spacelab-ufsc/obdh2/README.md

<h1 align="center">
	ON-BOARD DATA HANDLING 2.0
	<br>
</h1>

<h4 align="center">On-board computer module designed and developed by SpaceLab.</h4>

<p align="center">
	<a href="https://github.com/spacelab-ufsc/spacelab#versioning">
		
	</a>
	<a href="https://github.com/spacelab-ufsc/obdh2/releases">
		
	</a>
	<a href="https://github.com/spacelab-ufsc/obdh2/releases">
		
	</a>
	<a href="https://github.com/spacelab-ufsc/obdh2/commits/master">
		
	</a>
	<a href="https://github.com/spacelab-ufsc/obdh2/issues">
		
	</a>
	<a href="https://github.com/spacelab-ufsc/obdh2/graphs/contributors">
		
	</a>
</p>

<p align="center">
    <a href="#overview">Overview</a> •
    <a href="#repository-organization">Repository Organizarion</a> •
    <a href="#documentation">Documentation</a> •
    <a href="#license">License</a> •
    <a href="#releases">Releases</a> •
    <a href="#notes">Notes</a>
</p>

<p align="center">
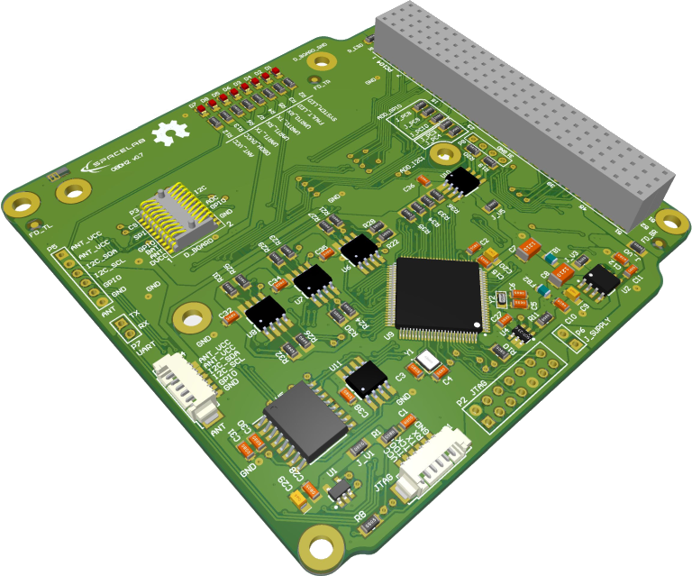
[picture p1: doc/user_manual/img/obdh2-pcb-3d.png]
	
</p>

## Overview

The SpaceLab OBDH 2.0 (On-Board Data Handling 2.0) is one of the service modules developed for the FloripaSat-2 Cubesat platform. The OBDH 2.0 is responsible to synchronize actions and the data flow between other modules (ie. EPS, Payloads) and the Earth segment. It packs the generated data into data frames and transmit back to Earth through TTC module, or stores it on a non-volatile memory for later retrieval. Commands sent from Earth segment to the CubeSat will be received by the radio transceivers located in the TTC module and redirected to the OBDH 2.0, which takes the appropriate action or forward them to the responsible module.

## Repository Organization

- **doc**: Technical documentation (including an user manual and an slide presentation).
- **firmware**: Source files of the firmware project.
- **hardware**: Source files of the hardware project.

## Documentation

The main documentation of the project can be seen [here](https://spacelab-ufsc.github.io/obdh2/).

## License

This project is open-source under three different licenses: GNU General Public License v3.0 for firmware sources, CERN Open Hardware License v2.0 for hardware files, and CC BY-SA 4.0 for the documentation. Some third-part files and libraries are subjected to their specific terms and licenses.

## Releases

The OBDH 2.0 software and hardware releases are synchronized in order to garantee compatibility. Then, using diferent versions might lead to unpredictable behavior. Refer to the [documentation](https://spacelab-ufsc.github.io/obdh2/) for compatibility notes.

## Notes

More info about the SpaceLab: [GitHub](https://github.com/spacelab-ufsc/spacelab) or [Website](https://spacelab.ufsc.br/)
