spacelab-ufsc/obdh2/firmware/drivers/cy15x102qn/README.md

# Cypress CY15V102QN/CY15B102QN FRAM Memory Driver
