spacelab-ufsc/obdh2/firmware/drivers/tps382x/README.md

# TPS382x Voltage Monitor With Watchdog Timer

If WDI remains high or low longer than the timeout period, then reset is triggered. The timer clears when reset is asserted or when WDI sees a rising edge or a falling edge.

## Reference

[1](https://www.ti.com/lit/ds/symlink/tps3828.pdf) SLVS165L - TPS382x Voltage Monitor With Watchdog Timer
