spacelab-ufsc/obdh2/doc/presentation/sections/documentation.tex

%
% documentation.tex
%
% Copyright (C) 2022 by SpaceLab.
%
% OBDH 2.0 Module
%
% This work is licensed under the Creative Commons Attribution-ShareAlike 4.0
% International License. To view a copy of this license,
% visit http://creativecommons.org/licenses/by-sa/4.0/.
%

%
% \brief Documentation slides.
%
% \author Gabriel Mariano Marcelino <gabriel.mm8@gmail.com>
% \author Bruno Benedetti <brunobenedetti45@gmail.com>
%
% \version 0.1.0
%
% \date 2022/08/07
%

\begin{frame}{Documentation}

    \begin{itemize}
        \item User manual (PDF)
        \vspace{0.4cm}
        \item This presentation
        \vspace{0.4cm}
        \item Schematics
        \vspace{0.4cm}
        \item Firmware: Doxygen
    \end{itemize}

\end{frame}
