spacelab-ufsc/obdh2/doc/presentation/sections/management.tex

%
% management.tex
%
% Copyright (C) 2022 by SpaceLab.
%
% OBDH 2.0 Module
%
% This work is licensed under the Creative Commons Attribution-ShareAlike 4.0
% International License. To view a copy of this license,
% visit http://creativecommons.org/licenses/by-sa/4.0/.
%

%
% \brief Project management slides.
%
% \author Gabriel Mariano Marcelino <gabriel.mm8@gmail.com>
% \author Bruno Benedetti <brunobenedetti45@gmail.com>
%
% \version 0.1.0
%
% \date 2022/07/28
%

\begin{frame}{Project Management}

    \begin{itemize}
        \item Activities, tasks and bug report: GitHub issues/project
        \vspace{0.25cm}
        \item Source files and versioning control: Public \href{https://github.com/spacelab-ufsc/obdh2}{\textcolor{blue}{Git repository}} with three development branches:
            \begin{itemize}
                \item \textit{dev\_doc}: Documentation
                \item \textit{dev\_hardware}: Hardware project
                \item \textit{dev\_firmware}: Firmware project
            \end{itemize}
    \end{itemize}

    \begin{figure}[!ht]
        \begin{center}
            
        \end{center}
    \end{figure}

\end{frame}
