spacelab-ufsc/obdh2/hardware/outputs/board_drc/board_drc.html

Altium

# Design Rule Verification Report

Date: | | 6/4/2021
Time: | | 4:35:57 PM
Elapsed Time: | | 00:00:02
Filename: | | C:\Users\Yan Azeredo\Desktop\SpaceLab\obdh2\hardware\sources\board_layout.pcbdoc

Warnings: | | 0
Rule Violations: | | 0

## Summary

Warnings | Count
Total | 0

Rule Violations | Count
Clearance Constraint (Gap=10mil) (InNet('GND')),(All) | 0
Clearance Constraint (Gap=7mil) (All),(All) | 0
Clearance Constraint (Gap=10mil) (OnLayer('Multi-Layer')),(OnLayer('Keep-Out Layer')) | 0
Clearance Constraint (Gap=10mil) (InNet('ESD') And OnLayer('Multi-Layer')),(OnLayer('Keep-Out Layer')) | 0
Short-Circuit Constraint (Allowed=No) (All),(All) | 0
Un-Routed Net Constraint ( (All) ) | 0
Width Constraint (Min=5mil) (Max=70mil) (Preferred=10mil) (All) | 0
Width Constraint (Min=20mil) (Max=30mil) (Preferred=20mil) (InNetClass('Power')) | 0
Routing Layers(All) | 0
Routing Via (MinHoleWidth=11.811mil) (MaxHoleWidth=35.433mil) (PreferredHoleWidth=11.811mil) (MinWidth=23.622mil) (MaxWidth=59.055mil) (PreferedWidth=23.622mil) (All) | 0
Power Plane Connect Rule(Relief Connect )(Expansion=20mil) (Conductor Width=10mil) (Air Gap=10mil) (Entries=4) (All) | 0
Power Plane Connect Rule(Direct Connect )(Expansion=20mil) (Conductor Width=10mil) (Air Gap=10mil) (Entries=4) (InNetClass('power')) | 0
Hole Size Constraint (Min=1mil) (Max=200mil) (All) | 0
Hole To Hole Clearance (Gap=10mil) (All),(All) | 0
Minimum Solder Mask Sliver (Gap=0mil) (All),(All) | 0
Silk To Solder Mask (Clearance=0mil) (IsPad),(All) | 0
Silk to Silk (Clearance=5mil) (All),(All) | 0
Net Antennae (Tolerance=0mil) (All) | 0
Component Clearance Constraint ( Horizontal Gap = 10mil, Vertical Gap = 10mil ) (All),(All) | 0
Height Constraint (Min=0mil) (Max=1000mil) (Prefered=500mil) (All) | 0
Total | 0
