spacelab-ufsc/obdh2/doc/presentation/figures/brazil-south.jpeg

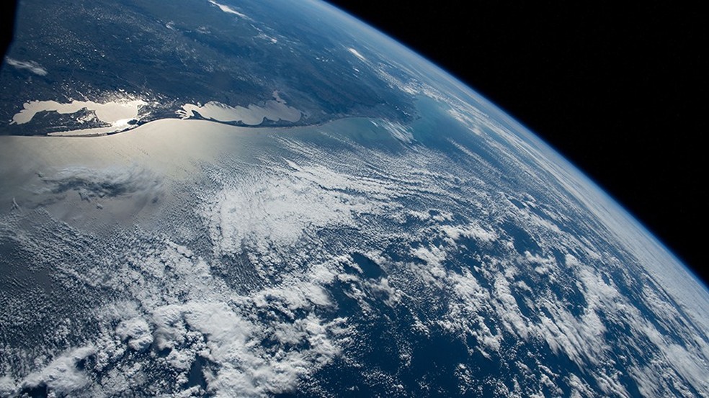
doc/presentation/figures/brazil-south.jpeg
