spacelab-ufsc/obdh2/firmware/doc/spacelab.png

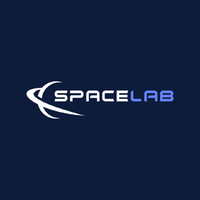
firmware/doc/spacelab.png
