spacelab-ufsc/obdh2/hardware/images/0_db_layout_position.png

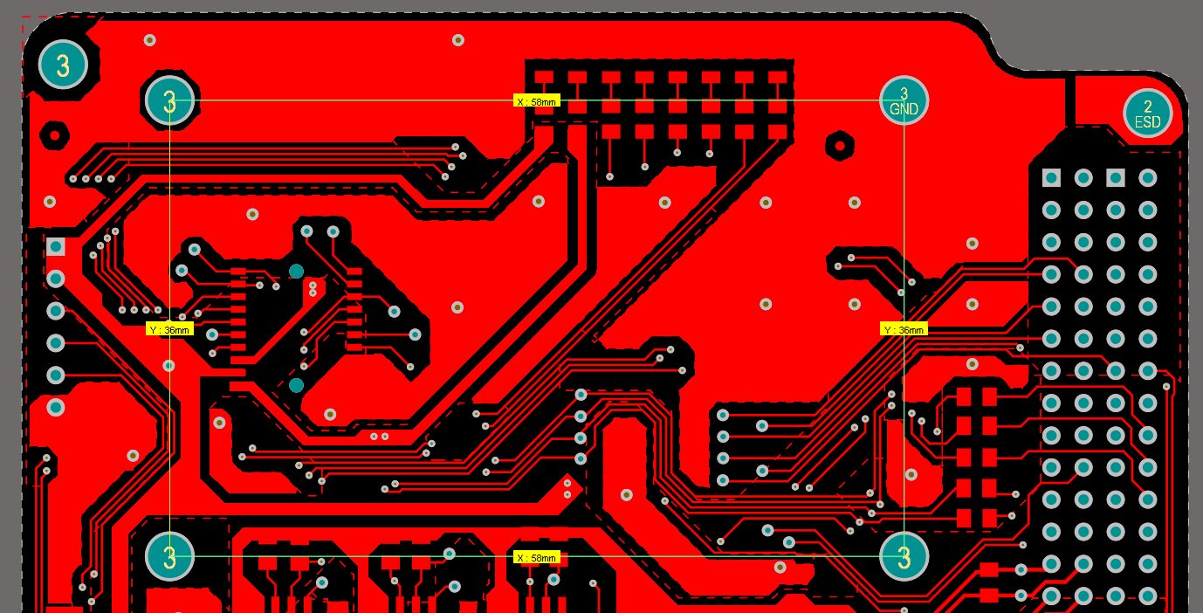
hardware/images/0_db_layout_position.png
