spacelab-ufsc/obdh2/hardware/images/1_db_board_position.png

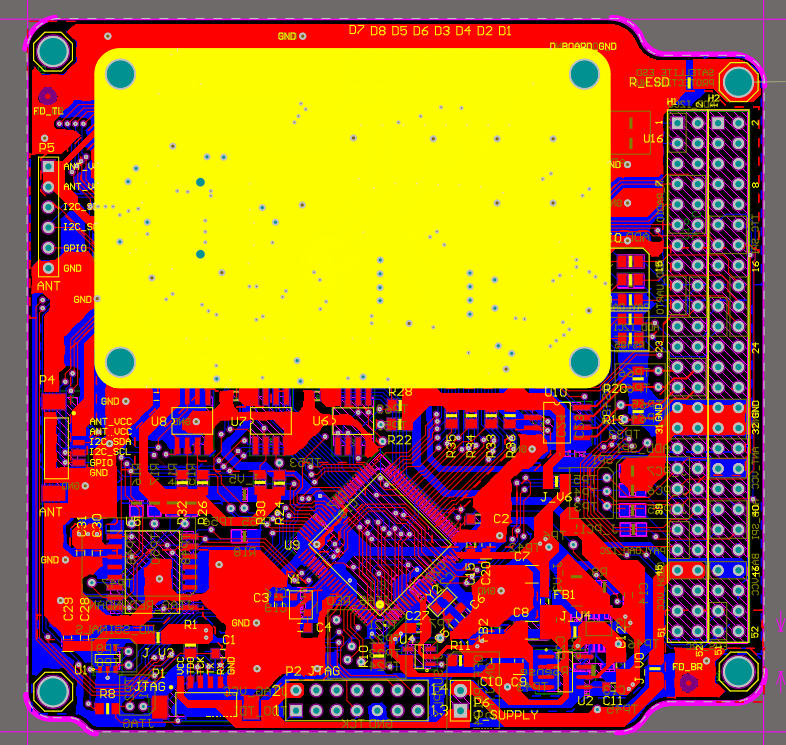
hardware/images/1_db_board_position.png
