spacelab-ufsc/obdh2/hardware/images/2_db_board_size.png

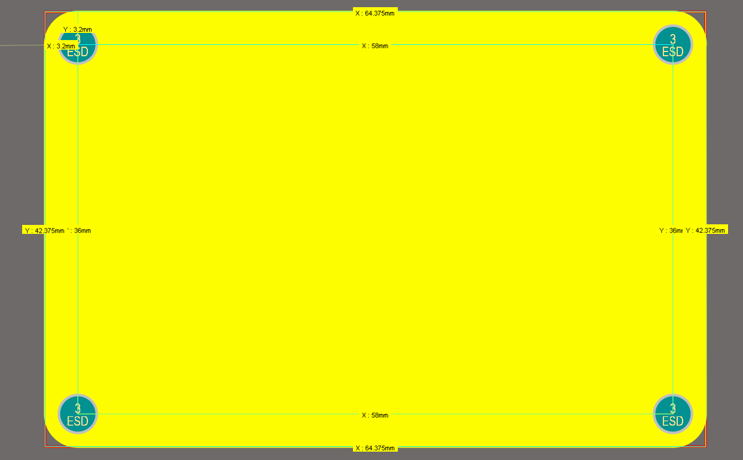
hardware/images/2_db_board_size.png
