spacelab-ufsc/obdh2/hardware/images/3_db_connector_position.png

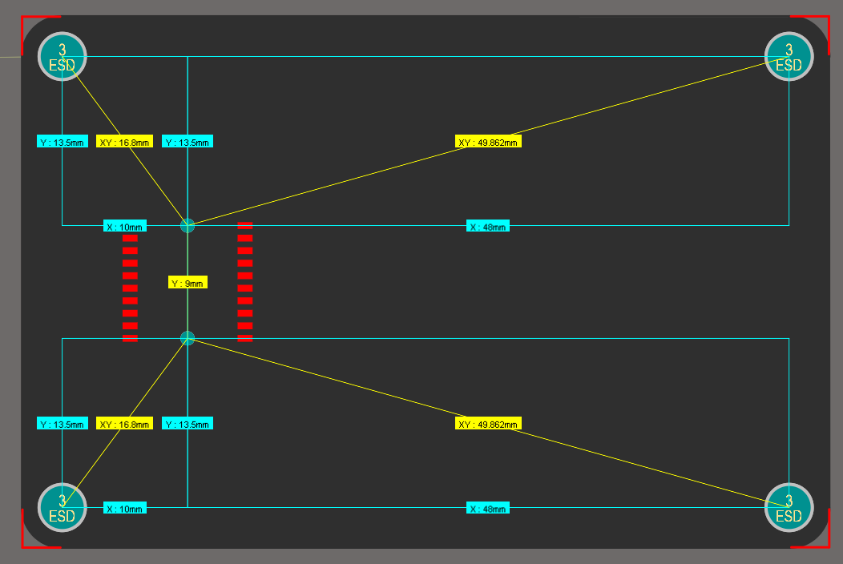
hardware/images/3_db_connector_position.png
