spacelab-ufsc/obdh2/hardware/images/4_db_connector_size.png

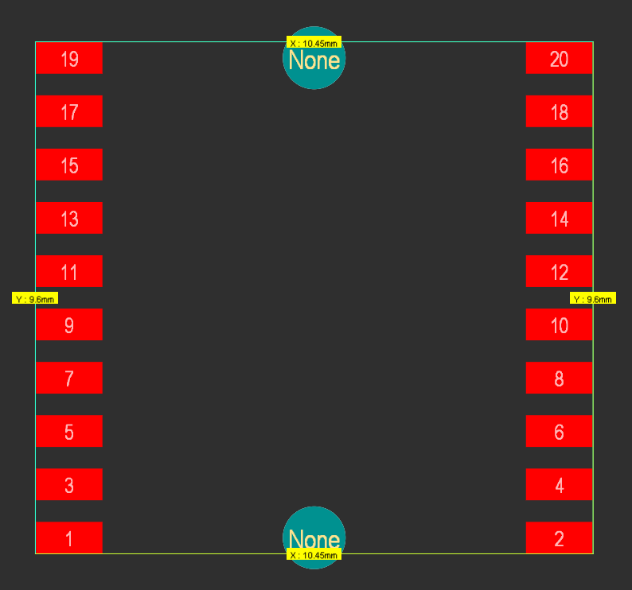
hardware/images/4_db_connector_size.png
