spacelab-ufsc/obdh2/hardware/images/5_db_pads_position.png

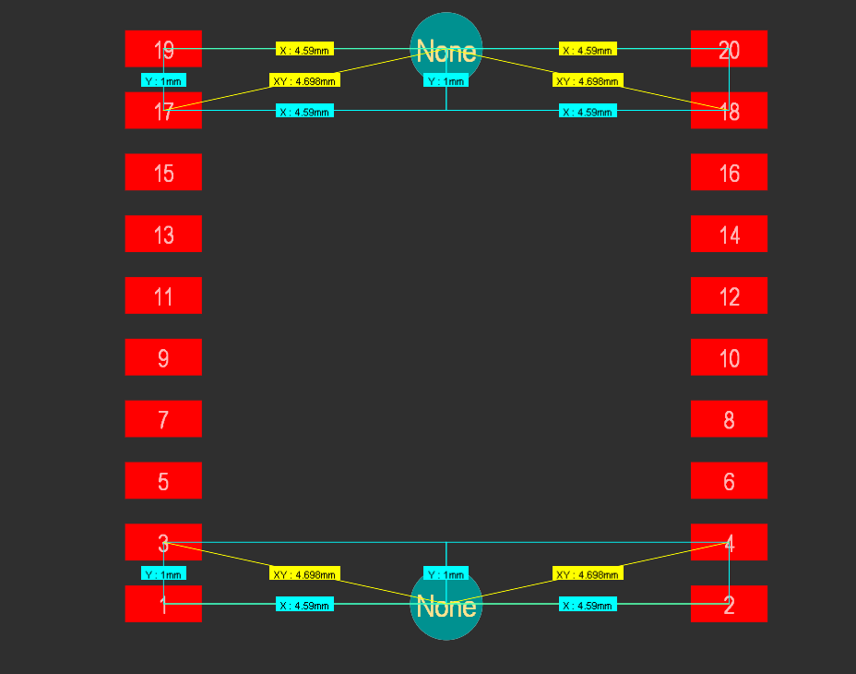
hardware/images/5_db_pads_position.png
