spacelab-ufsc/obdh2/hardware/images/6_db_pads_size.png

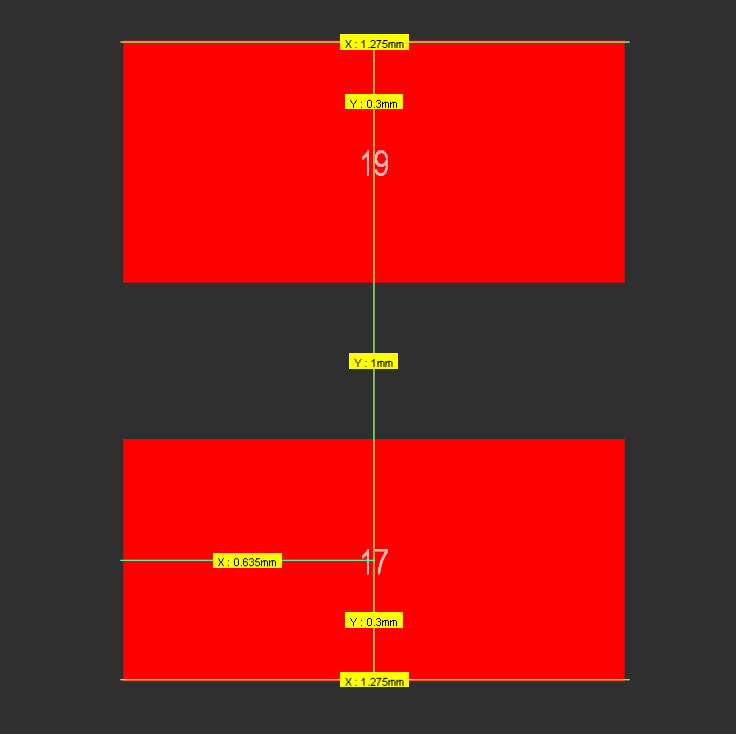
hardware/images/6_db_pads_size.png
