spacelab-ufsc/obdh2/hardware/images/7_db_connector_hole_size.png

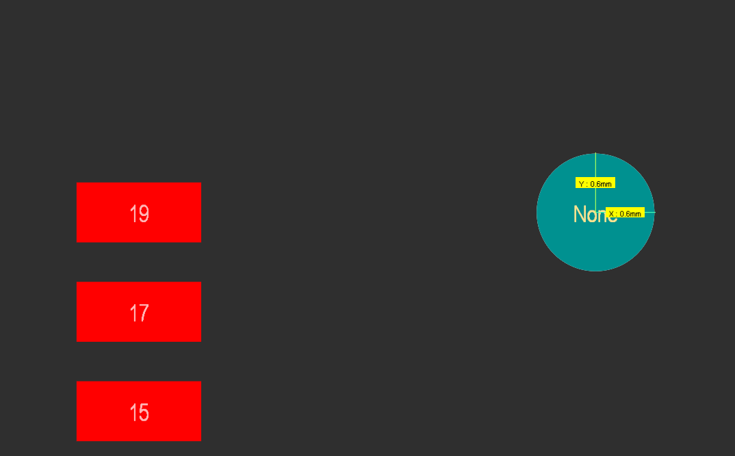
hardware/images/7_db_connector_hole_size.png
