spacelab-ufsc/obdh2/hardware/images/8_db_obdh_board_nut_size.png

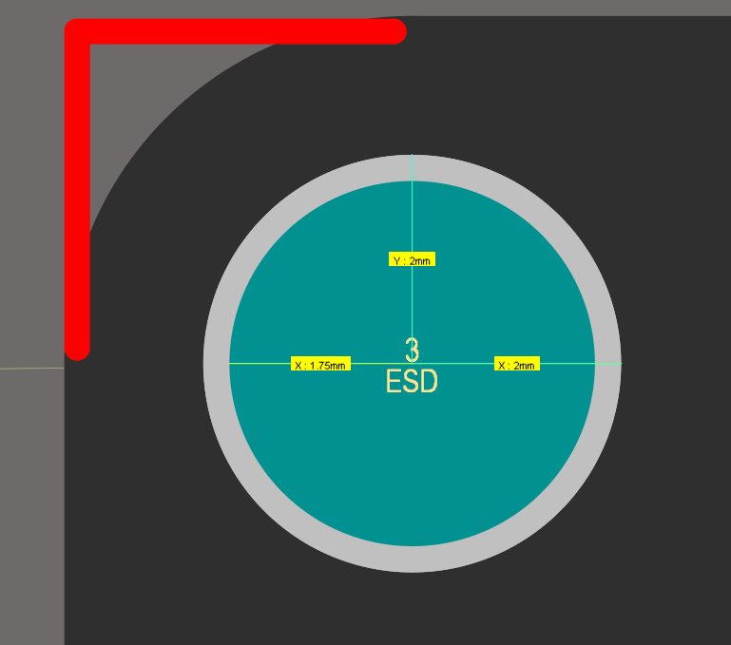
hardware/images/8_db_obdh_board_nut_size.png
