spacelab-ufsc/obdh2/hardware/images/power_architecture_v05.png

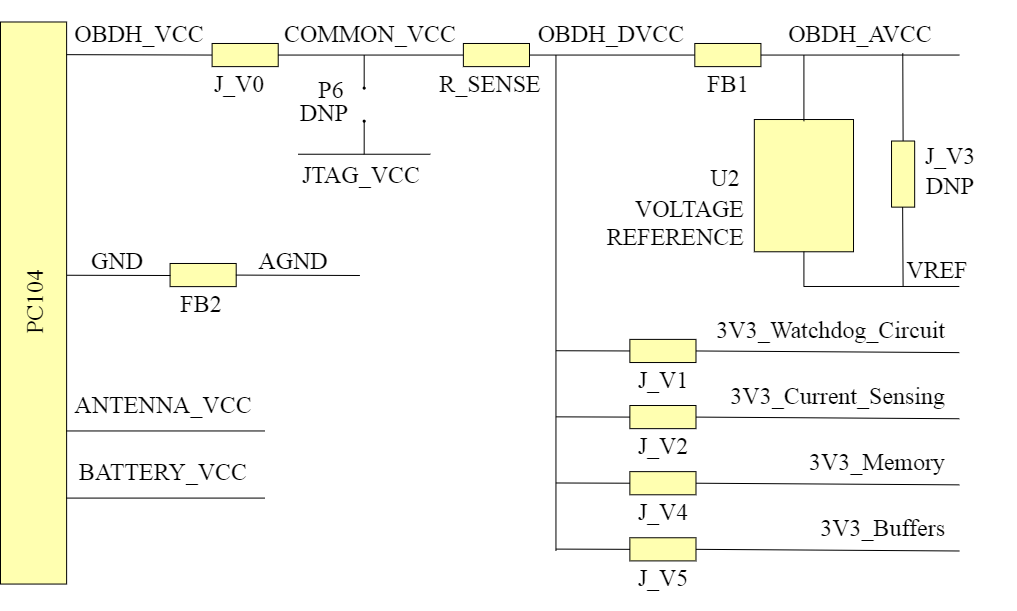
hardware/images/power_architecture_v05.png
