spacelab-ufsc/obdh2/doc/user_manual/index.rst

.. index.rst

   Copyright The OBDH 2.0 Contributors.

   OBDH 2.0 Documentation

   This work is licensed under the Creative Commons Attribution-ShareAlike 4.0
   International License. To view a copy of this license,
   visit http://creativecommons.org/licenses/by-sa/4.0/.

********
OBDH 2.0
********

The OBDH 2.0 is an on-board computer module designed by SpaceLab for nanosatellite missions. This manual describes its architecture, hardware, firmware, assembly, operation, telemetry, communication packets, and hardware test results.

.. toctree::
   :maxdepth: 3
   :caption: Documentation

   introduction
   system_overview
   hardware
   firmware
   assembly
   instructions
   references

.. toctree::
   :maxdepth: 3
   :caption: Appendix

   telemetry
   packets
   test_report_v05
   test_report_v07
