spacelab-ufsc/obdh2/doc/user_manual/img/system_layers.pdf

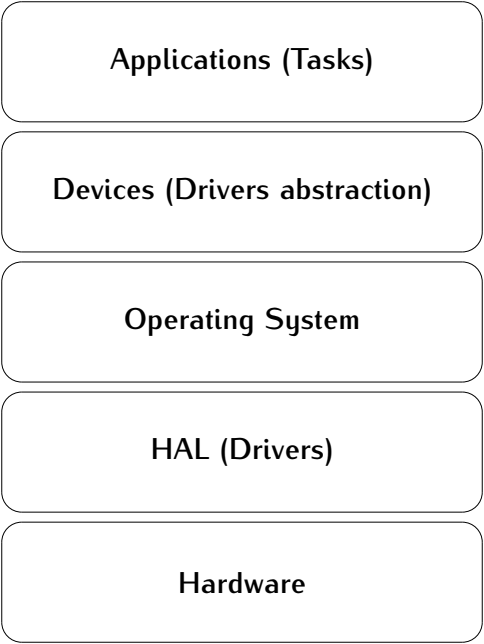
[picture p67: figure]

HAL (Drivers) Operating System Devices (Drivers abstraction) Applications (Tasks) Hardware
