spacelab-ufsc/obdh2/doc/user_manual/README.md

<h1 align="center">
    OBDH2 DOCUMENTATION
    <br>
</h1>

<h4 align="center">Documentation of the OBDH2 Module.</h4>

<p align="center">
    <a href="https://github.com/spacelab-ufsc/spacelab#versioning">
        
    </a>
    <a href="https://github.com/spacelab-ufsc/obdh2/releases">
        
    </a>
    <a href="https://github.com/spacelab-ufsc/obdh2/actions">
        
    </a>
    <a href="">
        
    </a>
    <a href="#license">
        
    </a>
</p>

<p align="center">
    <a href="#dependencies">Dependencies</a> •
    <a href="#building">Building</a> •
    <a href="#license">License</a>
</p>

## Dependencies

The Python dependencies required to build this documentation are listed in [`requirements.txt`](requirements.txt):

* [sphinx-rtd-theme](https://pypi.org/project/sphinx-rtd-theme/)
* [sphinxcontrib-bibtex](https://pypi.org/project/sphinxcontrib-bibtex/)
* [sphinx-subfigure](https://pypi.org/project/sphinx-subfigure/)

## Building

After installing the dependencies, generate the HTML documentation with:

```sh
make html
```

### Generating the PDF file

With a LaTeX toolchain installed, run:

```sh
make latexpdf
```

## License

This documentation is licensed under the Creative Commons Attribution-ShareAlike 4.0 International license (CC BY-SA 4.0).
