spacelab-ufsc/obdh2/doc/user_manual/pdf-index.rst

.. pdf-index.rst

   Copyright The OBDH 2.0 Contributors.

   OBDH 2.0 Documentation

   This work is licensed under the Creative Commons Attribution-ShareAlike 4.0
   International License. To view a copy of this license,
   visit http://creativecommons.org/licenses/by-sa/4.0/.

**********************
OBDH 2.0 Documentation
**********************

.. toctree::
   :maxdepth: 3

   introduction
   system_overview
   hardware
   firmware
   assembly
   instructions
   references

.. raw:: latex

   \begin{appendices}

.. toctree::
   :maxdepth: 3

   telemetry
   packets
   test_report_v05
   test_report_v07

.. raw:: latex

   \end{appendices}
