spacelab-ufsc/obdh2/doc/user_manual/img/data_path_diagram.png

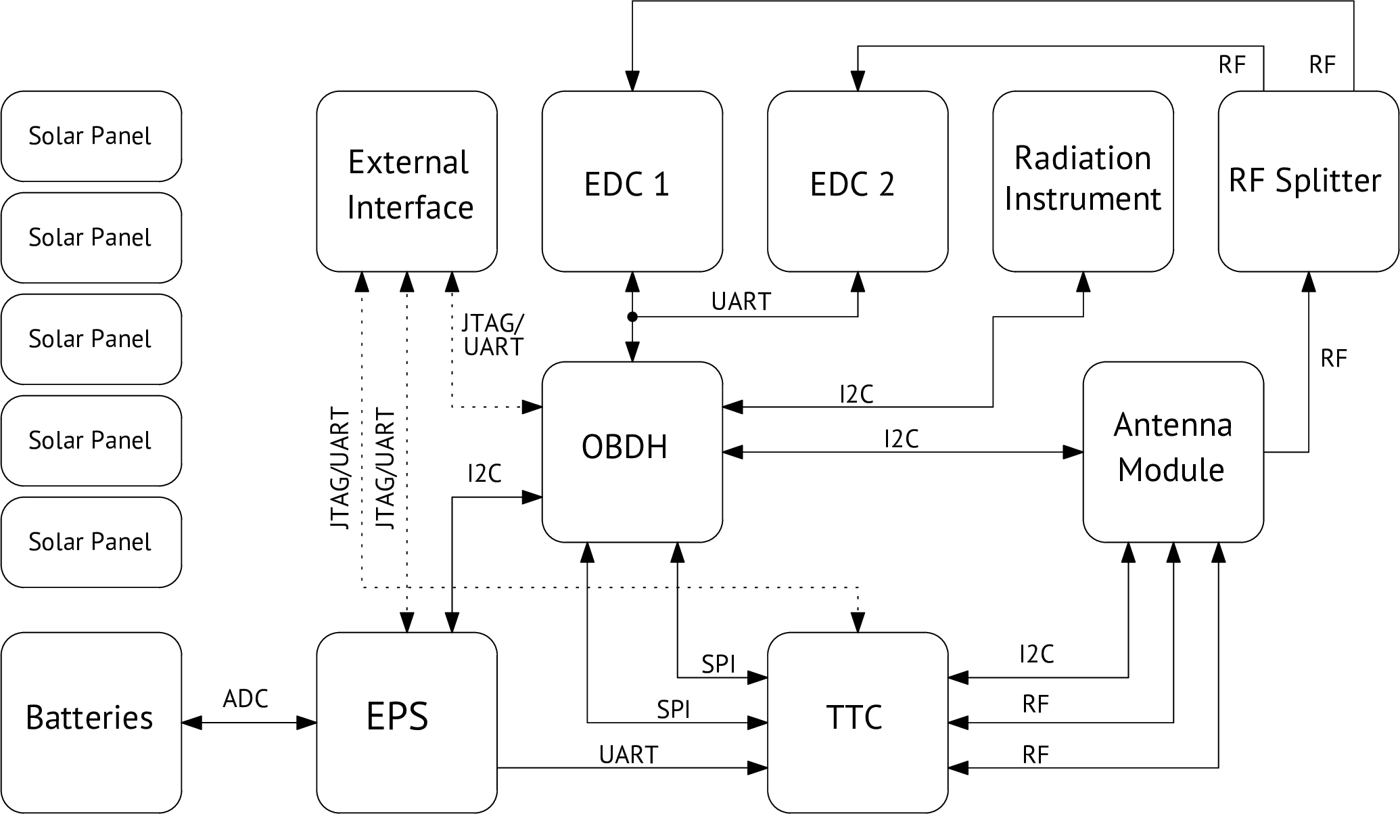
doc/user_manual/img/data_path_diagram.png
