spacelab-ufsc/obdh2/doc/user_manual/img/diagram_interfaces.png

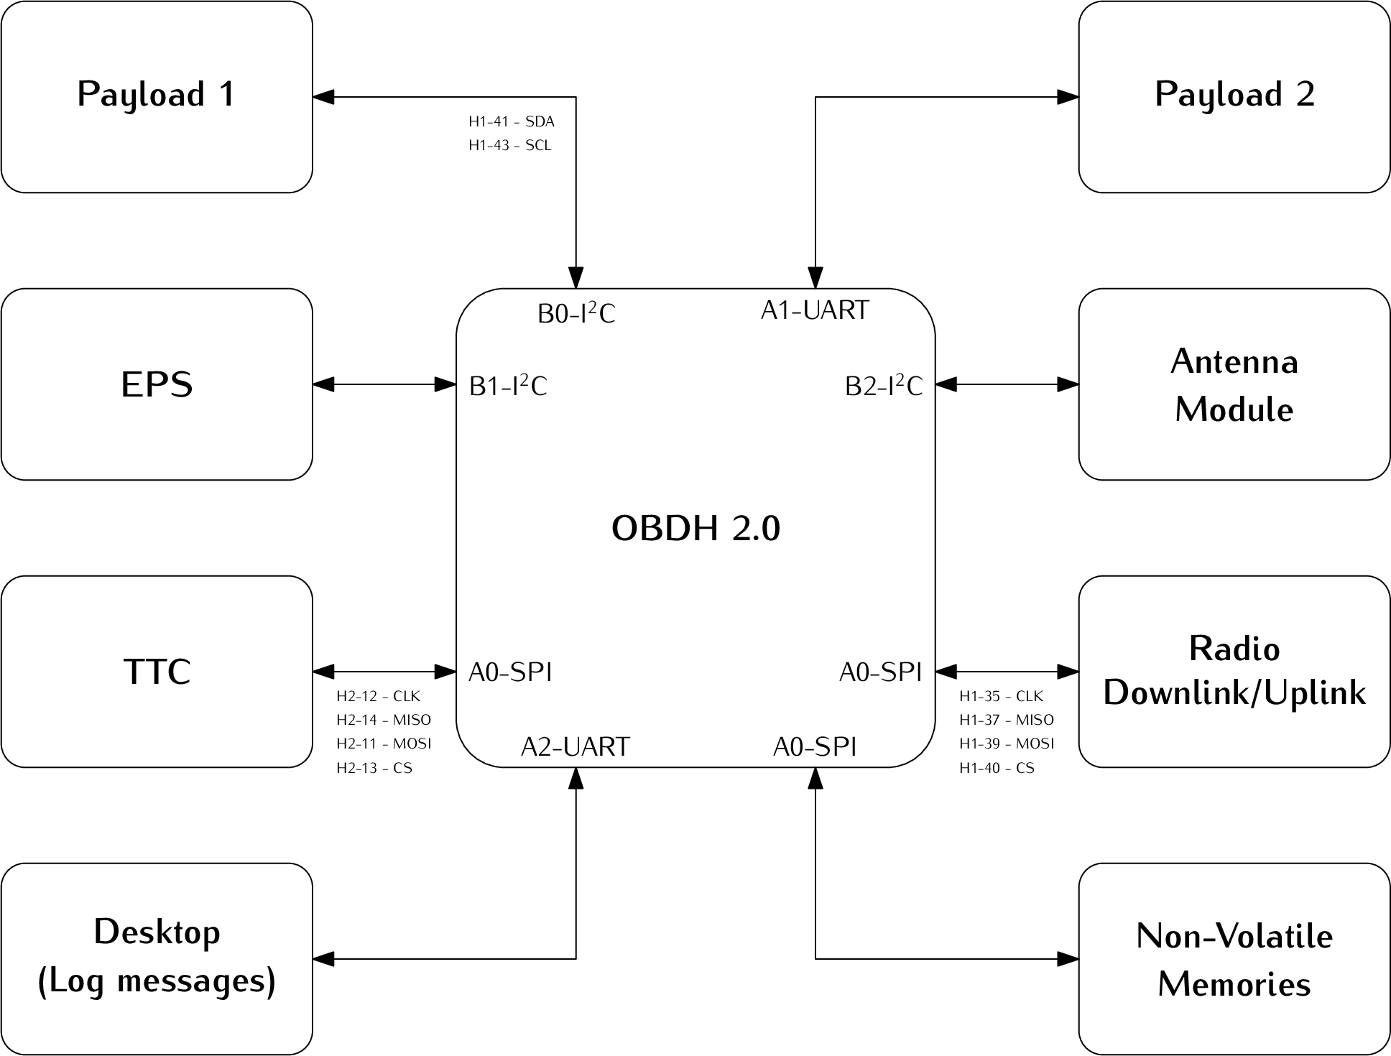
doc/user_manual/img/diagram_interfaces.png
