spacelab-ufsc/obdh2/doc/user_manual/img/esd-resistor.png

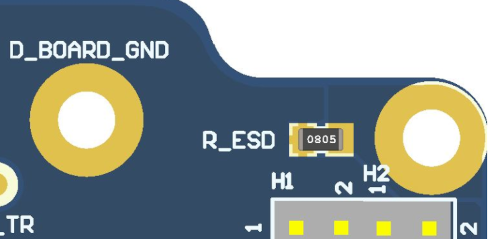
doc/user_manual/img/esd-resistor.png
