spacelab-ufsc/obdh2/doc/user_manual/img/flowchart_antenna_deploy_routine.png

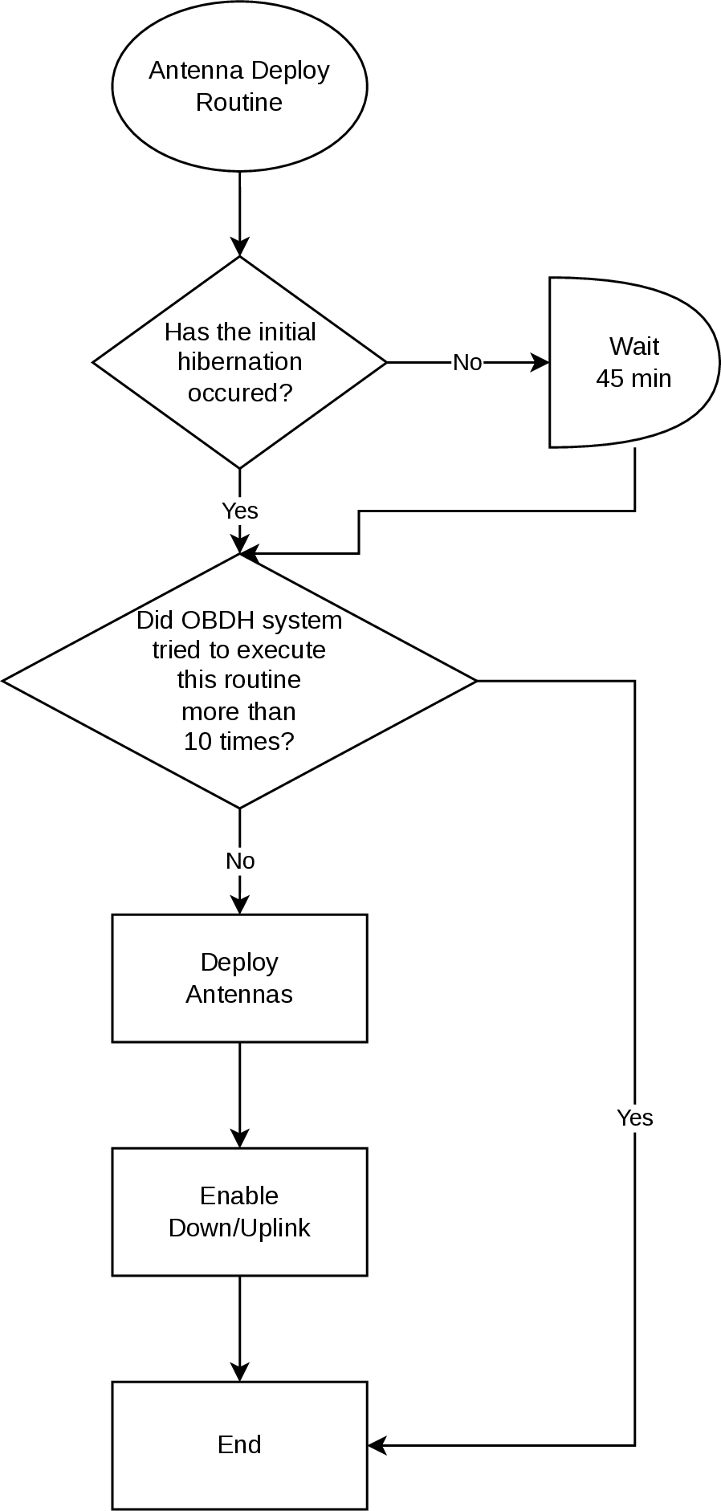
doc/user_manual/img/flowchart_antenna_deploy_routine.png
