spacelab-ufsc/obdh2/doc/user_manual/img/flowchart_obdh_boot_sequence.png

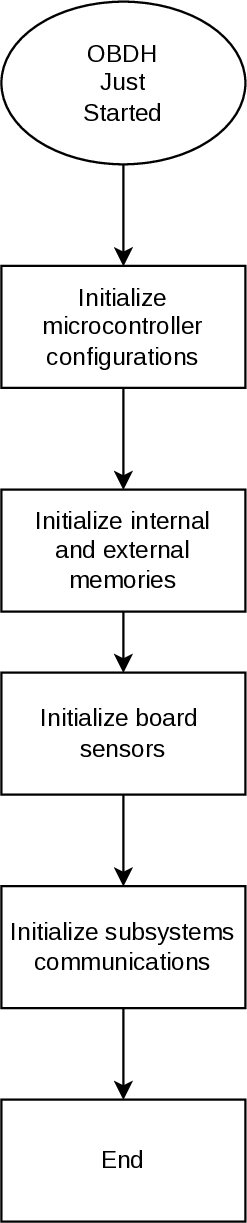
doc/user_manual/img/flowchart_obdh_boot_sequence.png
