spacelab-ufsc/obdh2/doc/user_manual/img/ngham_block_v4.png

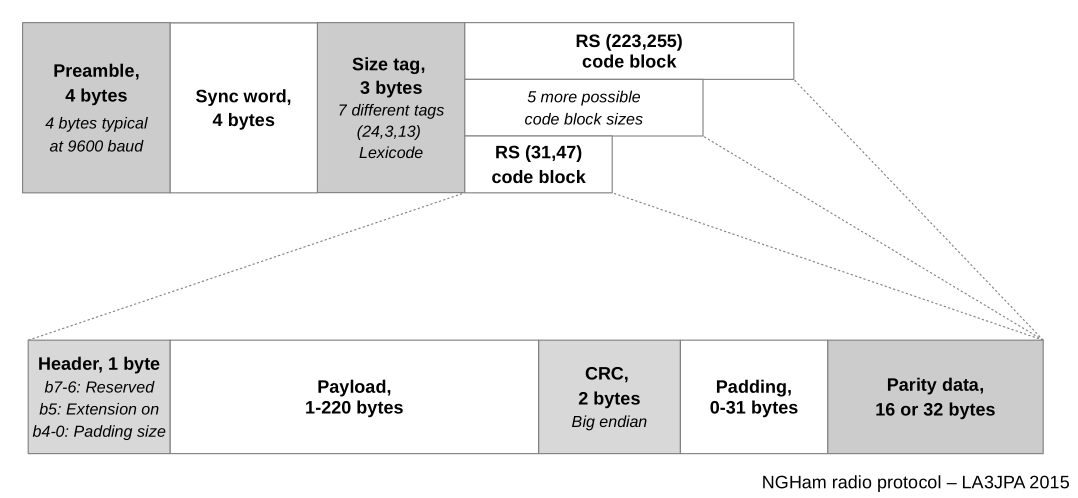
doc/user_manual/img/ngham_block_v4.png
