spacelab-ufsc/obdh2/doc/user_manual/img/p8-connector.png

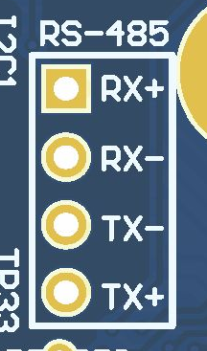
doc/user_manual/img/p8-connector.png
