spacelab-ufsc/obdh2/doc/user_manual/img/product-tree-fw.png

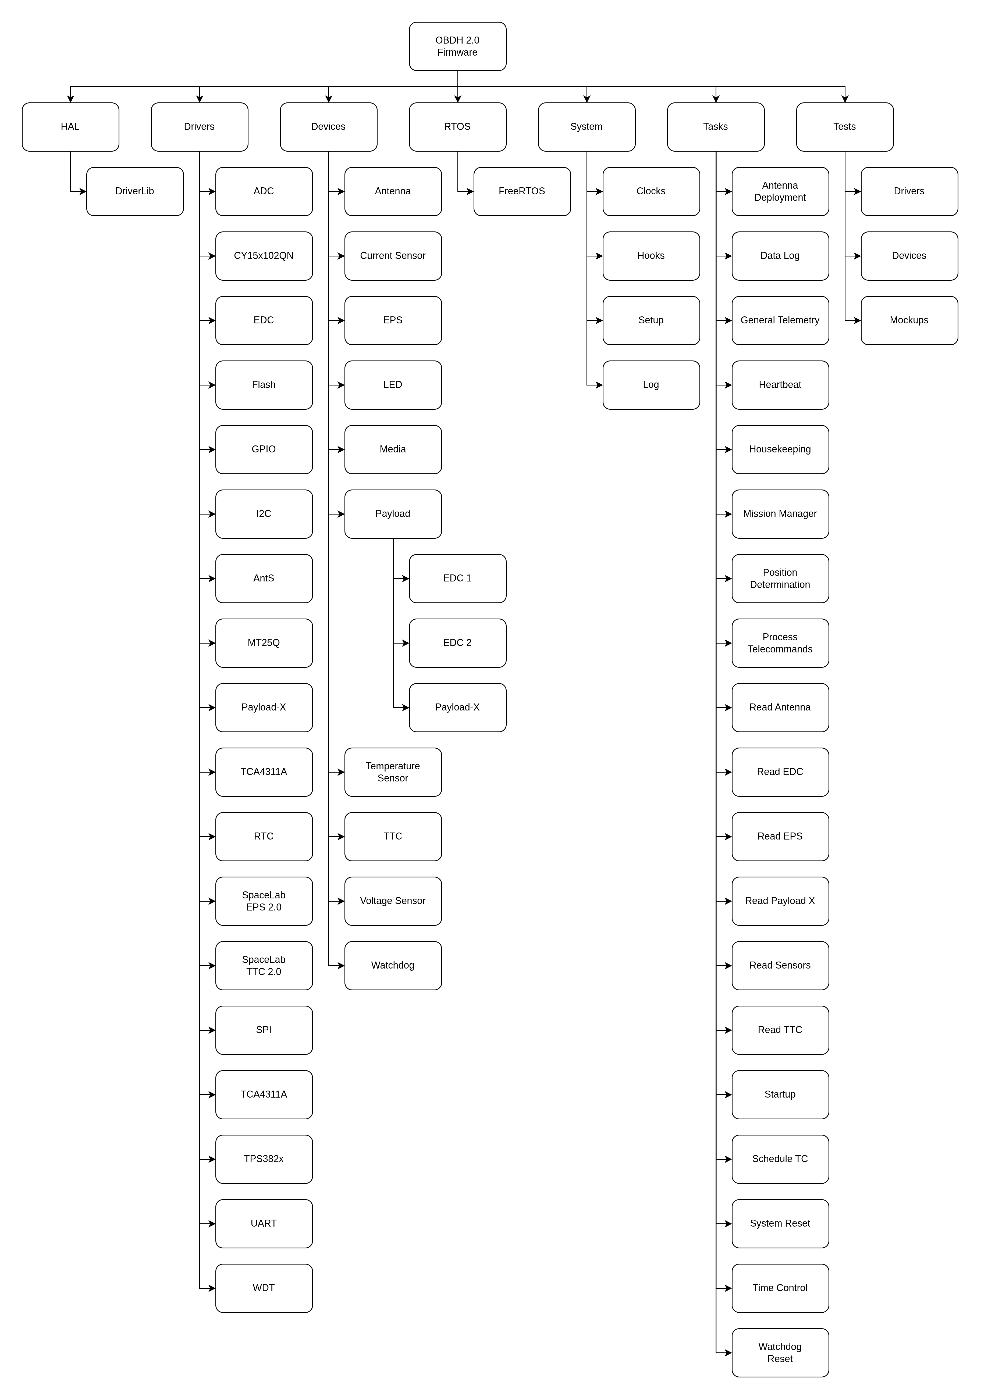
doc/user_manual/img/product-tree-fw.png
