spacelab-ufsc/obdh2/doc/user_manual/img/tc-flowchart.png

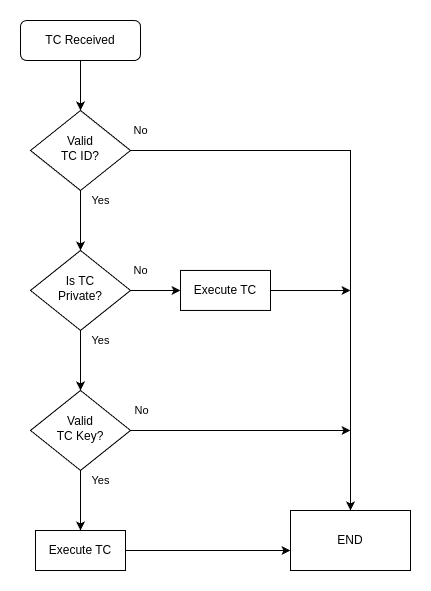
doc/user_manual/img/tc-flowchart.png
