spacelab-ufsc/obdh2/doc/user_manual/img/version-resistors.png

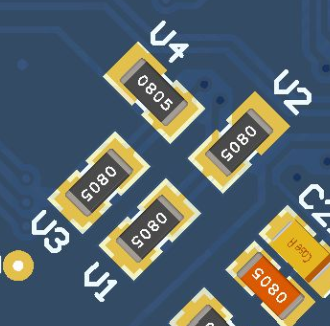
doc/user_manual/img/version-resistors.png
