spacelab-ufsc/obdh2/firmware/tests/README.md

# Unit tests

This folder contains the unit tests of the firmware, using the [cmocka](https://cmocka.org/) framework. The tests are divided according to the firmware layers:

* drivers
* devices

## Dependencies

* cmocka v1.1.5

## Executing the tests

* TBD
