spacelab-ufsc/obdh2/firmware/tests/drivers/README.md

# Unit tests of the drivers

* CY15x102QN
* TPS382x
* TCA4311A
* EDC
* ISIS Antenna
* Payload-X
* SpaceLab EPS 2.0
* MT25Q
* SpaceLab TTC 2.0
