spacelab-ufsc/obdh2/firmware/tests/mockups/README.md

# Mockups of the unit tests

## Drivers

* ADC
* CY15x102QN
* Flash
* GPIO
* I2C
* ISIS Antenna
* MT25Q
* Payload-X
* Si446x
* SpaceLab EPS 2.0
* SpaceLab TTC 2.0
* SPI
* TPS382x
* UART
* Watchdog

## Devices

* Antenna
* Current Sensor
* EPS
* LEDs
* Media
* Payload
* Temperature Sensor
* Voltage Sensor
* Watchdog
