spacelab-ufsc/obdh2/firmware/tests/devices/README.md

# Unit tests of the devices

* Antenna
* Current sensor
* EPS
* LEDs
* Media
* Temperature sensor
* TTC
* Voltage sensor
* Watchdog
