spacelab-ufsc/obdh2/(threads)

Thread 2 (2019-10-26):

Firmware: Define and organize the firmware structure

mgm8, 2019-10-26:
Possible folder structure:

* **config**: Configuration parameters
* **hal**: Hardware Abstraction Layer
* **drivers**: Peripherals drivers
* **devices**: System devices
* **os**: Operation system files
* **app**: Application layer files

mgm8, 2020-01-26:
Final folder structure:

* **config**: Configuration parameters
* **hal**: Hardware Abstraction Layer
* **drivers**: Peripherals drivers
* **system**: System configuration and management routines
* **devices**: System devices
* **freertos**: Operation system files
* **app**: Application layer files

Closed 2020-01-26.

Thread 30 (2019-12-03):

Hardware: Develop the circuit of the MT25QL01GBBB memory IC

mgm8, 2019-12-03:

mgm8, 2019-12-05:
From the [datasheet](https://www.micron.com/-/media/client/global/documents/products/data-sheet/nor-flash/serial-nor/mt25q/die-rev-b/mt25q_qlkt_l_01g_bbb_0.pdf) (page 79):

*"Normal precautions must be taken for supply line decoupling to stabilize the VCC supply. Each device in a system should have the VCC line decoupled by a suitable capacitor (**typically 100nF**) close to the package pins. At power-down, when VCC drops from the operating voltage to below the power-on-reset threshold voltage shown here, all operations are disabled and the device does not respond to any command."*

mgm8, 2019-12-05:
Reference design: [Technical Note - PCB Layout Design Guidelines](https://www.micron.com/-/media/client/global/documents/products/technical-note/nor-flash/tn2509_layout_guidelines_spi_nor_mt25q.pdf)

andrempmattos, 2019-12-11:
MT25QL01GBBB8ESF-0SIT

andrempmattos, 2019-12-12:
65a95e1f6fb60cf8cc9d04b45ac07585bf1c6b48

Closed 2020-01-11.

Thread 34 (2019-12-07):

Hardware: Define the OBDH 2.0 external interfaces pinout

andrempmattos, 2019-12-07:
- Define the EPS I2C and EDC Paylaod RS485 positions in PC104;
- Define preliminary daughter board pinout;
- Define connectors for each external interface;
- Define PC104 pinout (including more GPIOs and communication channels).

Closed 2019-12-29.

Thread 35 (2019-12-07):

Hardware: Define daughter board connector and compatibility

andrempmattos, 2019-12-07:
Define the daughter board connectors (GOMSpace compatible or regular header connection). Also, check for different active ADCS projects to design a generic communication interface.

mgm8, 2019-12-07:
Possible connector: [Samtec FSI-110-03-G-D-AD](https://www.samtec.com/products/fsi-110-03-g-d-ad)

Closed 2019-12-29.

Thread 44 (2019-12-12):

Hardware: Add low power termination resistors scheme

andrempmattos, 2019-12-12:
[https://e2e.ti.com/blogs_/b/analogwire/archive/2016/07/28/rs-485-basics-when-termination-is-necessary-and-how-to-do-it-properly](https://e2e.ti.com/blogs_/b/analogwire/archive/2016/07/28/rs-485-basics-when-termination-is-necessary-and-how-to-do-it-properly)

andrempmattos, 2020-04-29:
**Canceled**

Closed 2020-08-19.

Thread 47 (2019-12-12):

Hardware: Fix current sensing circuit

andrempmattos, 2019-12-12:
Fix the current sensing circuit vcc connection.

Closed 2019-12-13.

Thread 57 (2019-12-28):

Hardware: Change the organization logo in the schematics

mgm8, 2019-12-28:
Replace the FloripaSat logo for the SpaceLab logo.

mgm8, 2020-08-26:
f1a465ec37a490638793f909a9e72ac26ef11d2b

Closed 2020-08-26.

Thread 59 (2020-01-07):

Hardware: Add thermal relief in the power connections

andrempmattos, 2020-01-07:

mgm8, 2020-08-20:
@andrempmattos what is the status of this issue?

andrempmattos, 2020-08-20:
I added thermal relief in the ground connections, since they are the most affected during the soldering process.

Closed 2020-08-20.

Thread 83 (2020-01-24):

Firmware: Develop the "LEDs" device

mgm8, 2020-01-24:
Currently, there are two system LEDs:

* **SYSTEM LED**: To use as a heartbeat
* **FAULT LED**: To use as a critical fault indicator

Closed 2020-02-06.

Thread 92 (2020-01-28):

Firmware: Analyse the advantages of using software states

andrempmattos, 2020-01-28:
Analyse the advantages and side effects o using software states related to real conditions, such as: antennas deployment, normal operation, hibernation, critical failure, power saving, payloads operation and recovery mode.

**Example of usage and implementation:**
[Software Development for Galassia CubeSat-Design, Implementation and In-Orbit Validation](https://www.researchgate.net/publication/330555276)

Thread 94 (2020-01-28):

Architecture: Define a logger implementation for different abstraction layers

andrempmattos, 2020-01-28:
**Problem:** The current logger version was designed inside the software abstraction policy to fulfill the high level notifications and log messages. However, due to the necessity of logging low level events, this implementation would broke the abstraction layers, then creating archtecture and design flaws.

**Solution 1:** Create different loggers, one designed for high level notifications and other covering the low level messages. This approach is based on the Linux kernel mechanisms, which despite using different loggers can print the information in the same outputs (terminal, monitor, ...) and without conflicts by using shared devices (solved with mutexes).

**Enhancement:** Additionally, in order to improve the logging system or even settle a debug system, features could be implemented, such as: In/Out capabilities (inclusion of developer comands through terminal and emulation of parameters), telecommand to retrieve essential package of logging massages and errors and core status data saved into non volatile memory for future analysis.

Closed 2020-04-12.

Thread 98 (2020-01-29):

Hardware: Revision feedback bugfixes

andrempmattos, 2020-01-29:
**BugFixes:**

1. Create power diagram
2. Enable the net colors cross reference
3. Add reference to the daughter board in the diagrams
4. Fix clearence between tracks and pads (RS485 differential pair signals)
5. Improve general clearence for component pads and nuts

**Enhancement:**

1. Add teardrops for connections
2. Add thermal relief **(Not added, it creates poor conections in certain pads)**
3. Add a filter to the Voltage Buffer Circuit (similar to the Current Sensing Circuit)
4. Review the PC104 standard and usage **(Any robust and widespread standard found)**
5. Add alternative RS485 connector **(Under analysis)**
6. Add open hardware logo

andrempmattos, 2020-01-30:
043b8856e12bf89cc4499cd4cd2fb2a524c29d52
3e01a234e24926182118bc34782cc1dee63accf8
860d54dc51c09f1d4a72dd9a67b21db050eeb442
bfecad6a0b737f9f6846201c97b5de16a4eb8099
2300042af29ea938ca870e8bf3dc48429db692ad
101f4e4f5a9bfda3796d89c60856004e603d8ba2

andrempmattos, 2020-04-29:
9f95a1c9daa15962370b439e0b03559ff7d5ed4e

Closed 2020-04-29.

Thread 100 (2020-02-01):

Hardware: Add a pin header for the debug port

mgm8, 2020-02-01:
Now, the debug port is only available through the satellite interface connector (*P1*). A three position pin header (2,54 mm pitch) with TX, RX and GND, will make the development and tests phases easier.

Placement suggestion:
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

andrempmattos, 2020-04-29:
89e1bc8c90ebf1f832ae5d080c49557ac2904c17
c9e7176d734354e6fe43ce2643b2096f844870b2

Closed 2020-04-29.

Thread 119 (2020-03-03):

Firmware: Develop the "Read Temperature" task

mgm8, 2020-03-03:
This task must read the OBDH microcontroller temperature at every 60 seconds.

mgm8, 2020-07-30:
This task was moved to the "Read sensors" task #167

Closed 2020-07-30.

Thread 146 (2020-04-16):

Hardware: Fix board labels

mgm8, 2020-04-16:
* Fix the label "OBDH EM 2 ALT" to just "OBDH 2"
* Replace "FloripaSat-II" by "SpaceLab"
* Remove "2020" from "UFSC 2020"

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

Closed 2020-04-29.

Thread 152 (2020-04-30):

Hardware: Add a CAN bus to the board

mgm8, 2020-04-30:
Add the MCP25625 chip (SPI-CAN converter) to the board using the Bus 7 as input (TTC SPI) and adding the output CAN signal to the PC-104 bus.

Thread 159 (2020-06-24):

Hardware: Update the PC104 connector

andrempmattos, 2020-06-24:
Update the PC104 connector to the lower component (mechanical/integration issues).

andrempmattos, 2020-08-19:
The correct partnumber: SSW-126-01-G-D

Closed 2020-08-19.

Thread 174 (2020-08-12):

Hardware: Change the position of the UART1 port in the PC-104 bus

mgm8, 2020-08-12:
**Remove:**
* Remove the ADD_UART0_TX signal from the H1-17
* Remove the ADD_UART0_RX signal from the H1-19

**Add:**
* Add UART1_TX signal to the H1-19 pin of the PC-104 bus
* Add UART1_RX signal to the H1-20 pin of the PC-104 bus

andrempmattos, 2020-08-19:
**Changes performed:**
* Add UART1_TX signal to the H1-19 pin of the PC-104 bus
* Add UART1_RX signal to the H1-17 pin of the PC-104 bus

Closed 2020-08-19.

Thread 176 (2020-08-20):

Hardware: Review the LED auxiliary resistors

andrempmattos, 2020-08-20:

mgm8, 2021-02-20:
@andrempmattos can we close this issue?

andrempmattos, 2021-02-22:
@mgm8 Yes, we can. The issue was related to removing some non-essential LEDs for a more clean board, such as: UARTs, power for every power ports. In the end, since it is already done, we can remove them in the flight model design or just not soldering.

Closed 2021-02-22.

Thread 186 (2020-09-21):

Hardware: Fix the PC-104 connector BOM quantity and designator label

andrempmattos, 2020-09-21:

Closed 2020-12-10.

Thread 187 (2020-09-23):

Hardware: Fix the BOM generation to group components using partnumber instead of comments

andrempmattos, 2020-09-23:

Closed 2020-12-10.

Thread 188 (2020-09-23):

Documentation: Add an option sheet to the main documentation

mgm8, 2020-09-23:
Add an option sheet (as an appendix) with instructions about the necessary components for each optional circuit or montage.

andrempmattos, 2020-10-30:
@mgm8, it could be included in the assembly chapter instead of a seperated appendix...

Thread 198 (2020-11-02):

Hardware: Remove remaining 2H header 3D bodies

andrempmattos, 2020-11-02:

mgm8, 2021-02-20:
@andrempmattos can we close this issue?

andrempmattos, 2021-02-22:
This is nether a critical or bug issue. The idea is just to remove the 2H headers 3D bodies, since they are not soldered for the flight model. Now, they appear in the 3D model as can be seen in the image below. The major concern is to cause misunderstanding with the mechanical integration responsible. At least the highest height of this connectors not overcome the standard PC-104 height.

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

Closed 2021-06-03.

Thread 209 (2021-02-13):

Firmware: Develop the required mockups for the unit tests

mgm8, 2021-02-13:
For the unit tests, mockups of some drivers will be required.

Some examples:
* ADC
* I2C
* UART
* SPI
* Flash memory

Closed 2022-01-14.

Thread 225 (2021-03-06):

Documentation: Add the fabrication details of the PCB

mgm8, 2021-03-06:
* Material
* Number of layers
* Board thickness
* Recomended surface finishing
* Minimum spacing
* Via process
* Copper weight
* etc.

YanAzer, 2021-03-07:
@mgm8 @andrempmattos also is good to add a simple pcb stack up table alongside this fabrication details table, example:

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

Thread 227 (2021-03-21):

Readme: Update mission link name on main readme on the notes header

YanAzer, 2021-03-21:
Currently is still using the old link, it work but the name is wrong.

Thread 230 (2021-04-08):

Hardware: Use crystals with more precision

mgm8, 2021-04-08:
The temperature variance during the operation of the satellite causes frequency drifts. Crystals with more precision can minimizes this issue and consequently increase the time precision of the microcontroller. 5 ppm or lower will be a better value.

> TIP: Maybe there is a different partnumber with the same footprint, but with more precision.

Thread 232 (2021-04-17):

Hardware: Fix current sensor CS pin

andrempmattos, 2021-04-17:
Until it is not fixed, a simple turn around is to short the pins 6 and 7 of the IC with a solder point.

Closed 2021-06-03.

Thread 234 (2021-04-17):

Hardware: Review testpoints/0ohm resistors and remove the unnecessary ones

andrempmattos, 2021-04-17:

mgm8, 2021-05-15:
As the board is working pretty well, I think this issue is unnecessary.

Closed 2021-05-15.

Thread 235 (2021-04-17):

Hardware: Review the board labels against the correct pinout of the connector

andrempmattos, 2021-04-17:

Closed 2021-06-03.

Thread 237 (2021-04-18):

Hardware: Fix the part number of R9 and R37

mgm8, 2021-04-18:
The current part number of R9 and R37 is an 1K65 resistor, but the correct value is 12k.

Closed 2021-06-03.

Thread 259 (2021-05-28):

Add a FRAM or MRAM memory

mgm8, 2021-05-28:
Add an serial (SPI) FRAM or MRAM memory to work as a safe non-volatile memory.

andrempmattos, 2021-05-31:
https://br.mouser.com/ProductDetail/Cypress-Semiconductor/CY15B102QN-50SXE?qs=ZSypp649SOXHRJ8%252Bksax6A%3D%3D

https://br.mouser.com/ProductDetail/Everspin-Technologies/MR20H40CDF?qs=Wndy5wu9MT%2F2g3hlaIjBag%3D%3D

mgm8, 2021-05-31:
MR20H40CDF

Operating Supply Current: **46.5 mA** :open_mouth:

andrempmattos, 2021-05-31:
I am probably going to use the CY15B102QN-50SXE, it is more suitable for us...

Closed 2021-06-03.

Thread 268 (2021-06-16):

Hardware: Fix fabrication information on sheet layer for flight model

YanAzer, 2021-06-16:
Details such as: surface treatment, pcb color and specified no silkcreen need to be updated.

Thread 289 (2021-09-23):

Firmware: Fix the I2C access of the ISIS Antenna driver using the TCA4311A buffer

mgm8, 2021-09-23:
The ISIS Antenna is not accessed directly by the I2C port of the microcontroller, there is a I2C buffer between the devices (TCA4311A).

Closed 2022-01-14.

Thread 291 (2021-10-10):

Firmware: The system crashes on memory writing operations of the MT25Q driver

mgm8, 2021-10-10:
This behaviour appeared after the source code of the MT25Q driver became compliant with the MISRA-C standard.

Thread 310 (2022-03-13):

Firmware: Add the option to use the UART interface to the EDC driver

mgm8, 2022-03-13:
The current EDC's driver only supports the I2C interface. As the FloripaSat-2 mission will use an UART interface to communication with the EDC modules, this driver must have the option to access the EDC through an UART port.

References:
* EDC documentation: [https://gitlab.com/edc_team/doc/-/blob/master/EDC%20User%20Guide.pdf](https://gitlab.com/edc_team/doc/-/blob/master/EDC%20User%20Guide.pdf)
* UART driver: [https://github.com/spacelab-ufsc/obdh2/tree/dev_firmware/firmware/drivers/uart](https://github.com/spacelab-ufsc/obdh2/tree/dev_firmware/firmware/drivers/uart)
* FloripaSat-2 documentation: [slb-fsat2-doc-v0.2.pdf](https://spacelab-ufsc.github.io/floripasat2-doc/slb-fsat2-doc-v0.2.pdf)

Closed 2022-05-05.

Thread 311 (2022-03-15):

Firmware: Rename the ISISpace antenna driver to "AntS"

mgm8, 2022-03-15:
The correct name of the [UHF antenna module from ISISpace](https://www.isispace.nl/product/cubesat-antenna-system-1u-3u/) is "**AntS**".

Thread 312 (2022-04-19):

Hardware: Mount the PC-104 connector of the EM boards

mgm8, 2022-04-19:
The PC-104 connector of the EM boards is missing! Also, the used part number must be "reduced" before soldering into the board, as can be seen in the picture below:

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

Thread 331 (2023-03-16):

The OBDH2 cannot communicate with the Antenna

LucasAzulay, 2023-03-16:
We were testing the communication of the OBDH2 with the antenna. At first, the I2C communication between the OBDH2 and the antenna module fails. The OBDH2 I2C communication with the antenna is already completed?
Also, the connections between the Antenna and the OBDH are correct? (images 2 and 3)
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

miguelboing, 2023-03-20:
The antenna implementation was imported from OBDH 1.0 and wasn't tested in OBDH 2.0. I will look into it to see if I find the problem. But for now, could you run the dev_firmware code and tell me if there is any difference in the logs?

miguelboing, 2023-03-22:
Hello Lucas, the problem was related to the isis_antenna driver, during the initialization. If you change [this line](https://github.com/spacelab-ufsc/obdh2/commit/3d4fadd2005a108838dac9ee30150c8e7811b87b) the I2C bus will be able to correctly initialize.

Thread 334 (2023-07-18):

Firmware: Fix antenna deployment bugs

miguelboing, 2023-07-18:

miguelboing, 2023-07-18:
Change [this variable](https://github.com/spacelab-ufsc/obdh2/blob/ea90282b7a23f2b9ed4dfb7624de689eeb798563/firmware/app/tasks/antenna_deployment.c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) to the [correct one](https://github.com/spacelab-ufsc/obdh2/blob/ea90282b7a23f2b9ed4dfb7624de689eeb798563/firmware/app/structs/obdh_data.h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).

miguelboing, 2023-07-21:
Remove double [return](https://github.com/spacelab-ufsc/obdh2/blob/ea90282b7a23f2b9ed4dfb7624de689eeb798563/firmware/devices/antenna/antenna.c)

Thread 346 (2024-02-28):

Firmware: Add a mutex to protect access of the SPI bus.

c-porto, 2024-02-28:
Since there is multiple devices on the SPI bus, which are being accessed from different tasks, a mutex must be added to prevent concurrency issues.
