spacelab-ufsc/obdh2/hardware/outputs/board_draftsman/board_draftsman.PDF

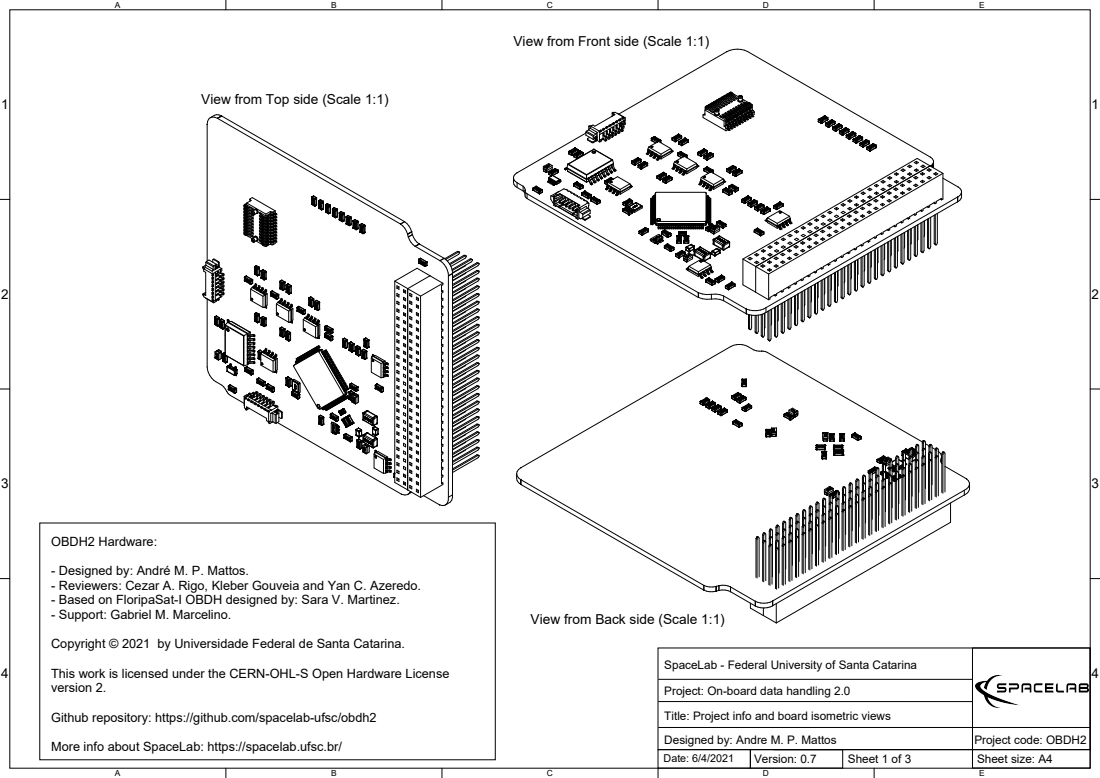
[picture p103: page 1]

View from Front side (Scale 1:1)

View from Top side (Scale 1:1)

- Designed by: André M. P. Mattos.
- Reviewers: Cezar A. Rigo, Kleber Gouveia and Yan C. Azeredo.
- Based on FloripaSat-I OBDH designed by: Sara V. Martinez.
- Support: Gabriel M. Marcelino.

View from Back side (Scale 1:1)

Copyright © 2021 by Universidade Federal de Santa Catarina.

SpaceLab - Federal University of Santa Catarina

This work is licensed under the CERN-OHL-S Open Hardware License
version 2.

Project: On-board data handling 2.0

Github repository: https://github.com/spacelab-ufsc/obdh2

Title: Project info and board isometric views
Designed by: Andre M. P. Mattos

More info about SpaceLab: https://spacelab.ufsc.br/

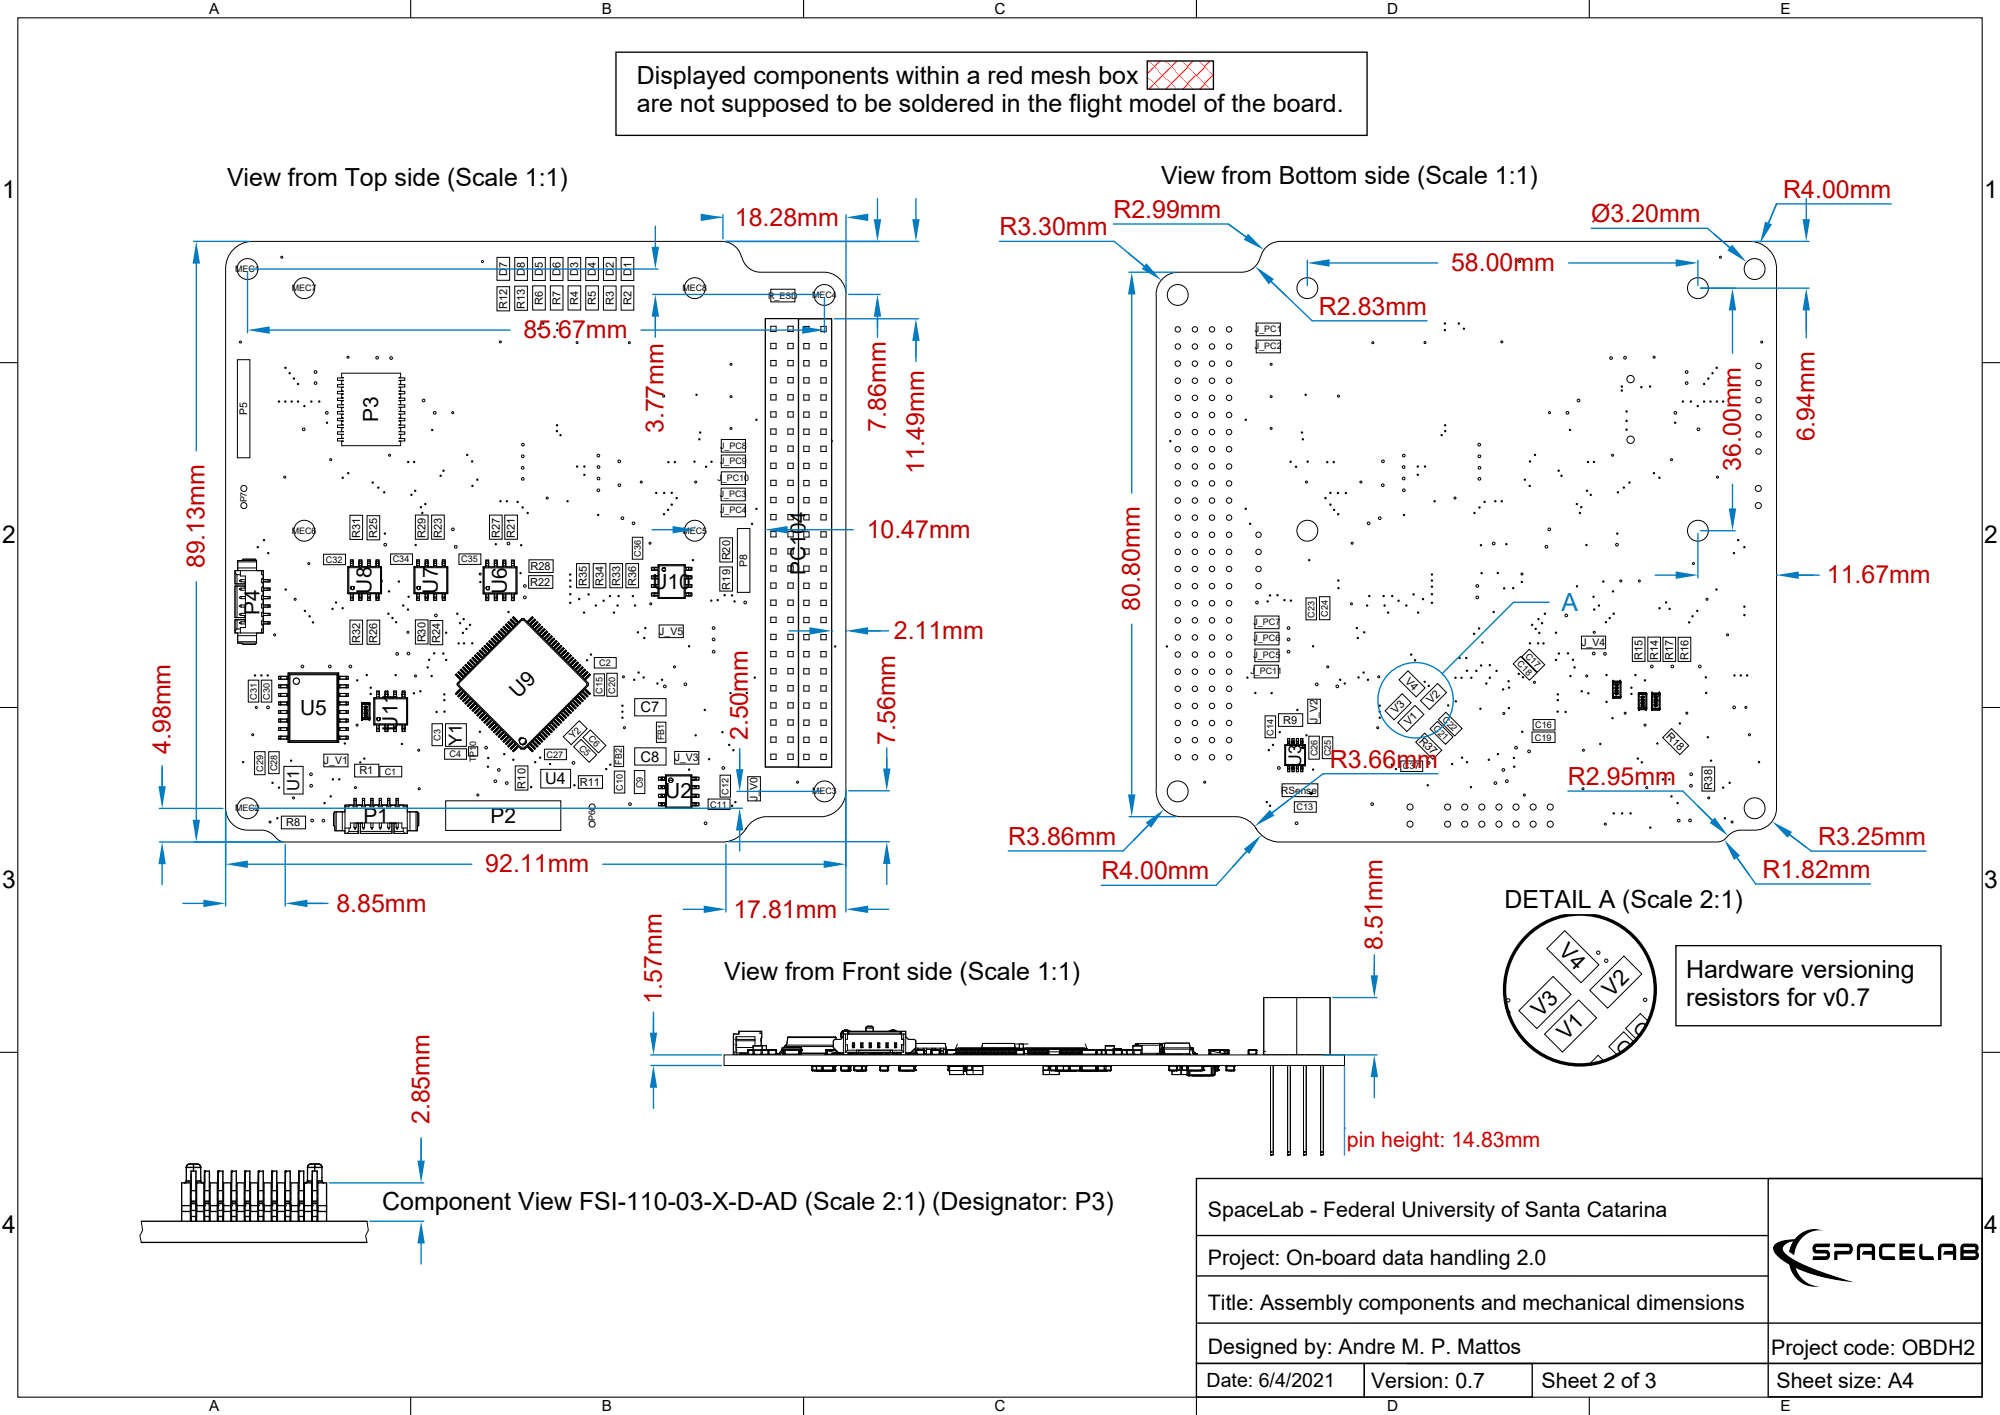
[picture p104: page 2]

Displayed components within a red mesh box
are not supposed to be soldered in the flight model of the board.

View from Bottom side (Scale 1:1)

View from Top side (Scale 1:1)

View from Front side (Scale 1:1)

Component View FSI-110-03-X-D-AD (Scale 2:1) (Designator: P3) 2.85mm

SpaceLab - Federal University of Santa Catarina

Project: On-board data handling 2.0

Title: Assembly components and mechanical dimensions

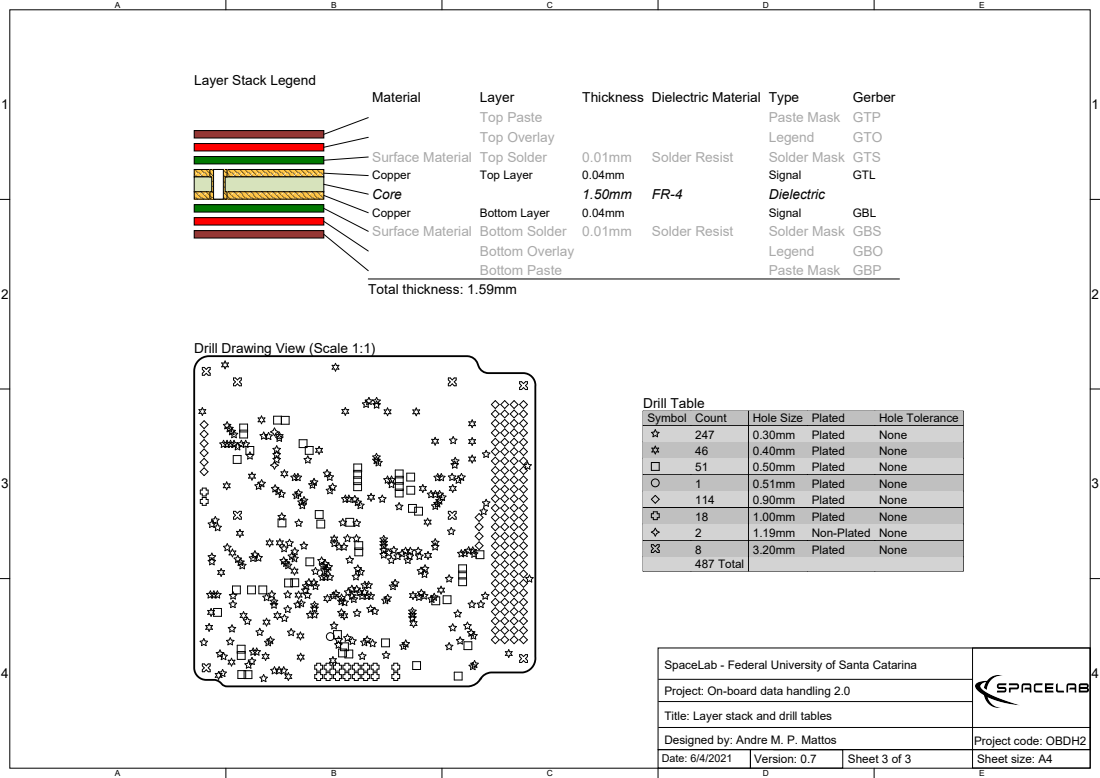
[picture p105: page 3]

Drill Drawing View (Scale 1:1)

Symbol | Count | Hole Size | Plated | Hole Tolerance

247 | 0.30mm | Plated | None
46 | 0.40mm | Plated | None
51 | 0.50mm | Plated | None
1 | 0.51mm | Plated | None
114 | 0.90mm | Plated | None
18 | 1.00mm | Plated | None
2 | 1.19mm | Non-Plated | None
8 | 3.20mm | Plated | None
487 Total

SpaceLab - Federal University of Santa Catarina

Project: On-board data handling 2.0

Title: Layer stack and drill tables
