spacelab-ufsc/obdh2/hardware/outputs/board_schematics/board_schematics.pdf

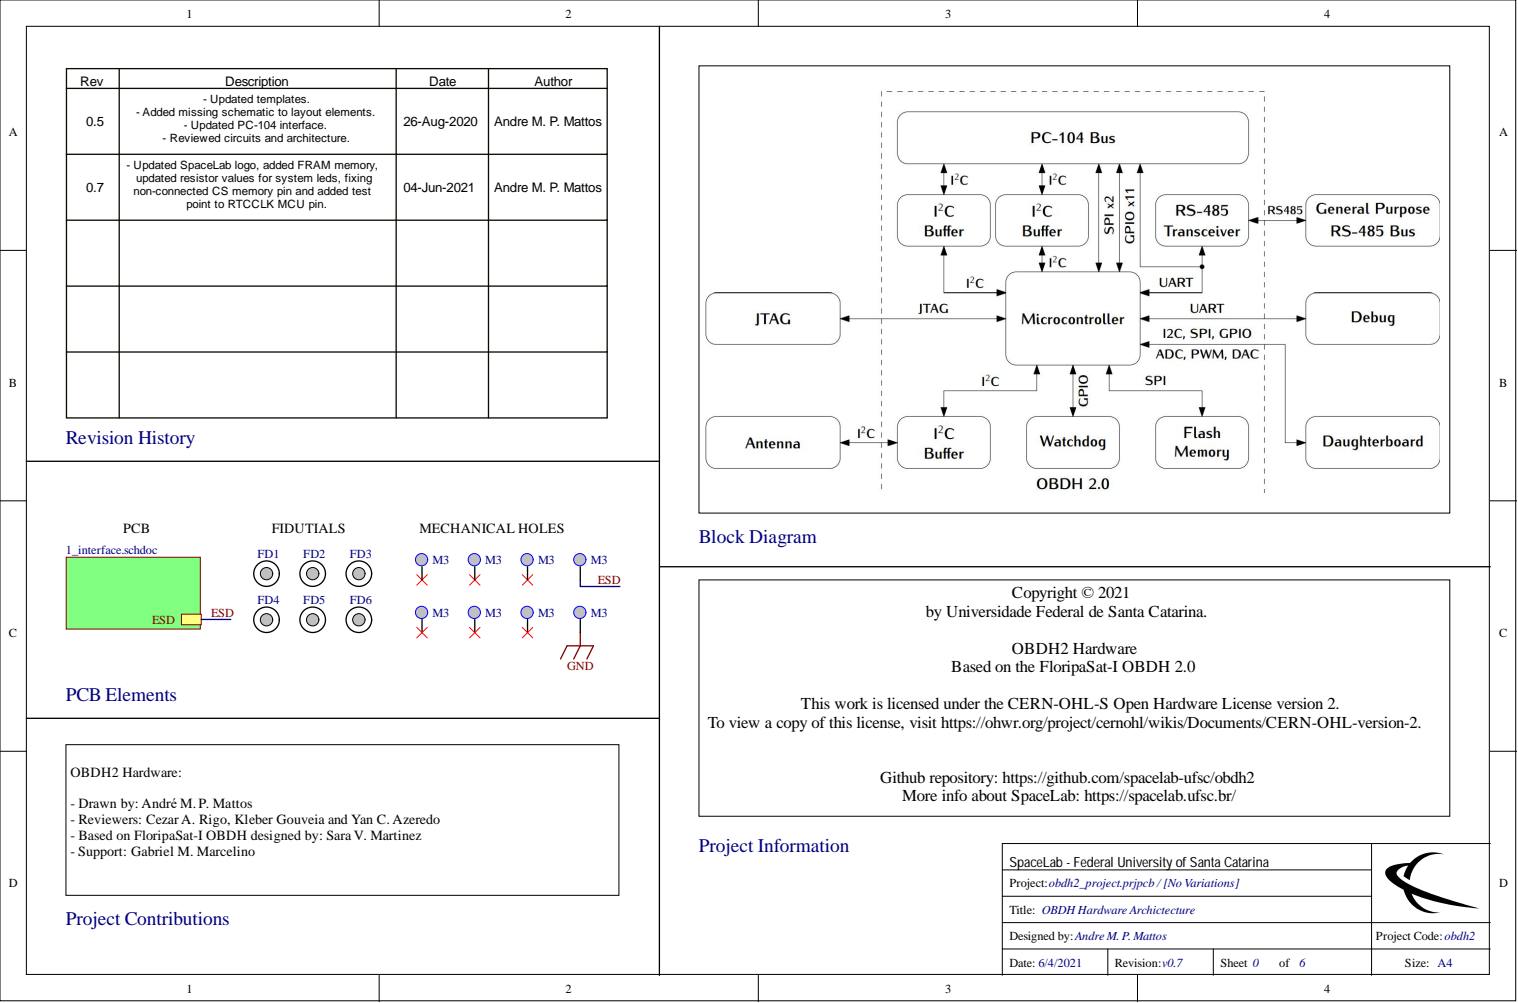
[picture p106: page 1]
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

igned by: Sara V. Mart

De signed by: Andre M. P. Mattos | P roje ct Code : obdh2

Date : | R evision: v0. | She e t of | Siz e : A4

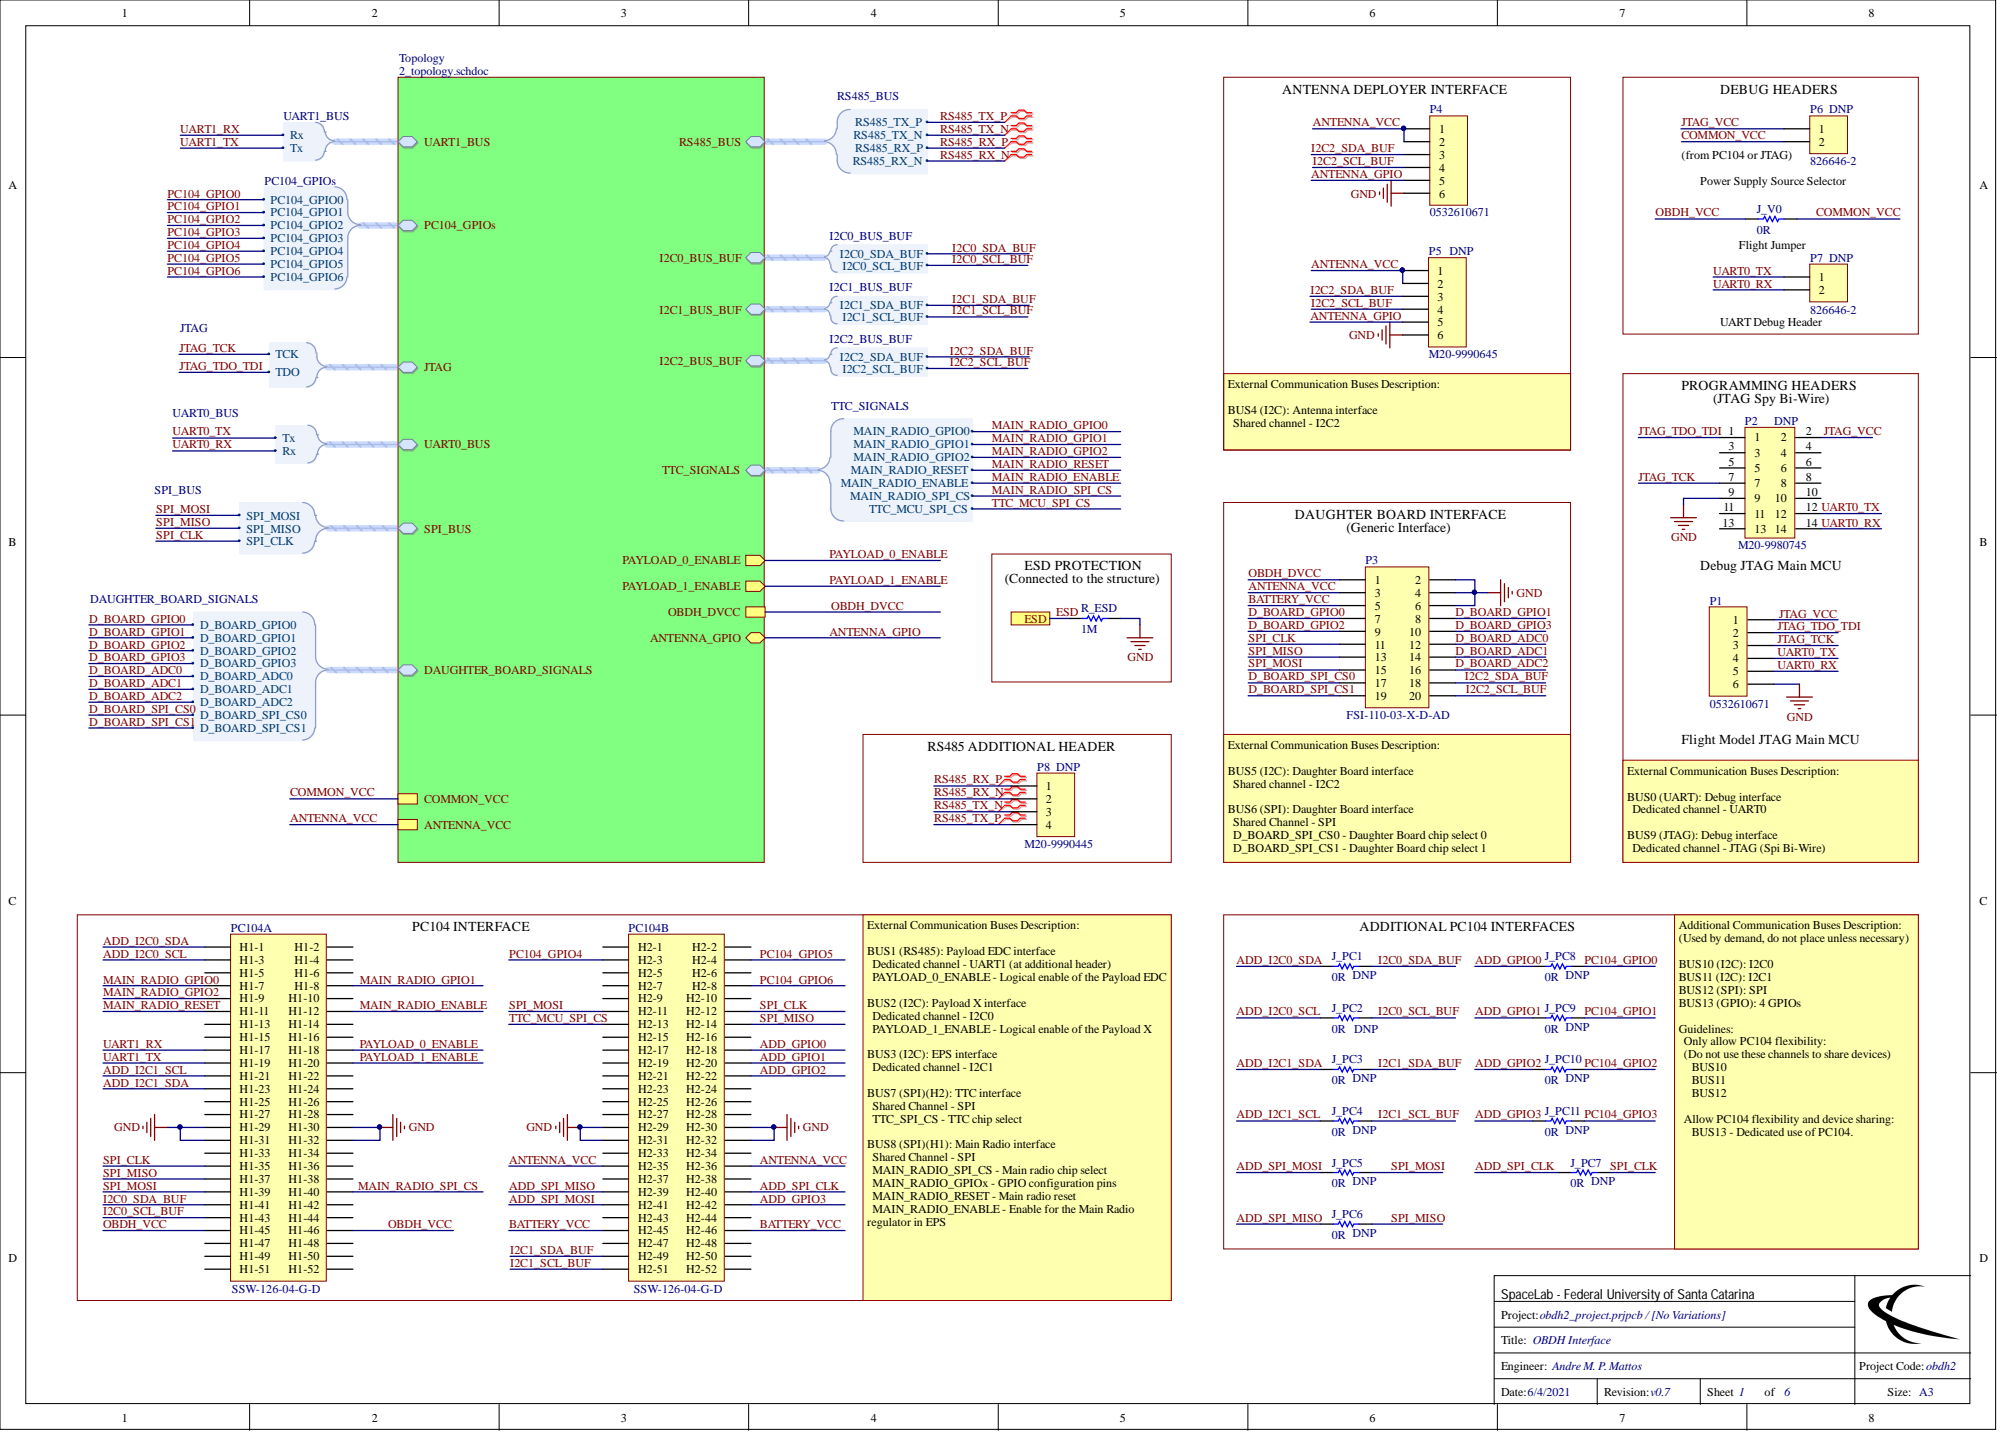
[picture p107: page 2]

Power Supply Source Selector

External Communication Buses Description:

PROGRAMMING HEADERS
(JTAG Spy Bi-Wire)

ESD PROTECTION
(Connected to the structure)

Debug JTAG Main MCU

Flight Model JTAG Main MCU

BUS6 (SPI): Daughter Board interface
Shared Channel - SPI
D_BOARD_SPI_CS0 - Daughter Board chip select 0
D_BOARD_SPI_CS1 - Daughter Board chip select 1

BUS9 (JTAG): Debug interface
Dedicated channel - JTAG (Spi Bi-Wire)

(Used by demand, do not place unless necessary)

BUS1 (RS485): Payload EDC interface
Dedicated channel - UART1 (at additional header)
PAYLOAD_0_ENABLE - Logical enable of the Payload EDC

BUS2 (I2C): Payload X interface
Dedicated channel - I2C0
PAYLOAD_1_ENABLE - Logical enable of the Payload X

Guidelines:
Only allow PC104 flexibility:
(Do not use these channels to share devices)
BUS10
BUS11
BUS12

Allow PC104 flexibility and device sharing:
BUS13 - Dedicated use of PC104.

BUS8 (SPI)(H1): Main Radio interface
MAIN_RADIO_SPI_CS - Main radio chip select
MAIN_RADIO_GPIOx - GPIO configuration pins
MAIN_RADIO_RESET - Main radio reset
MAIN_RADIO_ENABLE - Enable for the Main Radio
regulator in EPS

SpaceLab - Federal University of Santa Catarina

Engineer: Andre M. P. Mattos | Project Code: obdh2

Date: | Revision: v0.7 | Sheet of 6 | Size: A3

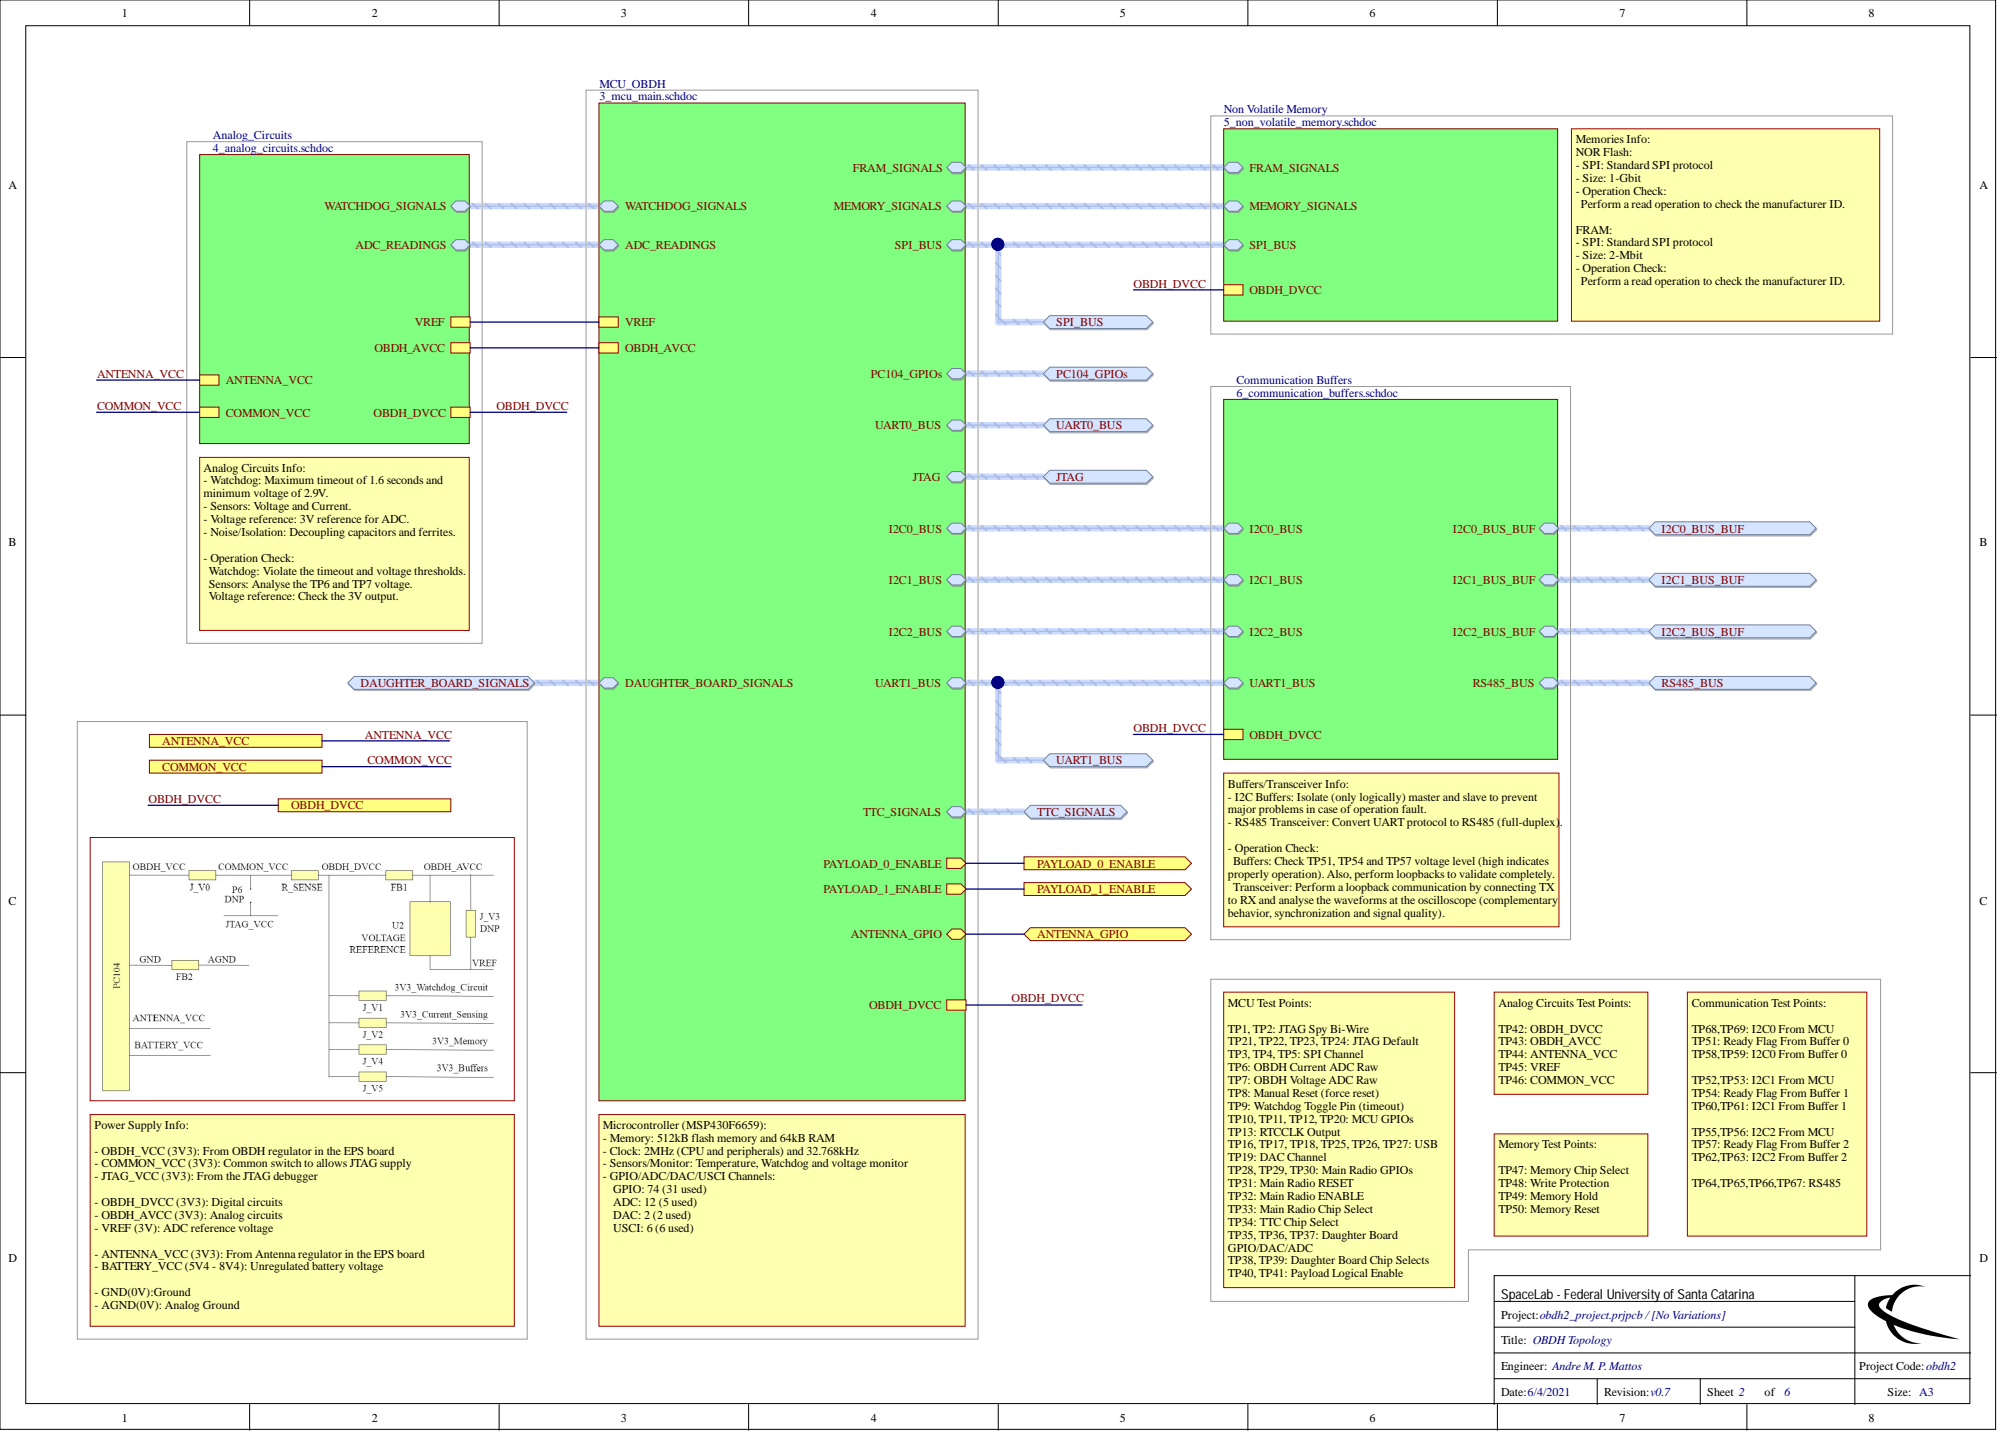
[picture p108: page 3]

MemoriesInfo:
NOR Flash:
- SPI: Standard SPI protocol
- Size: 1-Gbit
- Operation Check:
Perform a read operation to check the manufacturer ID.

FRAM:
- Size: 2-Mbit

Analog Circuits Info:
- Watchdog: Maximum timeout of 1.6 seconds and
minimum voltage of 2.9V.
- Sensors: Voltage and Current.
- Voltage reference: 3V reference for ADC.
- Noise/Isolation: Decoupling capacitors and ferrites.

Watchdog: Violate the timeout and voltage thresholds.
Sensors: Analyse the TP6 and TP7 voltage.
Voltage reference: Check the 3V output.

Buffers/Transceiver Info:
- I2C Buffers: Isolate (only logically) master and slave to prevent
major problems in case of operation fault.
- RS485 Transceiver: Convert UART protocol to RS485 (full-duplex).

Buffers: Check TP51, TP54 and TP57 voltage level (high indicates
properly operation). Also, perform loopbacks to validate completely.
Transceiver: Perform a loopback communication by connecting TX
to RX and analyse the waveforms at the oscilloscope (complementary
behavior,synchronization and signal quality).

Analog Circuits Test Points:

TP1, TP2: JTAG Spy Bi-Wire
TP21, TP22, TP23, TP24: JTAG Default
TP3, TP4, TP5: SPI Channel
TP6: OBDH Current ADC Raw
TP7: OBDH Voltage ADC Raw
TP8: Manual Reset (force reset)
TP9: Watchdog Toggle Pin (timeout)
TP10, TP11, TP12, TP20: MCU GPIOs
TP13: RTCCLK Output
TP16, TP17, TP18, TP25, TP26, TP27: USB
TP19: DAC Channel
TP28, TP29, TP30: Main Radio GPIOs
TP31: Main Radio RESET
TP32: Main Radio ENABLE
TP33: Main Radio Chip Select
TP34: TTC Chip Select
TP35, TP36, TP37: Daughter Board
GPIO/DAC/ADC
TP38, TP39: Daughter Board Chip Selects
TP40, TP41: Payload Logical Enable

TP68,TP69: I2C0 From MCU
TP51: Ready Flag From Buffer 0
TP58,TP59: I2C0 From Buffer 0

TP52,TP53: I2C1 From MCU
TP54: Ready Flag From Buffer 1
TP60,TP61: I2C1 From Buffer 1

Microcontroller (MSP430F6659):
- Memory: 512kB flash memory and 64kB RAM
- Clock: 2MHz (CPU and peripherals) and 32.768kHz
- Sensors/Monitor: Temperature, Watchdog and voltage monitor
- GPIO/ADC/DAC/USCI Channels:
GPIO: 74 (31 used)
ADC: 12 (5 used)
DAC: 2 (2 used)
USCI: 6 (6 used)

TP55,TP56: I2C2 From MCU
TP57: Ready Flag From Buffer 2
TP62,TP63: I2C2 From Buffer 2

- OBDH_VCC (3V3): From OBDH regulator in the EPS board
- COMMON_VCC (3V3): Common switch to allows JTAG supply
- JTAG_VCC (3V3): From the JTAG debugger

- OBDH_DVCC (3V3): Digital circuits
- OBDH_AVCC (3V3): Analog circuits
- VREF (3V): ADC reference voltage

- ANTENNA_VCC (3V3): From Antenna regulator in the EPS board
- BATTERY_VCC (5V4 - 8V4): Unregulated battery voltage

SpaceLab - Federal University of Santa Catarina

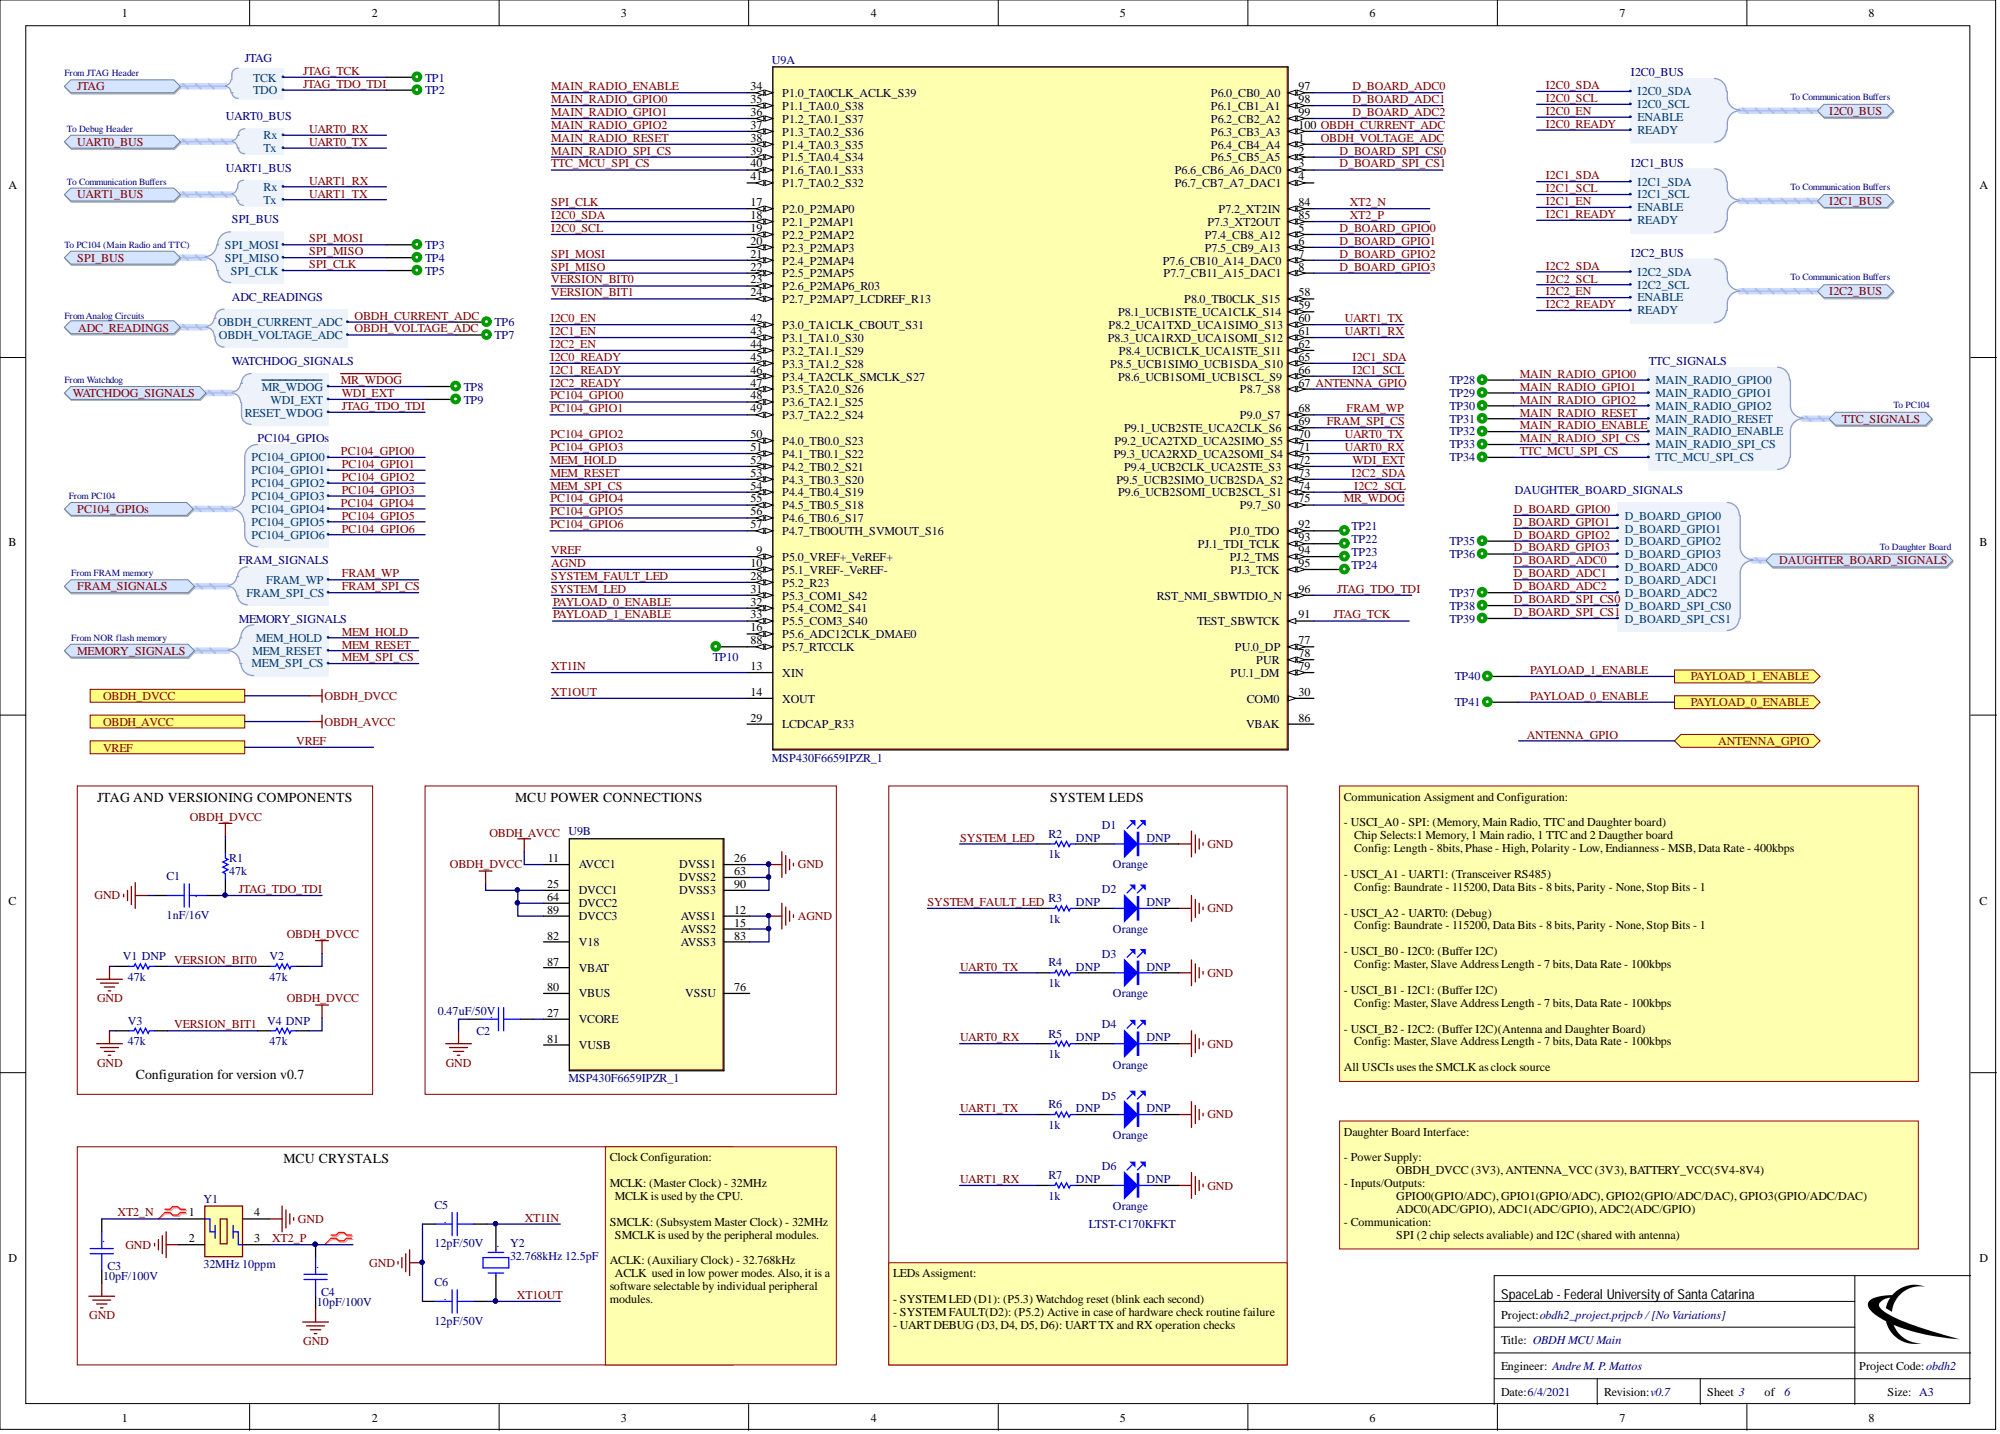
[picture p109: page 4]

To PC104 (Main Radio and TTC)
SPI_BUS

From NOR flash memory
MEMORY_SIGNALS

Communication Assigment and Configuration:

- USCI_A0 - SPI: (Memory, Main Radio, TTC and Daughter board)
Chip Selects:1 Memory, 1 Main radio, 1 TTC and 2 Daugther board
Config: Length - 8bits, Phase - High, Polarity - Low, Endianness- MSB, Data Rate - 400kbps

- USCI_A1 - UART1: (Transceiver RS485)
Config: Baundrate - 115200, Data Bits - 8 bits, Parity - None, Stop Bits - 1

- USCI_A2 - UART0: (Debug)

- USCI_B0 - I2C0: (Buffer I2C)
Config: Master, Slave Address Length - 7 bits, Data Rate - 100kbps

- USCI_B1 - I2C1: (Buffer I2C)

- USCI_B2 - I2C2: (Buffer I2C)(Antenna and Daughter Board)

All USCIs usesthe SMCLK as clock source

MCLK: (Master Clock) - 32MHz
MCLK is used by the CPU.

GPIO0(GPIO/ADC), GPIO1(GPIO/ADC), GPIO2(GPIO/ADC/DAC), GPIO3(GPIO/ADC/DAC)
ADC0(ADC/GPIO), ADC1(ADC/GPIO), ADC2(ADC/GPIO)

SMCLK: (Subsystem Master Clock) - 32MHz
SMCLK is used by the peripheral modules.

SPI (2 chip selects avaliable) and I2C (shared with antenna)

ACLK: (Auxiliary Clock) - 32.768kHz
ACLK used in low power modes. Also, it is a
software selectable by individual peripheral
modules.

- SYSTEM LED (D1): (P5.3) Watchdog reset (blink each second)
- SYSTEM FAULT(D2): (P5.2) Active in case of hardware check routine failure
- UART DEBUG (D3, D4, D5, D6): UART TX and RX operation checks

SpaceLab - Federal University of Santa Catarina

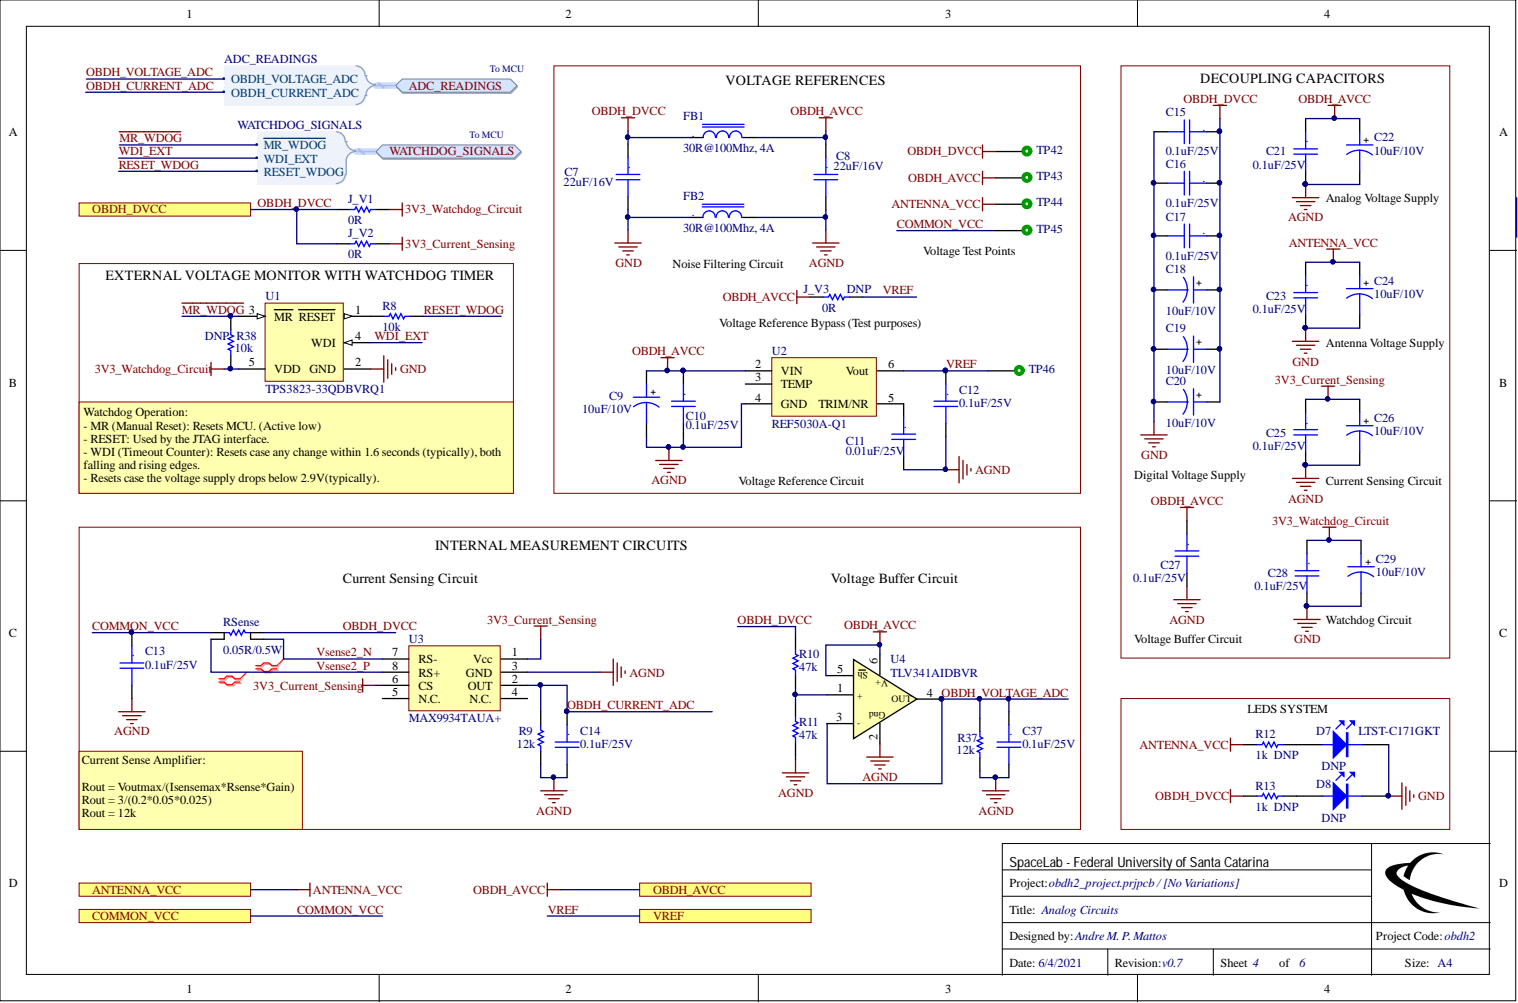
[picture p110: page 5]

EXTERNAL VOLTAGE MONITOR WITH WATCHDOG TIMER

Voltage Reference Bypass(Test purposes)

Watchdog Operation:
- MR (Manual Reset): Resets MCU. (Active low)
- RESET: Used by the JTAG interface.
- WDI (Timeout Counter): Resets case any change within 1.6 seconds (typically), both
falling and rising edges.
- Resets case the voltage supply drops below 2.9V(typically).

Rout = Voutmax/(Isensemax*Rsense*Gain)
Rout = 3/(0.2*0.05*0.025)
Rout = 12k

SpaceLab - Federal University of Santa Catarina

Designed by:

Date: | Revision: | Sheet of | Size: A4

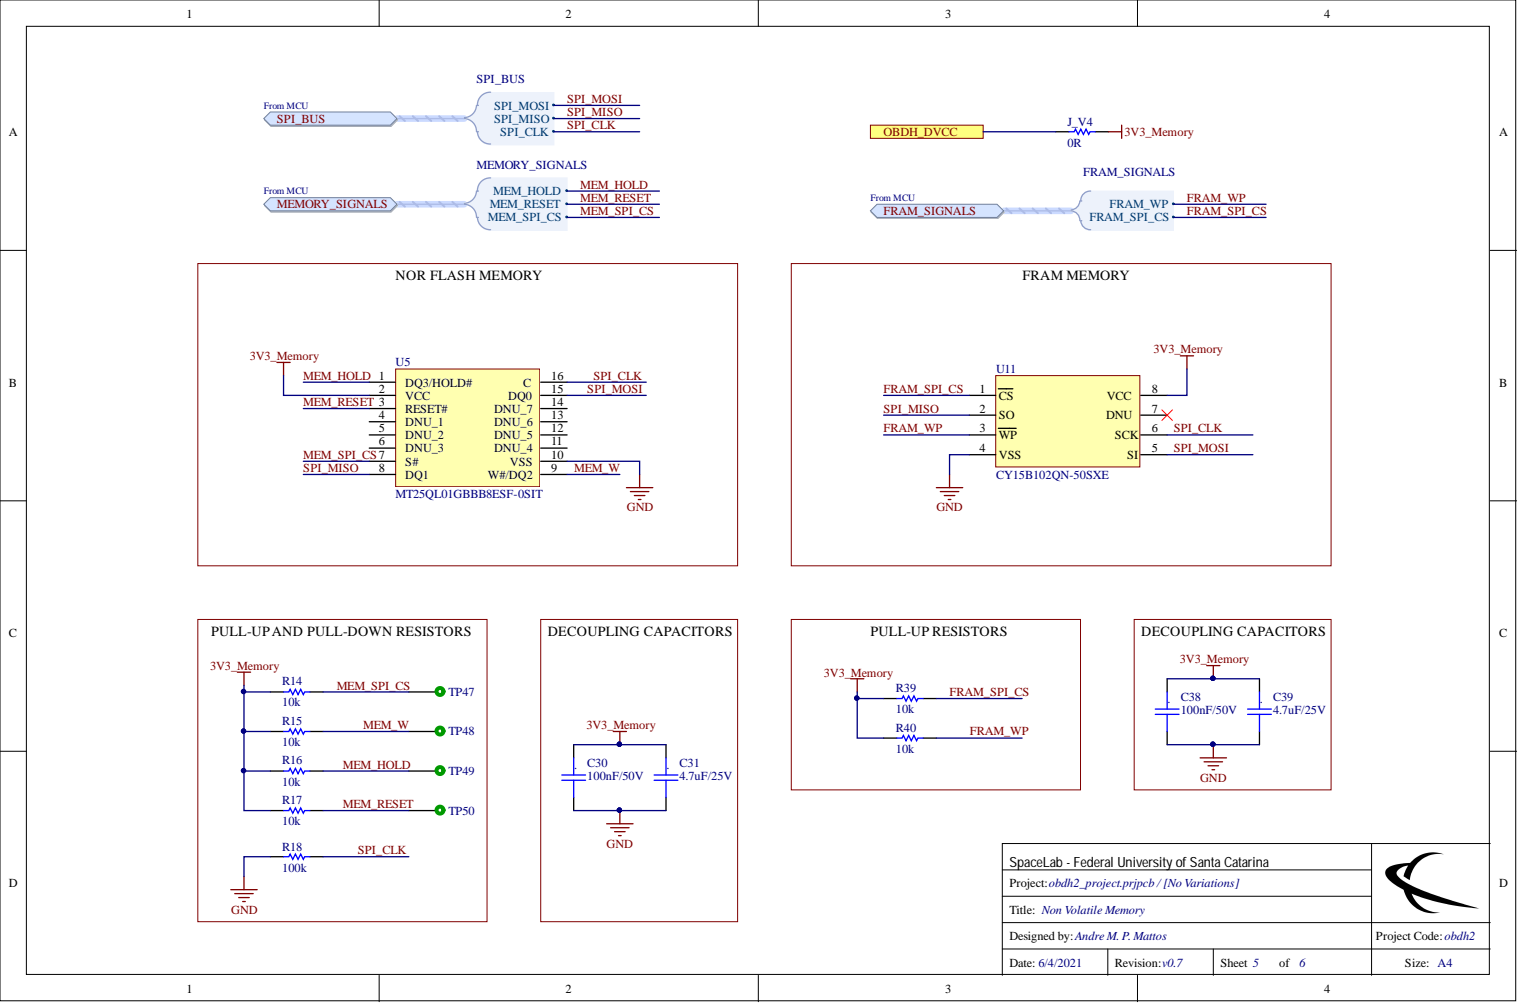
[picture p111: page 6]

PULL-UPAND PULL-DOWN RESISTORS

SpaceLab - Federal University of Santa Catarina

Designed by:

Date: | Revision: | Sheet of | Size: A4

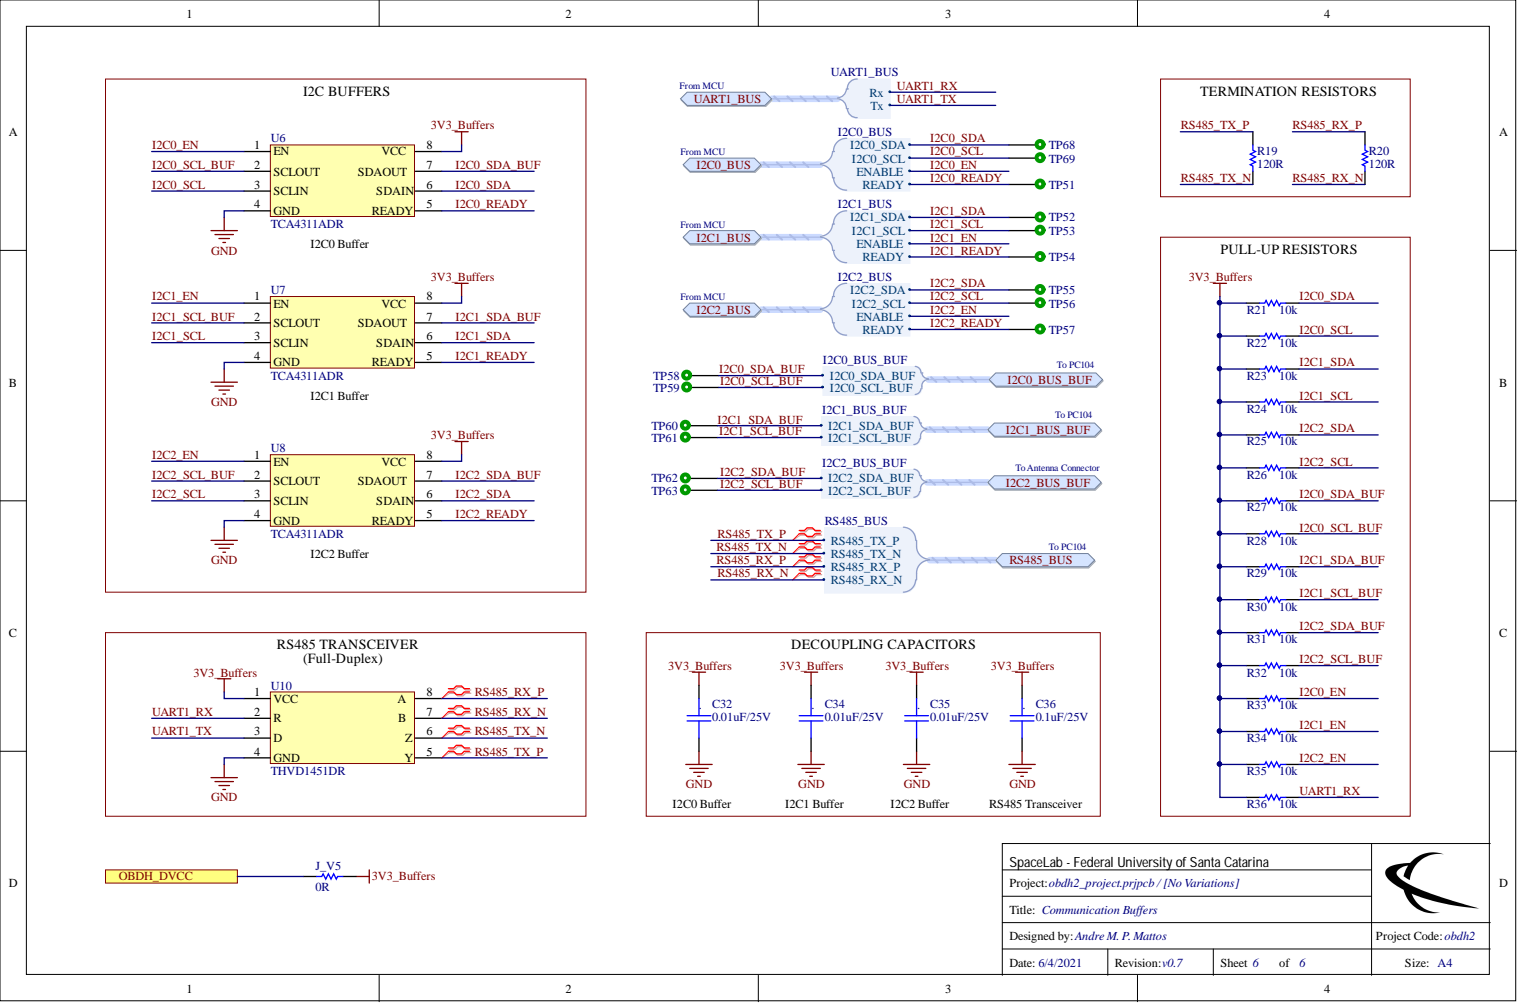
[picture p112: page 7]

De signed by: Andre M. P. Mattos | P roje ct Code : obdh2

Date : | R evision: v0. | She e t of | Siz e : A4
