spacelab-ufsc/obdh2/doc/presentation/figures/obdh2-layers.pdf

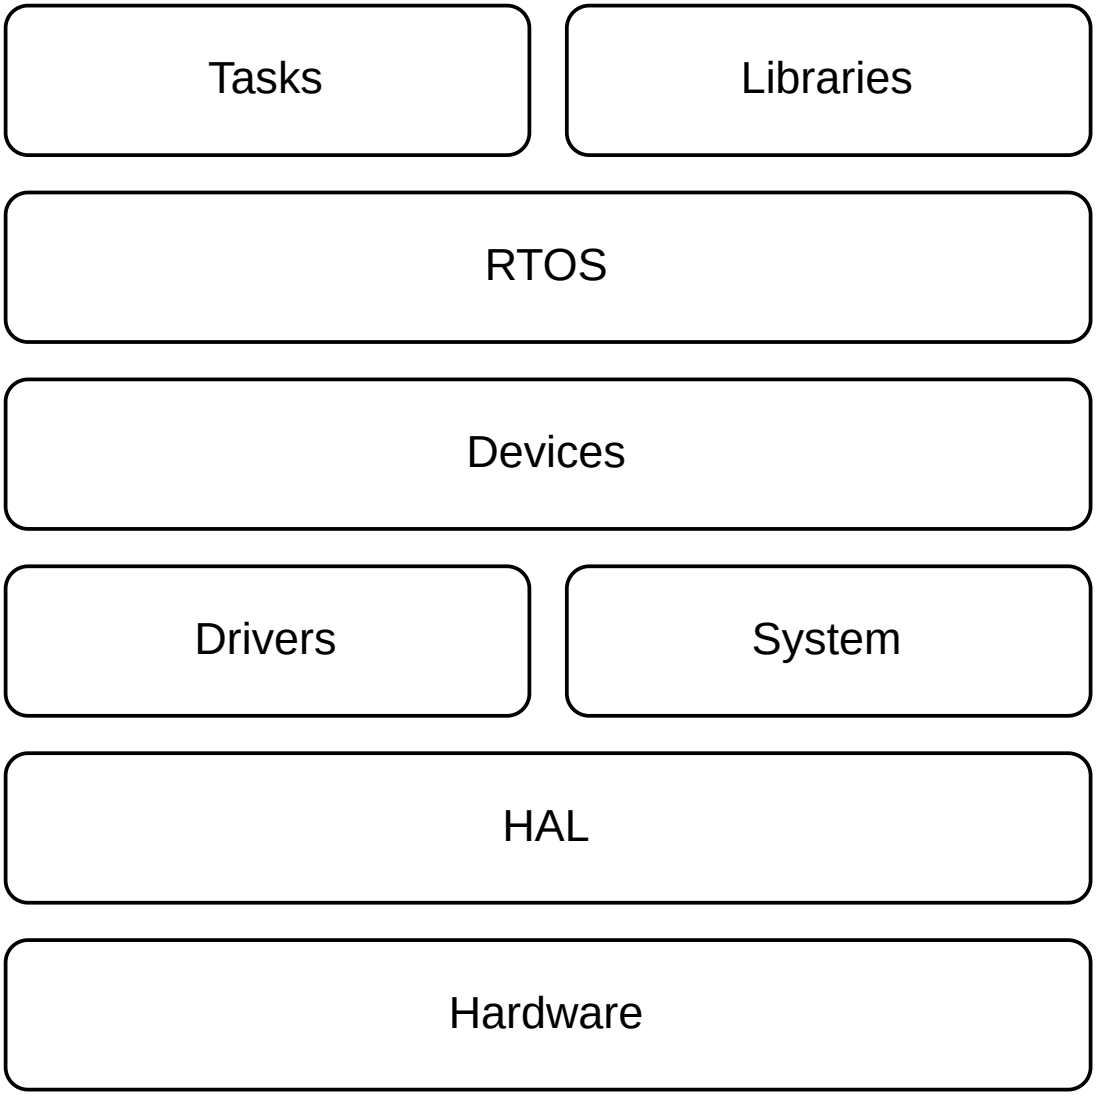
[picture p113: page 1]
Hardware; HAL; Drivers; Devices; RTOS; System; Tasks; Libraries
