spacelab-ufsc/obdh2/doc/presentation/figures/product-tree.pdf

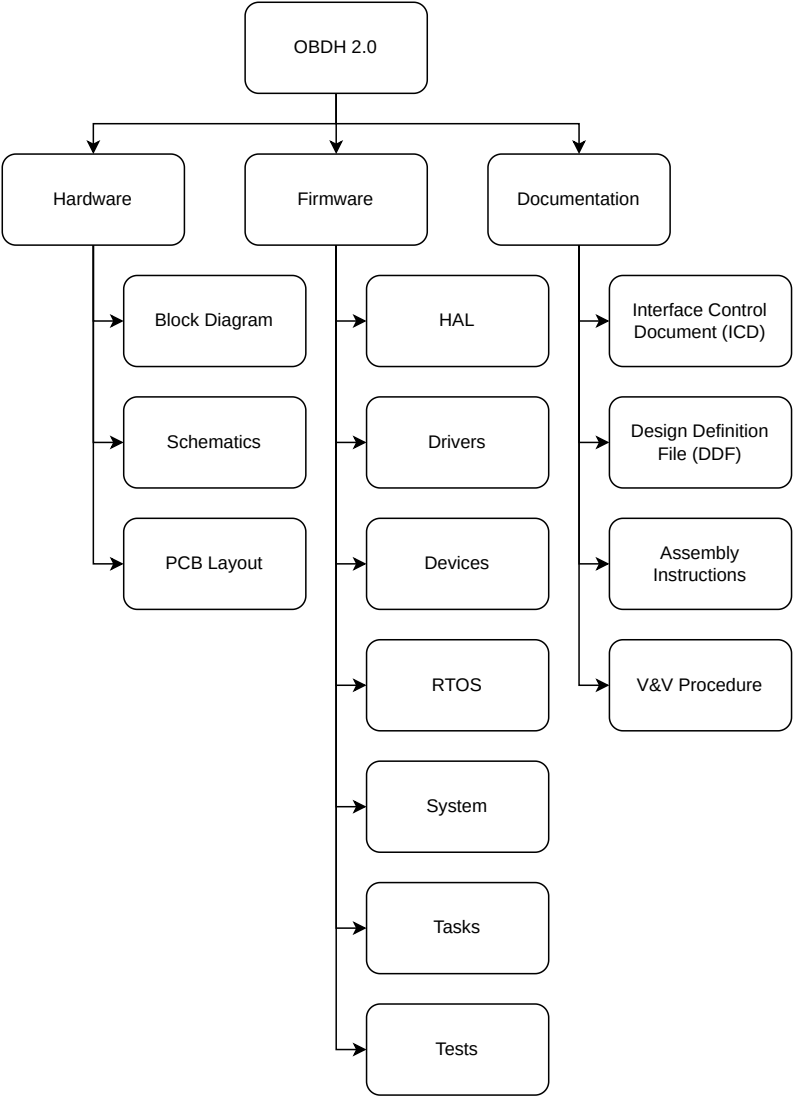
[picture p114: page 1]
OBDH 2.0; Hardware; Firmware; Documentation; Interface Control Document (ICD); Design Definition File (DDF); Block Diagram; Schematics; PCB Layout; HAL; Drivers; Devices; RTOS; System; Tasks; Tests; Assembly Instructions; V&V Procedure
