spacelab-ufsc/obdh2/doc/user_manual/img/edc_reading_flowchart.pdf

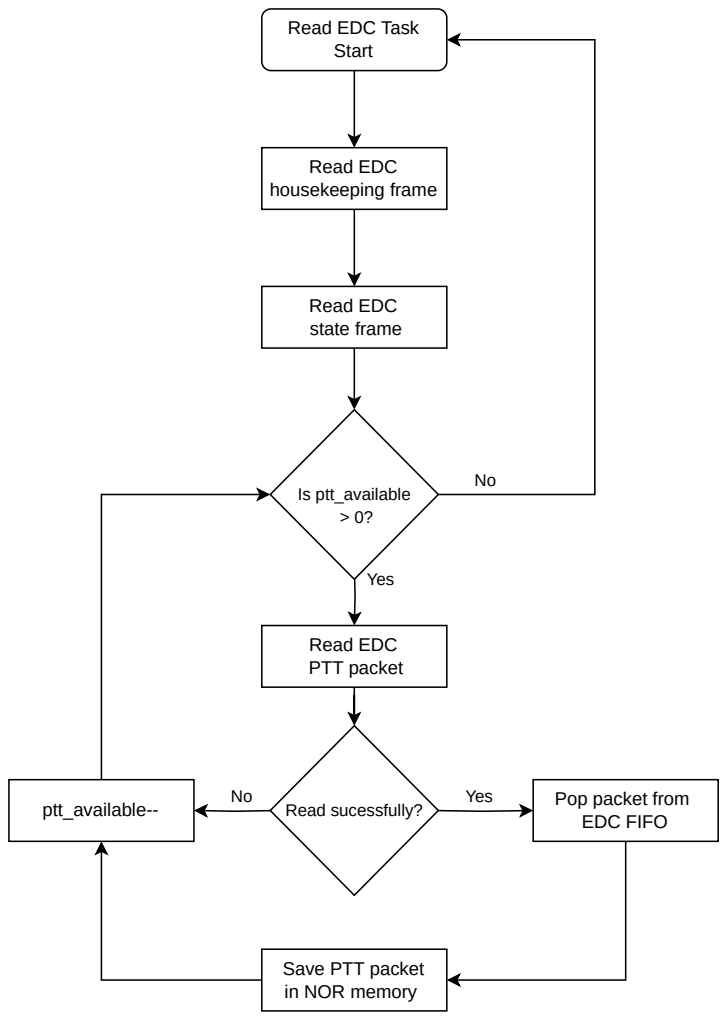
[picture p115: page 1]
Read EDC housekeeping frame; Read EDC state frame; Yes; Read EDC PTT packet; ptt_available--; Pop packet from; EDC FIFO; Read sucessfully?; Is ptt_available > 0?

Read EDC Task
Start

Save PTT packet
in NOR memory
