spacelab-ufsc/obdh2/doc/user_manual/img/flowchart_antenna_deploy_routine.pdf

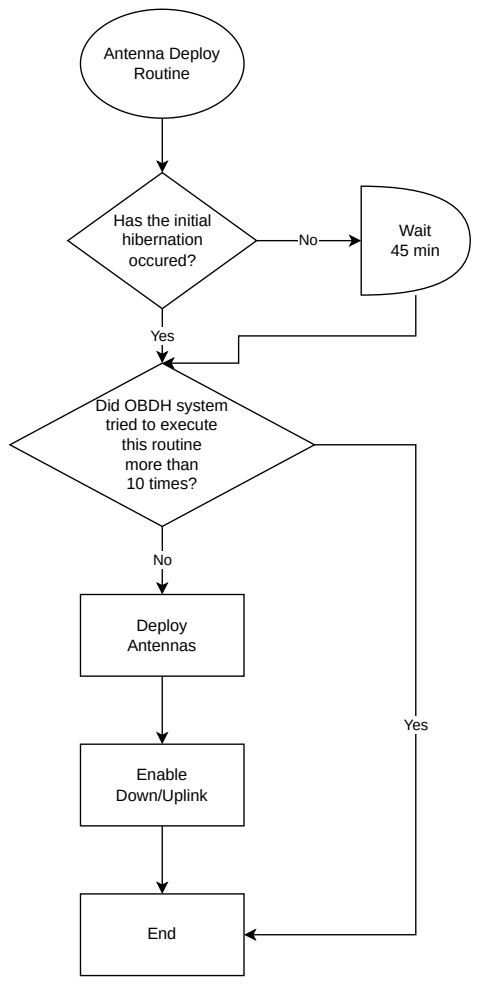
[picture p116: page 1]
Antenna Deploy Routine; Yes; Wait 45 min; Deploy Antennas; Enable Down/Uplink; End

Has the initial
hibernation
occured?

Did OBDH system
tried to execute
this routine
more than
10 times?
