spacelab-ufsc/obdh2/doc/user_manual/img/flowchart_OBDH.pdf

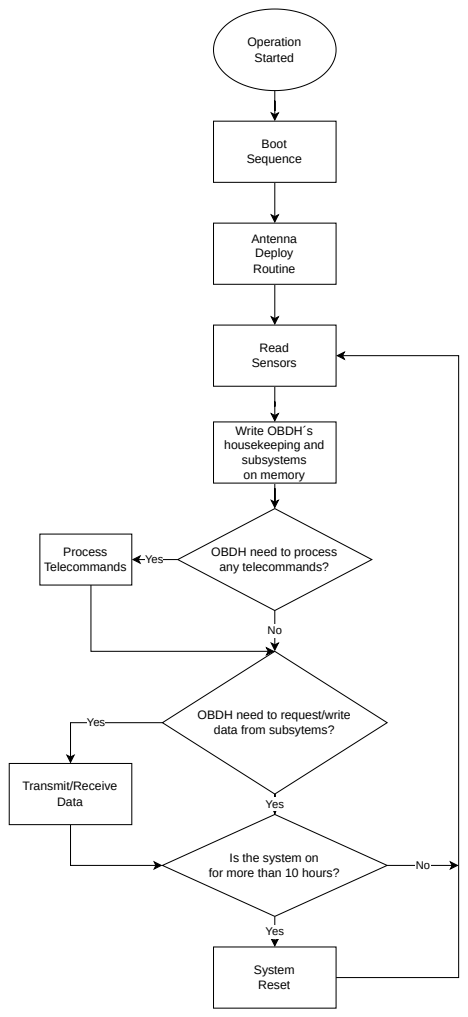
[picture p117: page 1]
Operation Started; Boot Sequence; Antenna Deploy Routine; Read Sensors; Write OBDH´s housekeeping and subsystems on memory; Yes; System Reset; Transmit/Receive Data; OBDH need to process; any telecommands?; Process Telecommands

OBDH need to request/write
data from subsytems?

No Is the system on
for more than 10 hours?
