spacelab-ufsc/obdh2/doc/user_manual/img/product-tree-fw.pdf

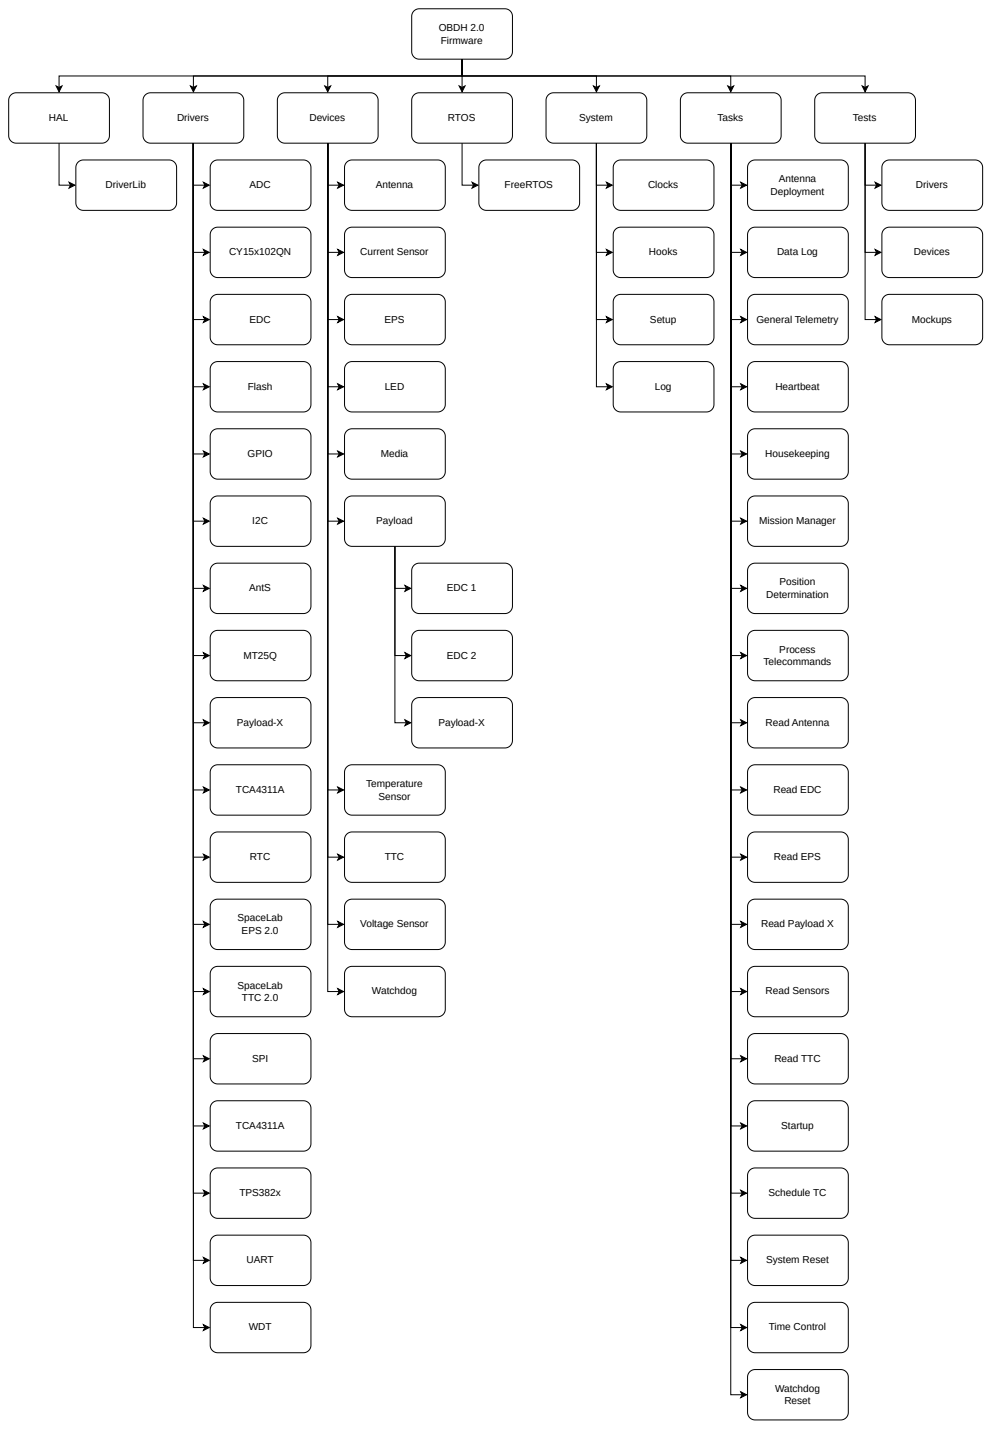
[picture p118: page 1]
Drivers; Devices; Tasks; ADC; EDC; Flash; GPIO; AntS; Payload-X; TCA4311A; SpaceLab TTC 2.0; SPI; RTC; SpaceLab EPS 2.0; Antenna; EPS; LED; Media; Payload; Temperature Sensor; TTC; Voltage Sensor; Watchdog; Current Sensor; Antenna Deployment; Data Log; General Telemetry; Heartbeat; Housekeeping; Mission Manager; Position Determination; Process Telecommands; Read Antenna; OBDH 2.0 Firmware; RTOS; Tests; FreeRTOS; HAL; DriverLib; System; Clocks; Hooks; Setup; Log; Mockups; TPS382x; UART; WDT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
