spacelab-ufsc/obdh2/doc/user_manual/img/data_path_diagram.pdf

### External

EDC 1 | EDC 2

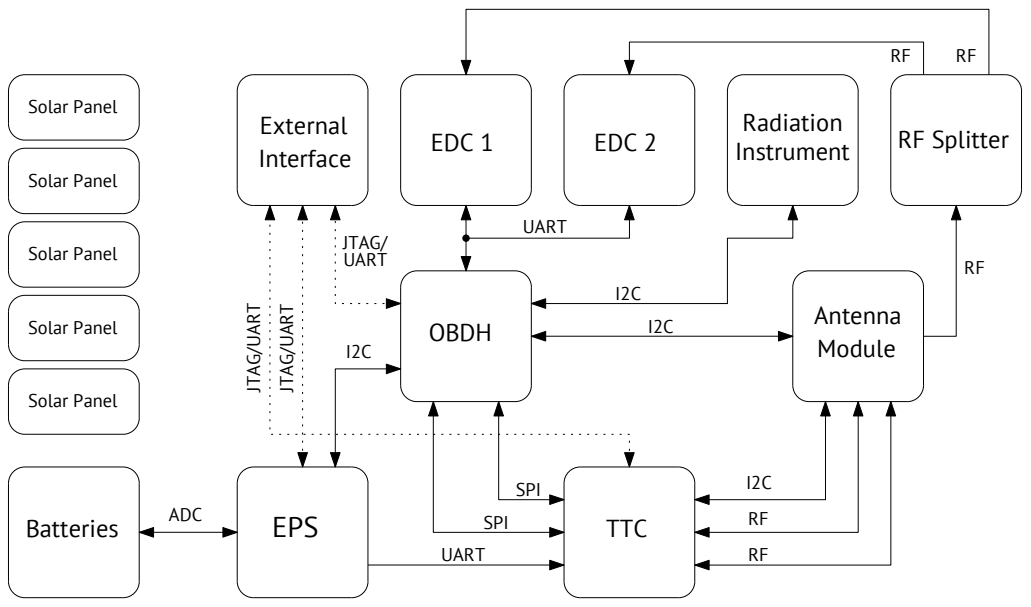
[picture p119: page 1]
Interface; EPS; TTC; Module; Antenna OBDH; UART; SPI; Batteries; Solar Panel; JTAG/; Radiation Instrument; ADC; G/UART; RF Splitter
