spacelab-ufsc/obdh2/doc/user_manual/img/block_diagram.pdf

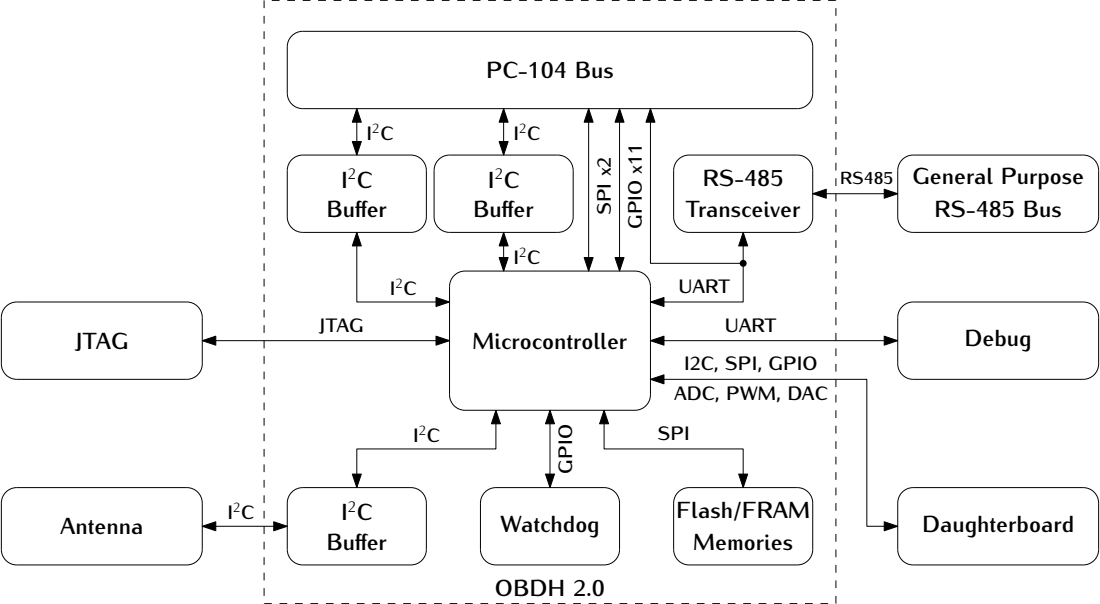
[picture p120: page 1]
Microcontroller Antenna; SPI JTAG; Debug PC-104 BusSPI x2; GPIO x11 JTAG; OBDH 2.0; Flash/FRAM Memories I; Buffer; Watchdog I; RS-485 Transceiver UART GPIOI; Buffer I; RS485 UART I; Daughterboard I2C, SPI, GPIO ADC, PWM, DAC; General Purpose RS-485 Bus
