spacelab-ufsc/obdh2/doc/presentation/figures/dev-flow.pdf

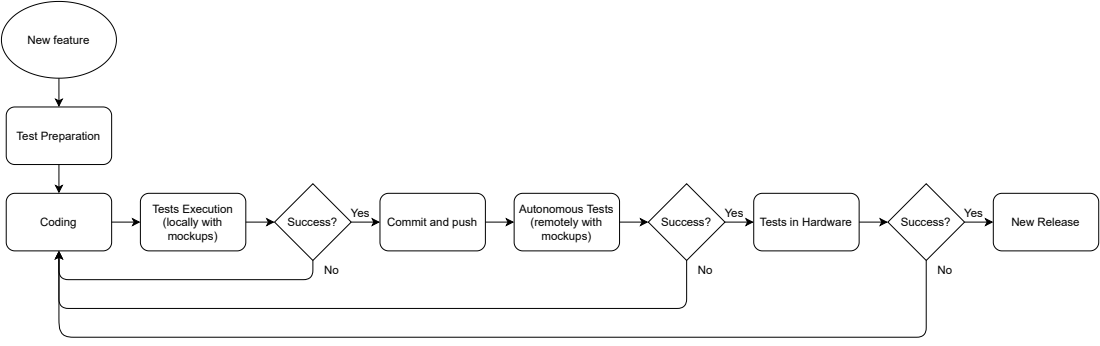
[picture p121: page 1]
Coding; New feature; Tests Execution (locally with mockups); Success?; Commit and push; Yes; Autonomous Tests (remotely with mockups); Tests in Hardware; New Release; Test Preparation
