spacelab-ufsc/obdh2/doc/presentation/figures/git-flow.pdf

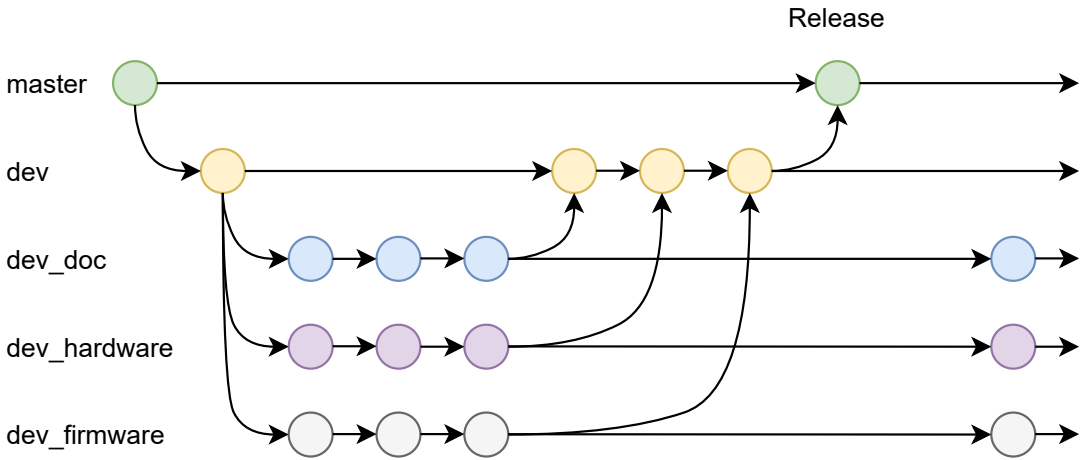
[picture p122: page 1]
master; dev; dev_doc; dev_hardware; dev_firmware; Release
