spacelab-ufsc/obdh2/doc/presentation/figures/tdd-flow.pdf

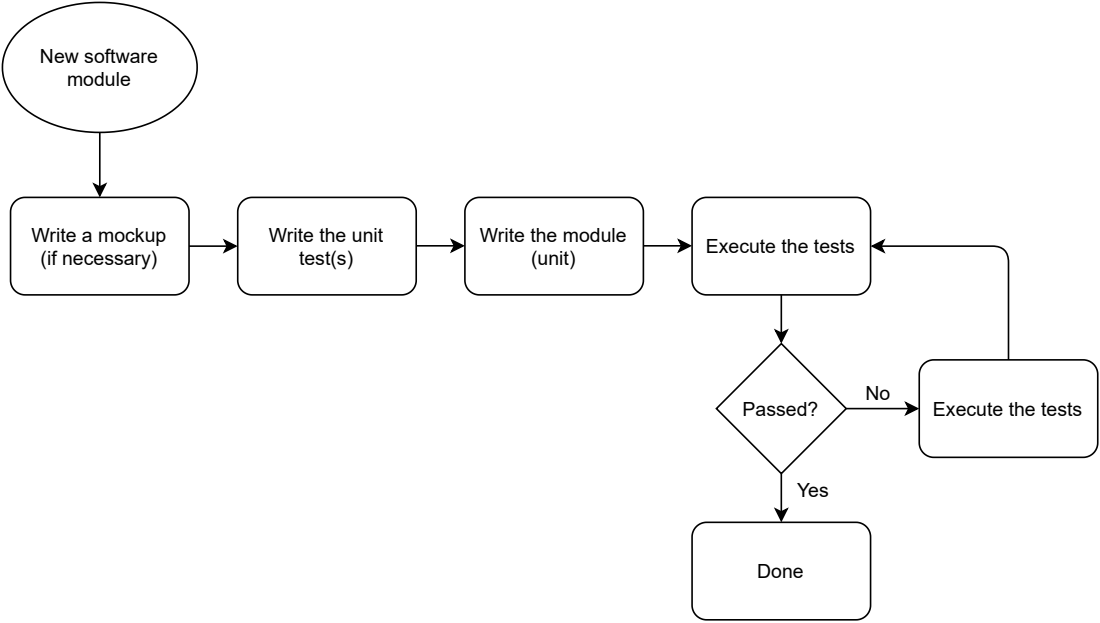
[picture p123: page 1]
Write a mockup (if necessary); (unit); Execute the tests; Passed?; New software module; Done; Yes

Write the unit
test(s)

Write the module

Execute the tests
