spacelab-ufsc/obdh2/doc/user_manual/img/by-sa-eps-converted-to.pdf

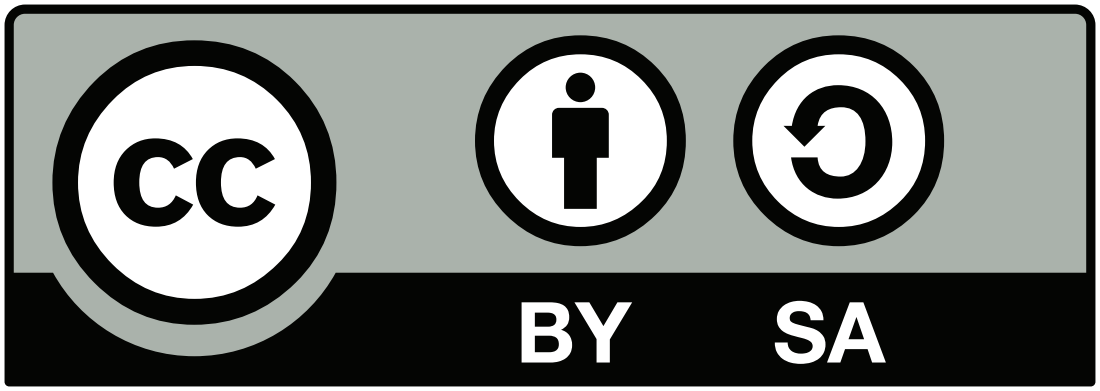
[picture p124: page 1]
