spacelab-ufsc/obdh2/doc/user_manual/img/hmac-diagram.pdf

Transmitter | Receiver

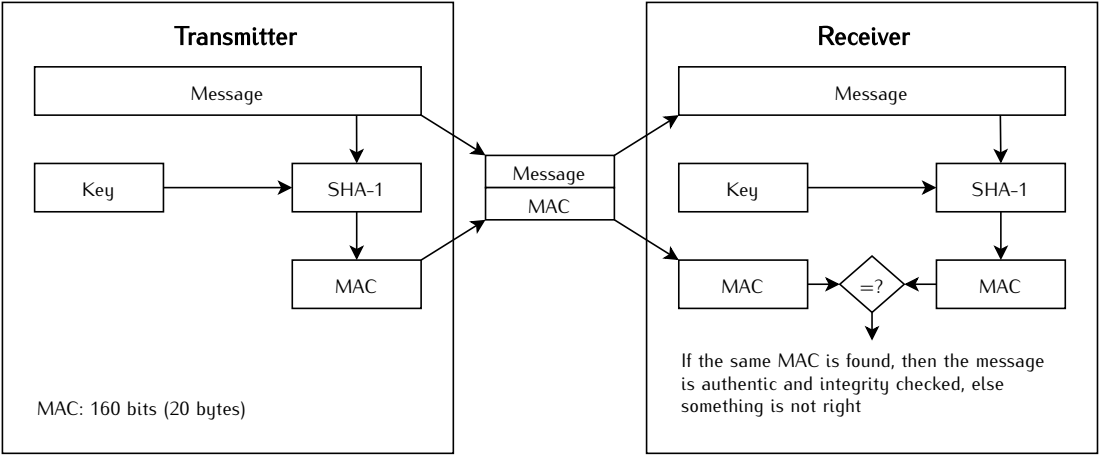
[picture p125: page 1]
Message; SHA-1; MAC; Message MAC; Key

If the same MAC is found, then the message
is authentic and integrity checked, else
something is not right

MAC: 160 bits (20 bytes)
