spacelab-ufsc/obdh2/doc/user_manual/img/tc_processing_flow.pdf

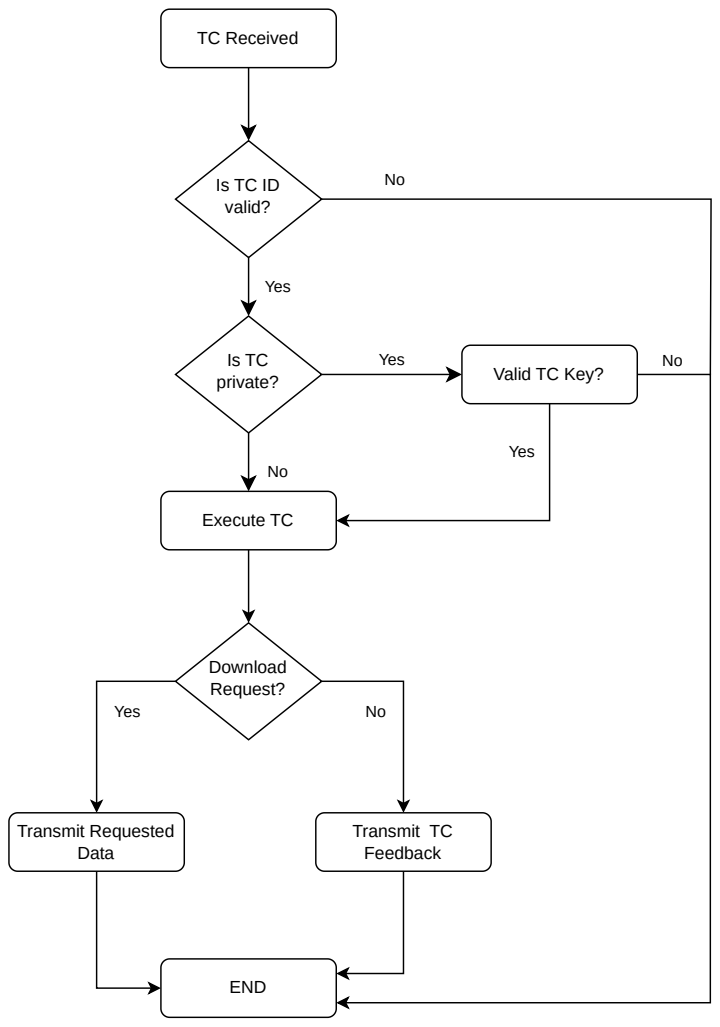
[picture p126: page 1]
TC Received; Yes; private?; Execute TC; Download Request?; Transmit Requested Data; Transmit TC Feedback; END

valid?

Valid TC Key?
