spacelab-ufsc/obdh2/(list of files, drawings)

Other design files:
hardware/obdh2_project.prjpcb
hardware/OBDH_Eng_Model_2_ALT/Sources/PCB_OBDH_ALT.PcbDoc
hardware/sources/0_architecture.schdoc
hardware/sources/1_interface.schdoc
hardware/sources/2_topology.schdoc
hardware/sources/3_mcu_main.schdoc
hardware/sources/4_analog_circuits.schdoc
hardware/sources/5_non_volatile_memory.schdoc
hardware/sources/6_communication_buffers.schdoc
