spacelab-ufsc/obdh2/firmware/main.c

/*
 * main.c
 * 
 * Copyright (C) 2021, SpaceLab.
 * 
 * This file is part of OBDH 2.0.
 * 
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
 */

/**
 * \brief Main file.
 * 
 * \author Gabriel Mariano Marcelino <gabriel.mm8@gmail.com>
 * 
 * \version 0.7.24
 * 
 * \date 2019/10/25
 * 
 * \defgroup main Main file
 * \{
 */

#include <FreeRTOS.h>
#include <task.h>

#include "devices/watchdog/watchdog.h"
#include "system/clocks.h"
#include "app/tasks/tasks.h"

void main(void)
{
    /* Watchdog device initialization */
    int err = watchdog_init();

    /* System clocks configuration */
    clocks_config_t clk_conf = {0};

    clk_conf.mclk_hz    = 32000000UL;
    clk_conf.smclk_hz   = 32000000UL;
    clk_conf.aclk_hz    = 32768;

    err = clocks_setup(clk_conf);

    /* Create all the tasks */
    create_tasks();

    /* Start the scheduler */
    vTaskStartScheduler();

    /* Will only get here if there was insufficient memory to create the idle and/or timer task */
    while(1)
    {
    }
}

/** \} End of main group */
