spacelab-ufsc/obdh2/firmware/config/config.h

/*
 * config.h
 * 
 * Copyright The OBDH 2.0 Contributors.
 * 
 * This file is part of OBDH 2.0.
 * 
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
 */

/**
 * \brief Configuration parameters definition.
 * 
 * \author Gabriel Mariano Marcelino <gabriel.mm8@gmail.com>
 * \author Carlos Augusto Porto Freitas <carlos.portof@hotmail.com>
 * 
 * \version 1.0.0
 * 
 * \date 2019/10/26
 * 
 * \defgroup config Configuration
 * \{
 */

#ifndef CONFIG_H_
#define CONFIG_H_

/* Mission Defines */
#define CONFIG_MISSION_GOLDS_UFSC                       1

/* Tasks */
#define CONFIG_TASK_STARTUP_ENABLED                     1
#define CONFIG_TASK_WATCHDOG_RESET_ENABLED              1
#define CONFIG_TASK_HEARTBEAT_ENABLED                   1
#define CONFIG_TASK_SYSTEM_RESET_ENABLED                1
#define CONFIG_TASK_READ_SENSORS_ENABLED                1
#define CONFIG_TASK_GENERAL_TELEMETRY_ENABLED           1
#define CONFIG_TASK_TIME_CONTROL_ENABLED                1
#define CONFIG_TASK_READ_EDC_ENABLED                    1
#define CONFIG_TASK_READ_EPS_ENABLED                    1
#define CONFIG_TASK_READ_TTC_ENABLED                    1
#define CONFIG_TASK_READ_ANTENNA_ENABLED                1
#define CONFIG_TASK_DATA_LOG_ENABLED                    1
#define CONFIG_TASK_PROCESS_TC_ENABLED                  1
#define CONFIG_TASK_ANTENNA_DEPLOYMENT_ENABLED          0
#define CONFIG_TASK_POSITION_DETERMINATION_ENABLED      0
#define CONFIG_TASK_PAYLOAD_X_ENABLED                   1
#define CONFIG_TASK_HOUSEKEEPING_ENABLED                1
#define CONFIG_TASK_MISSION_MANAGER_ENABLED             1
#define CONFIG_TASK_SCHED_TC_ENABLED                    1
#define CONFIG_TASK_HEALTH_CHECK_MEM_ENABLED            0
#define CONFIG_TASK_HEALTH_CHECK_MODE_ENABLED           0

/* Devices */
#define CONFIG_DEV_MEDIA_INT_ENABLED                    1
#define CONFIG_DEV_MEDIA_FRAM_ENABLED                   1
#define CONFIG_DEV_MEDIA_NOR_ENABLED                    1
#define CONFIG_DEV_LEDS_ENABLED                         1
#define CONFIG_DEV_CURRENT_SENSOR_ENABLED               1
#define CONFIG_DEV_VOLTAGE_SENSOR_ENABLED               1
#define CONFIG_DEV_TEMP_SENSOR_ENABLED                  1
#define CONFIG_DEV_EPS_ENABLED                          1
#define CONFIG_DEV_PAYLOAD_EDC_ENABLED                  1
#define CONFIG_DEV_ANTENNA_ENABLED                      1
#define CONFIG_DEV_PAYLOAD_X_ENABLED                    1

/* Drivers */
#define CONFIG_DRV_ISIS_ANTENNA_ENABLED                 1
#define CONFIG_DRV_SL_ANTENNA_ENABLED                   0

/* Health Check */
#define CONFIG_HEALTH_CHECK_ENABLED                     0
#define CONFIG_HEALTH_CHECK_PAGES_TO_VALIDATE           10

/* Debug and log messages */
#define CONFIG_DRIVERS_DEBUG_ENABLED                    0
#define CONFIG_PRINT_OBDH_PARAMS                        1

#define CONFIG_SATELLITE_CALLSIGN                       "PY0EFS"

/* Ports */
#define CONFIG_SPI_PORT_0_SPEED_BPS                     1000000UL

/* Antenna */
#define CONFIG_ANTENNA_INDEP_DEPLOY_BURN_TIME_SEC       10U
#define CONFIG_ANTENNA_SEQ_DEPLOY_BURN_TIME_SEC         20U
#define CONFIG_ANTENNA_DEPLOYMENT_ATTEMPTS              10U
#define CONFIG_ANTENNA_DEPLOYMENT_HIBERNATION_MIN       45U

/* Memory */
#define CONFIG_MEM_ADR_INIT_WORD                        0
#define CONFIG_MEM_ADR_SYS_TIME                         256
#define CONFIG_MEM_ADR_SYS_PARAM                        512
#define CONFIG_MEM_ADR_TC_QUEUE                         1024
#define CONFIG_MEM_INIT_WORD                            {228, 80, 142, 227, 77, 121, 176, 244}
#define CONFIG_MEM_OBDH_DATA_START_PAGE                 0U
#define CONFIG_MEM_OBDH_DATA_END_PAGE                   56999U
#define CONFIG_MEM_EPS_DATA_START_PAGE                  57000U
#define CONFIG_MEM_EPS_DATA_END_PAGE                    113999U
#define CONFIG_MEM_TTC_0_DATA_START_PAGE                114000U
#define CONFIG_MEM_TTC_0_DATA_END_PAGE                  170999U
#define CONFIG_MEM_TTC_1_DATA_START_PAGE                171000U
#define CONFIG_MEM_TTC_1_DATA_END_PAGE                  227999U
#define CONFIG_MEM_ANT_DATA_START_PAGE                  228000U
#define CONFIG_MEM_ANT_DATA_END_PAGE                    284999U
#define CONFIG_MEM_EDC_DATA_START_PAGE                  285000U
#define CONFIG_MEM_EDC_DATA_END_PAGE                    341999U
#define CONFIG_MEM_PX_DATA_START_PAGE                   342000U
#define CONFIG_MEM_PX_DATA_END_PAGE                     398999U
#define CONFIG_MEM_SBCD_PKTS_START_PAGE                 399000U
#define CONFIG_MEM_SBCD_PKTS_END_PAGE                   499999U
#define CONFIG_MEM_ADR_SYS_TIME_BAK                     0x1980U
#define CONFIG_MEM_ADR_SYS_PARAM_BAK                    0x1900U

/* Health Check Config Parameters */
#if defined(CONFIG_HEALTH_CHECK_ENABLED) && (CONFIG_HEALTH_CHECK_ENABLED == 1)

/* Tasks */
#define CONFIG_TASK_STARTUP_ENABLED                     1
#define CONFIG_TASK_WATCHDOG_RESET_ENABLED              1
#define CONFIG_TASK_HEARTBEAT_ENABLED                   0
#define CONFIG_TASK_SYSTEM_RESET_ENABLED                0
#define CONFIG_TASK_READ_SENSORS_ENABLED                0
#define CONFIG_TASK_GENERAL_TELEMETRY_ENABLED           0
#define CONFIG_TASK_TIME_CONTROL_ENABLED                0
#define CONFIG_TASK_READ_EDC_ENABLED                    1
#define CONFIG_TASK_READ_EPS_ENABLED                    0
#define CONFIG_TASK_READ_TTC_ENABLED                    0
#define CONFIG_TASK_READ_ANTENNA_ENABLED                0
#define CONFIG_TASK_DATA_LOG_ENABLED                    0
#define CONFIG_TASK_PROCESS_TC_ENABLED                  0
#define CONFIG_TASK_ANTENNA_DEPLOYMENT_ENABLED          0
#define CONFIG_TASK_POSITION_DETERMINATION_ENABLED      0
#define CONFIG_TASK_PAYLOAD_X_ENABLED                   1
#define CONFIG_TASK_HOUSEKEEPING_ENABLED                0
#define CONFIG_TASK_MISSION_MANAGER_ENABLED             1
#define CONFIG_TASK_HEALTH_CHECK_MEM_ENABLED            1
#define CONFIG_TASK_HEALTH_CHECK_MODE_ENABLED           1

/* Devices */
#define CONFIG_DEV_MEDIA_INT_ENABLED                    1
#define CONFIG_DEV_MEDIA_FRAM_ENABLED                   1
#define CONFIG_DEV_MEDIA_NOR_ENABLED                    1
#define CONFIG_DEV_LEDS_ENABLED                         0
#define CONFIG_DEV_CURRENT_SENSOR_ENABLED               0
#define CONFIG_DEV_VOLTAGE_SENSOR_ENABLED               0
#define CONFIG_DEV_TEMP_SENSOR_ENABLED                  0
#define CONFIG_DEV_EPS_ENABLED                          0
#define CONFIG_DEV_PAYLOAD_EDC_ENABLED                  1
#define CONFIG_DEV_ANTENNA_ENABLED                      0
#define CONFIG_DEV_PAYLOAD_X_ENABLED                    1

/* Drivers */
#define CONFIG_DRV_ISIS_ANTENNA_ENABLED                 0
#define CONFIG_DRV_SL_ANTENNA_ENABLED                   0

#endif

#if defined (CONFIG_TASK_HEALTH_CHECK_MEM_ENABLED) && defined (CONFIG_HEALTH_CHECK_ENABLED) && \
    (CONFIG_TASK_HEALTH_CHECK_MEM_ENABLED == 1) && (CONFIG_HEALTH_CHECK_ENABLED == 0)
#error To enable memory Health Check please set the CONFIG_HEALTH_CHECK_ENABLED flag on config.h
#endif

#if defined (CONFIG_TASK_HEALTH_CHECK_MODE_ENABLED) && defined (CONFIG_HEALTH_CHECK_ENABLED) && \
    (CONFIG_TASK_HEALTH_CHECK_MODE_ENABLED == 1) && (CONFIG_HEALTH_CHECK_ENABLED == 0)
#error To enable mode Health Check please set the CONFIG_HEALTH_CHECK_ENABLED flag on config.h
#endif

#endif /* CONFIG_H_ */

/** \} End of config group */
