spacelab-ufsc/obdh2/firmware/drivers/gpio/gpio.c

/*
 * gpio.c
 * 
 * Copyright The OBDH 2.0 Contributors.
 * 
 * This file is part of OBDH 2.0.
 * 
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
 */

/**
 * \brief GPIO driver implementation.
 * 
 * \author Gabriel Mariano Marcelino <gabriel.mm8@gmail.com>
 * 
 * \version 1.0.0
 * 
 * \date 2020/01/13
 * 
 * \addtogroup gpio
 * \{
 */

#include <hal/gpio.h>

#include <config/config.h>
#include <system/sys_log/sys_log.h>

#include "gpio.h"

static const uint16_t GPIO_PORT_TO_BASE[] = { // cppcheck-suppress misra-c2012-8.9
    0x00,
#if defined(__MSP430_HAS_PORT1_R__)
    __MSP430_BASEADDRESS_PORT1_R__,
#elif defined(__MSP430_HAS_PORT1__)
    __MSP430_BASEADDRESS_PORT1__,
#else
    0xFFFF,
#endif
#if defined(__MSP430_HAS_PORT2_R__)
    __MSP430_BASEADDRESS_PORT2_R__,
#elif defined(__MSP430_HAS_PORT2__)
    __MSP430_BASEADDRESS_PORT2__,
#else
    0xFFFF,
#endif
#if defined(__MSP430_HAS_PORT3_R__)
    __MSP430_BASEADDRESS_PORT3_R__,
#elif defined(__MSP430_HAS_PORT3__)
    __MSP430_BASEADDRESS_PORT3__,
#else
    0xFFFF,
#endif
#if defined(__MSP430_HAS_PORT4_R__)
    __MSP430_BASEADDRESS_PORT4_R__,
#elif defined(__MSP430_HAS_PORT4__)
    __MSP430_BASEADDRESS_PORT4__,
#else
    0xFFFF,
#endif
#if defined(__MSP430_HAS_PORT5_R__)
    __MSP430_BASEADDRESS_PORT5_R__,
#elif defined(__MSP430_HAS_PORT5__)
    __MSP430_BASEADDRESS_PORT5__,
#else
    0xFFFF,
#endif
#if defined(__MSP430_HAS_PORT6_R__)
    __MSP430_BASEADDRESS_PORT6_R__,
#elif defined(__MSP430_HAS_PORT6__)
    __MSP430_BASEADDRESS_PORT6__,
#else
    0xFFFF,
#endif
#if defined(__MSP430_HAS_PORT7_R__)
    __MSP430_BASEADDRESS_PORT7_R__,
#elif defined(__MSP430_HAS_PORT7__)
    __MSP430_BASEADDRESS_PORT7__,
#else
    0xFFFF,
#endif
#if defined(__MSP430_HAS_PORT8_R__)
    __MSP430_BASEADDRESS_PORT8_R__,
#elif defined(__MSP430_HAS_PORT8__)
    __MSP430_BASEADDRESS_PORT8__,
#else
    0xFFFF,
#endif
#if defined(__MSP430_HAS_PORT9_R__)
    __MSP430_BASEADDRESS_PORT9_R__,
#elif defined(__MSP430_HAS_PORT9__)
    __MSP430_BASEADDRESS_PORT9__,
#else
    0xFFFF,
#endif
#if defined(__MSP430_HAS_PORT10_R__)
    __MSP430_BASEADDRESS_PORT10_R__,
#elif defined(__MSP430_HAS_PORT10__)
    __MSP430_BASEADDRESS_PORT10__,
#else
    0xFFFF,
#endif
#if defined(__MSP430_HAS_PORT11_R__)
    __MSP430_BASEADDRESS_PORT11_R__,
#elif defined(__MSP430_HAS_PORT11__)
    __MSP430_BASEADDRESS_PORT11__,
#else
    0xFFFF,
#endif
    0xFFFF,
#if defined(__MSP430_HAS_PORTJ_R__)
    __MSP430_BASEADDRESS_PORTJ_R__
#elif defined(__MSP430_HAS_PORTJ__)
    __MSP430_BASEADDRESS_PORTJ__
#else
    0xFFFF
#endif
};

int gpio_init(gpio_pin_t pin, gpio_config_t config)
{
    int err = 0;

    uint8_t msp_port = UINT8_MAX;
    uint16_t msp_pin = UINT16_MAX;

    switch(pin)
    {
        case GPIO_PIN_0:    msp_port = GPIO_PORT_P1;    msp_pin = GPIO_PIN0;    break;
        case GPIO_PIN_1:    msp_port = GPIO_PORT_P1;    msp_pin = GPIO_PIN1;    break;
        case GPIO_PIN_2:    msp_port = GPIO_PORT_P1;    msp_pin = GPIO_PIN2;    break;
        case GPIO_PIN_3:    msp_port = GPIO_PORT_P1;    msp_pin = GPIO_PIN3;    break;
        case GPIO_PIN_4:    msp_port = GPIO_PORT_P1;    msp_pin = GPIO_PIN4;    break;
        case GPIO_PIN_5:    msp_port = GPIO_PORT_P1;    msp_pin = GPIO_PIN5;    break;
        case GPIO_PIN_6:    msp_port = GPIO_PORT_P1;    msp_pin = GPIO_PIN6;    break;
        case GPIO_PIN_7:    msp_port = GPIO_PORT_P1;    msp_pin = GPIO_PIN7;    break;
        case GPIO_PIN_8:    msp_port = GPIO_PORT_P2;    msp_pin = GPIO_PIN0;    break;
        case GPIO_PIN_9:    msp_port = GPIO_PORT_P2;    msp_pin = GPIO_PIN1;    break;
        case GPIO_PIN_10:   msp_port = GPIO_PORT_P2;    msp_pin = GPIO_PIN2;    break;
        case GPIO_PIN_11:   msp_port = GPIO_PORT_P2;    msp_pin = GPIO_PIN3;    break;
        case GPIO_PIN_12:   msp_port = GPIO_PORT_P2;    msp_pin = GPIO_PIN4;    break;
        case GPIO_PIN_13:   msp_port = GPIO_PORT_P2;    msp_pin = GPIO_PIN5;    break;
        case GPIO_PIN_14:   msp_port = GPIO_PORT_P2;    msp_pin = GPIO_PIN6;    break;
        case GPIO_PIN_15:   msp_port = GPIO_PORT_P2;    msp_pin = GPIO_PIN7;    break;
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
        case GPIO_PIN_65:   msp_port = GPIO_PORT_P9;    msp_pin = GPIO_PIN3;    break;
        case GPIO_PIN_66:   msp_port = GPIO_PORT_P9;    msp_pin = GPIO_PIN4;    break;
        case GPIO_PIN_67:   msp_port = GPIO_PORT_P9;    msp_pin = GPIO_PIN5;    break;
        case GPIO_PIN_68:   msp_port = GPIO_PORT_P9;    msp_pin = GPIO_PIN6;    break;
        case GPIO_PIN_69:   msp_port = GPIO_PORT_P9;    msp_pin = GPIO_PIN7;    break;
        default:
        #if defined(CONFIG_DRIVERS_DEBUG_ENABLED) && (CONFIG_DRIVERS_DEBUG_ENABLED == 1)
            sys_log_print_event_from_module(SYS_LOG_ERROR, GPIO_MODULE_NAME, "Invalid pin to initialize!");
            sys_log_new_line();
        #endif /* CONFIG_DRIVERS_DEBUG_ENABLED */
            err = -1;   /* Invalid GPIO pin */

            break;
    }

    if (err == 0)
    {
        if (config.mode == GPIO_MODE_OUTPUT)
        {
            GPIO_setAsOutputPin(msp_port, msp_pin);
        }
        else if (config.mode == GPIO_MODE_INPUT)
        {
            GPIO_setAsInputPin(msp_port, msp_pin);
        }
        else
        {
        #if defined(CONFIG_DRIVERS_DEBUG_ENABLED) && (CONFIG_DRIVERS_DEBUG_ENABLED == 1)
            sys_log_print_event_from_module(SYS_LOG_ERROR, GPIO_MODULE_NAME, "Invalid mode during the initialization!");
            sys_log_new_line();
        #endif /* CONFIG_DRIVERS_DEBUG_ENABLED */
            err = -1;   /* Invalid mode */
        }
    }

    return err;
}

int gpio_set_state(gpio_pin_t pin, bool level)
{
    int err = 0;

    uint8_t msp_port = UINT8_MAX;
    uint16_t msp_pin = UINT16_MAX;

    switch(pin)
    {
        case GPIO_PIN_0:    msp_port = GPIO_PORT_P1;    msp_pin = GPIO_PIN0;    break;
        case GPIO_PIN_1:    msp_port = GPIO_PORT_P1;    msp_pin = GPIO_PIN1;    break;
        case GPIO_PIN_2:    msp_port = GPIO_PORT_P1;    msp_pin = GPIO_PIN2;    break;
        case GPIO_PIN_3:    msp_port = GPIO_PORT_P1;    msp_pin = GPIO_PIN3;    break;
        case GPIO_PIN_4:    msp_port = GPIO_PORT_P1;    msp_pin = GPIO_PIN4;    break;
        case GPIO_PIN_5:    msp_port = GPIO_PORT_P1;    msp_pin = GPIO_PIN5;    break;
        case GPIO_PIN_6:    msp_port = GPIO_PORT_P1;    msp_pin = GPIO_PIN6;    break;
        case GPIO_PIN_7:    msp_port = GPIO_PORT_P1;    msp_pin = GPIO_PIN7;    break;
        case GPIO_PIN_8:    msp_port = GPIO_PORT_P2;    msp_pin = GPIO_PIN0;    break;
        case GPIO_PIN_9:    msp_port = GPIO_PORT_P2;    msp_pin = GPIO_PIN1;    break;
        case GPIO_PIN_10:   msp_port = GPIO_PORT_P2;    msp_pin = GPIO_PIN2;    break;
        case GPIO_PIN_11:   msp_port = GPIO_PORT_P2;    msp_pin = GPIO_PIN3;    break;
        case GPIO_PIN_12:   msp_port = GPIO_PORT_P2;    msp_pin = GPIO_PIN4;    break;
        case GPIO_PIN_13:   msp_port = GPIO_PORT_P2;    msp_pin = GPIO_PIN5;    break;
        case GPIO_PIN_14:   msp_port = GPIO_PORT_P2;    msp_pin = GPIO_PIN6;    break;
        case GPIO_PIN_15:   msp_port = GPIO_PORT_P2;    msp_pin = GPIO_PIN7;    break;
        case GPIO_PIN_16:   msp_port = GPIO_PORT_P3;    msp_pin = GPIO_PIN0;    break;
        case GPIO_PIN_17:   msp_port = GPIO_PORT_P3;    msp_pin = GPIO_PIN1;    break;
        case GPIO_PIN_18:   msp_port = GPIO_PORT_P3;    msp_pin = GPIO_PIN2;    break;
        case GPIO_PIN_19:   msp_port = GPIO_PORT_P3;    msp_pin = GPIO_PIN3;    break;
        case GPIO_PIN_20:   msp_port = GPIO_PORT_P3;    msp_pin = GPIO_PIN4;    break;
        case GPIO_PIN_21:   msp_port = GPIO_PORT_P3;    msp_pin = GPIO_PIN5;    break;
        case GPIO_PIN_22:   msp_port = GPIO_PORT_P3;    msp_pin = GPIO_PIN6;    break;
        case GPIO_PIN_23:   msp_port = GPIO_PORT_P3;    msp_pin = GPIO_PIN7;    break;
        case GPIO_PIN_24:   msp_port = GPIO_PORT_P4;    msp_pin = GPIO_PIN0;    break;
        case GPIO_PIN_25:   msp_port = GPIO_PORT_P4;    msp_pin = GPIO_PIN1;    break;
        case GPIO_PIN_26:   msp_port = GPIO_PORT_P4;    msp_pin = GPIO_PIN2;    break;
        case GPIO_PIN_27:   msp_port = GPIO_PORT_P4;    msp_pin = GPIO_PIN3;    break;
        case GPIO_PIN_28:   msp_port = GPIO_PORT_P4;    msp_pin = GPIO_PIN4;    break;
        case GPIO_PIN_29:   msp_port = GPIO_PORT_P4;    msp_pin = GPIO_PIN5;    break;
        case GPIO_PIN_30:   msp_port = GPIO_PORT_P4;    msp_pin = GPIO_PIN6;    break;
        case GPIO_PIN_31:   msp_port = GPIO_PORT_P4;    msp_pin = GPIO_PIN7;    break;
        case GPIO_PIN_32:   msp_port = GPIO_PORT_P5;    msp_pin = GPIO_PIN0;    break;
        case GPIO_PIN_33:   msp_port = GPIO_PORT_P5;    msp_pin = GPIO_PIN1;    break;
        case GPIO_PIN_34:   msp_port = GPIO_PORT_P5;    msp_pin = GPIO_PIN2;    break;
        case GPIO_PIN_35:   msp_port = GPIO_PORT_P5;    msp_pin = GPIO_PIN3;    break;
        case GPIO_PIN_36:   msp_port = GPIO_PORT_P5;    msp_pin = GPIO_PIN4;    break;
        case GPIO_PIN_37:   msp_port = GPIO_PORT_P5;    msp_pin = GPIO_PIN5;    break;
        case GPIO_PIN_38:   msp_port = GPIO_PORT_P5;    msp_pin = GPIO_PIN6;    break;
        case GPIO_PIN_39:   msp_port = GPIO_PORT_P5;    msp_pin = GPIO_PIN7;    break;
        case GPIO_PIN_40:   msp_port = GPIO_PORT_P6;    msp_pin = GPIO_PIN0;    break;
        case GPIO_PIN_41:   msp_port = GPIO_PORT_P6;    msp_pin = GPIO_PIN1;    break;
        case GPIO_PIN_42:   msp_port = GPIO_PORT_P6;    msp_pin = GPIO_PIN2;    break;
        case GPIO_PIN_43:   msp_port = GPIO_PORT_P6;    msp_pin = GPIO_PIN3;    break;
        case GPIO_PIN_44:   msp_port = GPIO_PORT_P6;    msp_pin = GPIO_PIN4;    break;
        case GPIO_PIN_45:   msp_port = GPIO_PORT_P6;    msp_pin = GPIO_PIN5;    break;
        case GPIO_PIN_46:   msp_port = GPIO_PORT_P6;    msp_pin = GPIO_PIN6;    break;
        case GPIO_PIN_47:   msp_port = GPIO_PORT_P6;    msp_pin = GPIO_PIN7;    break;
        case GPIO_PIN_48:   msp_port = GPIO_PORT_P7;    msp_pin = GPIO_PIN2;    break;
        case GPIO_PIN_49:   msp_port = GPIO_PORT_P7;    msp_pin = GPIO_PIN3;    break;
        case GPIO_PIN_50:   msp_port = GPIO_PORT_P7;    msp_pin = GPIO_PIN4;    break;
        case GPIO_PIN_51:   msp_port = GPIO_PORT_P7;    msp_pin = GPIO_PIN5;    break;
        case GPIO_PIN_52:   msp_port = GPIO_PORT_P7;    msp_pin = GPIO_PIN6;    break;
        case GPIO_PIN_53:   msp_port = GPIO_PORT_P7;    msp_pin = GPIO_PIN7;    break;
        case GPIO_PIN_54:   msp_port = GPIO_PORT_P8;    msp_pin = GPIO_PIN0;    break;
        case GPIO_PIN_55:   msp_port = GPIO_PORT_P8;    msp_pin = GPIO_PIN1;    break;
        case GPIO_PIN_56:   msp_port = GPIO_PORT_P8;    msp_pin = GPIO_PIN2;    break;
        case GPIO_PIN_57:   msp_port = GPIO_PORT_P8;    msp_pin = GPIO_PIN3;    break;
        case GPIO_PIN_58:   msp_port = GPIO_PORT_P8;    msp_pin = GPIO_PIN4;    break;
        case GPIO_PIN_59:   msp_port = GPIO_PORT_P8;    msp_pin = GPIO_PIN5;    break;
        case GPIO_PIN_60:   msp_port = GPIO_PORT_P8;    msp_pin = GPIO_PIN6;    break;
        case GPIO_PIN_61:   msp_port = GPIO_PORT_P8;    msp_pin = GPIO_PIN7;    break;
        case GPIO_PIN_62:   msp_port = GPIO_PORT_P9;    msp_pin = GPIO_PIN0;    break;
        case GPIO_PIN_63:   msp_port = GPIO_PORT_P9;    msp_pin = GPIO_PIN1;    break;
        case GPIO_PIN_64:   msp_port = GPIO_PORT_P9;    msp_pin = GPIO_PIN2;    break;
        case GPIO_PIN_65:   msp_port = GPIO_PORT_P9;    msp_pin = GPIO_PIN3;    break;
        case GPIO_PIN_66:   msp_port = GPIO_PORT_P9;    msp_pin = GPIO_PIN4;    break;
        case GPIO_PIN_67:   msp_port = GPIO_PORT_P9;    msp_pin = GPIO_PIN5;    break;
        case GPIO_PIN_68:   msp_port = GPIO_PORT_P9;    msp_pin = GPIO_PIN6;    break;
        case GPIO_PIN_69:   msp_port = GPIO_PORT_P9;    msp_pin = GPIO_PIN7;    break;
        default:
        #if defined(CONFIG_DRIVERS_DEBUG_ENABLED) && (CONFIG_DRIVERS_DEBUG_ENABLED == 1)
            sys_log_print_event_from_module(SYS_LOG_ERROR, GPIO_MODULE_NAME, "Invalid pin to set!");
            sys_log_new_line();
        #endif /* CONFIG_DRIVERS_DEBUG_ENABLED */
            err = -1;   /* Invalid GPIO pin */

            break;
    }

    if (level)
    {
        GPIO_setOutputHighOnPin(msp_port, msp_pin);
    }
    else
    {
        GPIO_setOutputLowOnPin(msp_port, msp_pin);
    }

    return err;
}

int gpio_get_state(gpio_pin_t pin)
{
    int res = 0;

    uint8_t msp_port = UINT8_MAX;
    uint16_t msp_pin = UINT16_MAX;

    switch(pin)
    {
        case GPIO_PIN_0:    msp_port = GPIO_PORT_P1;    msp_pin = GPIO_PIN0;    break;
        case GPIO_PIN_1:    msp_port = GPIO_PORT_P1;    msp_pin = GPIO_PIN1;    break;
        case GPIO_PIN_2:    msp_port = GPIO_PORT_P1;    msp_pin = GPIO_PIN2;    break;
        case GPIO_PIN_3:    msp_port = GPIO_PORT_P1;    msp_pin = GPIO_PIN3;    break;
        case GPIO_PIN_4:    msp_port = GPIO_PORT_P1;    msp_pin = GPIO_PIN4;    break;
        case GPIO_PIN_5:    msp_port = GPIO_PORT_P1;    msp_pin = GPIO_PIN5;    break;
        case GPIO_PIN_6:    msp_port = GPIO_PORT_P1;    msp_pin = GPIO_PIN6;    break;
        case GPIO_PIN_7:    msp_port = GPIO_PORT_P1;    msp_pin = GPIO_PIN7;    break;
        case GPIO_PIN_8:    msp_port = GPIO_PORT_P2;    msp_pin = GPIO_PIN0;    break;
        case GPIO_PIN_9:    msp_port = GPIO_PORT_P2;    msp_pin = GPIO_PIN1;    break;
        case GPIO_PIN_10:   msp_port = GPIO_PORT_P2;    msp_pin = GPIO_PIN2;    break;
        case GPIO_PIN_11:   msp_port = GPIO_PORT_P2;    msp_pin = GPIO_PIN3;    break;
        case GPIO_PIN_12:   msp_port = GPIO_PORT_P2;    msp_pin = GPIO_PIN4;    break;
        case GPIO_PIN_13:   msp_port = GPIO_PORT_P2;    msp_pin = GPIO_PIN5;    break;
        case GPIO_PIN_14:   msp_port = GPIO_PORT_P2;    msp_pin = GPIO_PIN6;    break;
        case GPIO_PIN_15:   msp_port = GPIO_PORT_P2;    msp_pin = GPIO_PIN7;    break;
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
        case GPIO_PIN_65:   msp_port = GPIO_PORT_P9;    msp_pin = GPIO_PIN3;    break;
        case GPIO_PIN_66:   msp_port = GPIO_PORT_P9;    msp_pin = GPIO_PIN4;    break;
        case GPIO_PIN_67:   msp_port = GPIO_PORT_P9;    msp_pin = GPIO_PIN5;    break;
        case GPIO_PIN_68:   msp_port = GPIO_PORT_P9;    msp_pin = GPIO_PIN6;    break;
        case GPIO_PIN_69:   msp_port = GPIO_PORT_P9;    msp_pin = GPIO_PIN7;    break;
        default:
        #if defined(CONFIG_DRIVERS_DEBUG_ENABLED) && (CONFIG_DRIVERS_DEBUG_ENABLED == 1)
            sys_log_print_event_from_module(SYS_LOG_ERROR, GPIO_MODULE_NAME, "Invalid pin to read!");
            sys_log_new_line();
        #endif /* CONFIG_DRIVERS_DEBUG_ENABLED */
            res = -1;   /* Invalid GPIO pin */

            break;
    }

    if (GPIO_getInputPinValue(msp_port, msp_pin) == (uint8_t)GPIO_INPUT_PIN_HIGH)
    {
        res = 1;
    }
    else
    {
        res = 0;
    }

    return res;
}

int gpio_toggle(gpio_pin_t pin)
{
    int err = 0;

    uint8_t msp_port = UINT8_MAX;
    uint16_t msp_pin = UINT16_MAX;

    switch(pin)
    {
        case GPIO_PIN_0:    msp_port = GPIO_PORT_P1;    msp_pin = GPIO_PIN0;    break;
        case GPIO_PIN_1:    msp_port = GPIO_PORT_P1;    msp_pin = GPIO_PIN1;    break;
        case GPIO_PIN_2:    msp_port = GPIO_PORT_P1;    msp_pin = GPIO_PIN2;    break;
        case GPIO_PIN_3:    msp_port = GPIO_PORT_P1;    msp_pin = GPIO_PIN3;    break;
        case GPIO_PIN_4:    msp_port = GPIO_PORT_P1;    msp_pin = GPIO_PIN4;    break;
        case GPIO_PIN_5:    msp_port = GPIO_PORT_P1;    msp_pin = GPIO_PIN5;    break;
        case GPIO_PIN_6:    msp_port = GPIO_PORT_P1;    msp_pin = GPIO_PIN6;    break;
        case GPIO_PIN_7:    msp_port = GPIO_PORT_P1;    msp_pin = GPIO_PIN7;    break;
        case GPIO_PIN_8:    msp_port = GPIO_PORT_P2;    msp_pin = GPIO_PIN0;    break;
        case GPIO_PIN_9:    msp_port = GPIO_PORT_P2;    msp_pin = GPIO_PIN1;    break;
        case GPIO_PIN_10:   msp_port = GPIO_PORT_P2;    msp_pin = GPIO_PIN2;    break;
        case GPIO_PIN_11:   msp_port = GPIO_PORT_P2;    msp_pin = GPIO_PIN3;    break;
        case GPIO_PIN_12:   msp_port = GPIO_PORT_P2;    msp_pin = GPIO_PIN4;    break;
        case GPIO_PIN_13:   msp_port = GPIO_PORT_P2;    msp_pin = GPIO_PIN5;    break;
        case GPIO_PIN_14:   msp_port = GPIO_PORT_P2;    msp_pin = GPIO_PIN6;    break;
        case GPIO_PIN_15:   msp_port = GPIO_PORT_P2;    msp_pin = GPIO_PIN7;    break;
        case GPIO_PIN_16:   msp_port = GPIO_PORT_P3;    msp_pin = GPIO_PIN0;    break;
        case GPIO_PIN_17:   msp_port = GPIO_PORT_P3;    msp_pin = GPIO_PIN1;    break;
        case GPIO_PIN_18:   msp_port = GPIO_PORT_P3;    msp_pin = GPIO_PIN2;    break;
        case GPIO_PIN_19:   msp_port = GPIO_PORT_P3;    msp_pin = GPIO_PIN3;    break;
        case GPIO_PIN_20:   msp_port = GPIO_PORT_P3;    msp_pin = GPIO_PIN4;    break;
        case GPIO_PIN_21:   msp_port = GPIO_PORT_P3;    msp_pin = GPIO_PIN5;    break;
        case GPIO_PIN_22:   msp_port = GPIO_PORT_P3;    msp_pin = GPIO_PIN6;    break;
        case GPIO_PIN_23:   msp_port = GPIO_PORT_P3;    msp_pin = GPIO_PIN7;    break;
        case GPIO_PIN_24:   msp_port = GPIO_PORT_P4;    msp_pin = GPIO_PIN0;    break;
        case GPIO_PIN_25:   msp_port = GPIO_PORT_P4;    msp_pin = GPIO_PIN1;    break;
        case GPIO_PIN_26:   msp_port = GPIO_PORT_P4;    msp_pin = GPIO_PIN2;    break;
        case GPIO_PIN_27:   msp_port = GPIO_PORT_P4;    msp_pin = GPIO_PIN3;    break;
        case GPIO_PIN_28:   msp_port = GPIO_PORT_P4;    msp_pin = GPIO_PIN4;    break;
        case GPIO_PIN_29:   msp_port = GPIO_PORT_P4;    msp_pin = GPIO_PIN5;    break;
        case GPIO_PIN_30:   msp_port = GPIO_PORT_P4;    msp_pin = GPIO_PIN6;    break;
        case GPIO_PIN_31:   msp_port = GPIO_PORT_P4;    msp_pin = GPIO_PIN7;    break;
        case GPIO_PIN_32:   msp_port = GPIO_PORT_P5;    msp_pin = GPIO_PIN0;    break;
        case GPIO_PIN_33:   msp_port = GPIO_PORT_P5;    msp_pin = GPIO_PIN1;    break;
        case GPIO_PIN_34:   msp_port = GPIO_PORT_P5;    msp_pin = GPIO_PIN2;    break;
        case GPIO_PIN_35:   msp_port = GPIO_PORT_P5;    msp_pin = GPIO_PIN3;    break;
        case GPIO_PIN_36:   msp_port = GPIO_PORT_P5;    msp_pin = GPIO_PIN4;    break;
        case GPIO_PIN_37:   msp_port = GPIO_PORT_P5;    msp_pin = GPIO_PIN5;    break;
        case GPIO_PIN_38:   msp_port = GPIO_PORT_P5;    msp_pin = GPIO_PIN6;    break;
        case GPIO_PIN_39:   msp_port = GPIO_PORT_P5;    msp_pin = GPIO_PIN7;    break;
        case GPIO_PIN_40:   msp_port = GPIO_PORT_P6;    msp_pin = GPIO_PIN0;    break;
        case GPIO_PIN_41:   msp_port = GPIO_PORT_P6;    msp_pin = GPIO_PIN1;    break;
        case GPIO_PIN_42:   msp_port = GPIO_PORT_P6;    msp_pin = GPIO_PIN2;    break;
        case GPIO_PIN_43:   msp_port = GPIO_PORT_P6;    msp_pin = GPIO_PIN3;    break;
        case GPIO_PIN_44:   msp_port = GPIO_PORT_P6;    msp_pin = GPIO_PIN4;    break;
        case GPIO_PIN_45:   msp_port = GPIO_PORT_P6;    msp_pin = GPIO_PIN5;    break;
        case GPIO_PIN_46:   msp_port = GPIO_PORT_P6;    msp_pin = GPIO_PIN6;    break;
        case GPIO_PIN_47:   msp_port = GPIO_PORT_P6;    msp_pin = GPIO_PIN7;    break;
        case GPIO_PIN_48:   msp_port = GPIO_PORT_P7;    msp_pin = GPIO_PIN2;    break;
        case GPIO_PIN_49:   msp_port = GPIO_PORT_P7;    msp_pin = GPIO_PIN3;    break;
        case GPIO_PIN_50:   msp_port = GPIO_PORT_P7;    msp_pin = GPIO_PIN4;    break;
        case GPIO_PIN_51:   msp_port = GPIO_PORT_P7;    msp_pin = GPIO_PIN5;    break;
        case GPIO_PIN_52:   msp_port = GPIO_PORT_P7;    msp_pin = GPIO_PIN6;    break;
        case GPIO_PIN_53:   msp_port = GPIO_PORT_P7;    msp_pin = GPIO_PIN7;    break;
        case GPIO_PIN_54:   msp_port = GPIO_PORT_P8;    msp_pin = GPIO_PIN0;    break;
        case GPIO_PIN_55:   msp_port = GPIO_PORT_P8;    msp_pin = GPIO_PIN1;    break;
        case GPIO_PIN_56:   msp_port = GPIO_PORT_P8;    msp_pin = GPIO_PIN2;    break;
        case GPIO_PIN_57:   msp_port = GPIO_PORT_P8;    msp_pin = GPIO_PIN3;    break;
        case GPIO_PIN_58:   msp_port = GPIO_PORT_P8;    msp_pin = GPIO_PIN4;    break;
        case GPIO_PIN_59:   msp_port = GPIO_PORT_P8;    msp_pin = GPIO_PIN5;    break;
        case GPIO_PIN_60:   msp_port = GPIO_PORT_P8;    msp_pin = GPIO_PIN6;    break;
        case GPIO_PIN_61:   msp_port = GPIO_PORT_P8;    msp_pin = GPIO_PIN7;    break;
        case GPIO_PIN_62:   msp_port = GPIO_PORT_P9;    msp_pin = GPIO_PIN0;    break;
        case GPIO_PIN_63:   msp_port = GPIO_PORT_P9;    msp_pin = GPIO_PIN1;    break;
        case GPIO_PIN_64:   msp_port = GPIO_PORT_P9;    msp_pin = GPIO_PIN2;    break;
        case GPIO_PIN_65:   msp_port = GPIO_PORT_P9;    msp_pin = GPIO_PIN3;    break;
        case GPIO_PIN_66:   msp_port = GPIO_PORT_P9;    msp_pin = GPIO_PIN4;    break;
        case GPIO_PIN_67:   msp_port = GPIO_PORT_P9;    msp_pin = GPIO_PIN5;    break;
        case GPIO_PIN_68:   msp_port = GPIO_PORT_P9;    msp_pin = GPIO_PIN6;    break;
        case GPIO_PIN_69:   msp_port = GPIO_PORT_P9;    msp_pin = GPIO_PIN7;    break;
        default:
        #if defined(CONFIG_DRIVERS_DEBUG_ENABLED) && (CONFIG_DRIVERS_DEBUG_ENABLED == 1)
            sys_log_print_event_from_module(SYS_LOG_ERROR, GPIO_MODULE_NAME, "Invalid pin to toggle!");
            sys_log_new_line();
        #endif /* CONFIG_DRIVERS_DEBUG_ENABLED */
            err = -1;   /* Invalid GPIO pin */

            break;
    }

    GPIO_toggleOutputOnPin(msp_port, msp_pin);

    return err;
}

int gpio_init_mr_pin(gpio_pin_t mr_pin)
{
    int err = 0;

    uint8_t msp_port = UINT8_MAX;
    uint16_t msp_pin = UINT16_MAX;

    switch(mr_pin)
    {
        case GPIO_PIN_0:    msp_port = GPIO_PORT_P1;    msp_pin = GPIO_PIN0;    break;
        case GPIO_PIN_1:    msp_port = GPIO_PORT_P1;    msp_pin = GPIO_PIN1;    break;
        case GPIO_PIN_2:    msp_port = GPIO_PORT_P1;    msp_pin = GPIO_PIN2;    break;
        case GPIO_PIN_3:    msp_port = GPIO_PORT_P1;    msp_pin = GPIO_PIN3;    break;
        case GPIO_PIN_4:    msp_port = GPIO_PORT_P1;    msp_pin = GPIO_PIN4;    break;
        case GPIO_PIN_5:    msp_port = GPIO_PORT_P1;    msp_pin = GPIO_PIN5;    break;
        case GPIO_PIN_6:    msp_port = GPIO_PORT_P1;    msp_pin = GPIO_PIN6;    break;
        case GPIO_PIN_7:    msp_port = GPIO_PORT_P1;    msp_pin = GPIO_PIN7;    break;
        case GPIO_PIN_8:    msp_port = GPIO_PORT_P2;    msp_pin = GPIO_PIN0;    break;
        case GPIO_PIN_9:    msp_port = GPIO_PORT_P2;    msp_pin = GPIO_PIN1;    break;
        case GPIO_PIN_10:   msp_port = GPIO_PORT_P2;    msp_pin = GPIO_PIN2;    break;
        case GPIO_PIN_11:   msp_port = GPIO_PORT_P2;    msp_pin = GPIO_PIN3;    break;
        case GPIO_PIN_12:   msp_port = GPIO_PORT_P2;    msp_pin = GPIO_PIN4;    break;
        case GPIO_PIN_13:   msp_port = GPIO_PORT_P2;    msp_pin = GPIO_PIN5;    break;
        case GPIO_PIN_14:   msp_port = GPIO_PORT_P2;    msp_pin = GPIO_PIN6;    break;
        case GPIO_PIN_15:   msp_port = GPIO_PORT_P2;    msp_pin = GPIO_PIN7;    break;
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
        case GPIO_PIN_65:   msp_port = GPIO_PORT_P9;    msp_pin = GPIO_PIN3;    break;
        case GPIO_PIN_66:   msp_port = GPIO_PORT_P9;    msp_pin = GPIO_PIN4;    break;
        case GPIO_PIN_67:   msp_port = GPIO_PORT_P9;    msp_pin = GPIO_PIN5;    break;
        case GPIO_PIN_68:   msp_port = GPIO_PORT_P9;    msp_pin = GPIO_PIN6;    break;
        case GPIO_PIN_69:   msp_port = GPIO_PORT_P9;    msp_pin = GPIO_PIN7;    break;
        default:
        #if defined(CONFIG_DRIVERS_DEBUG_ENABLED) && (CONFIG_DRIVERS_DEBUG_ENABLED == 1)
            sys_log_print_event_from_module(SYS_LOG_ERROR, GPIO_MODULE_NAME, "Invalid mr pin to initialize!");
            sys_log_new_line();
        #endif /* CONFIG_DRIVERS_DEBUG_ENABLED */
            err = -1;   /* Invalid GPIO pin */

            break;
    }

    if (err == 0)
    {
        uint16_t base_address = GPIO_PORT_TO_BASE[msp_port];

    #ifndef NDEBUG
        if (base_address != 0xFFFFU)
        {
            /* Shift by 8 if port is even (upper 8-bits) */
            if (((msp_port & 1U) ^ 1U) > 0U)
            {
                msp_pin <<= 8;
            }

            /* Instruction to impose MR pin as high and avoid auto-reset. */
            HWREG16(base_address + OFS_PAOUT) |= msp_pin;

            HWREG16(base_address + OFS_PASEL) &= ~msp_pin;
            HWREG16(base_address + OFS_PADIR) |= msp_pin;
        }
    #else
        /* Shift by 8 if port is even (upper 8-bits) */
        if (((msp_port & 1U) ^ 1U) > 0U)
        {
            msp_pin <<= 8;
        }

        /* Instruction to impose MR pin as high and avoid auto-reset. */
        HWREG16(base_address + OFS_PAOUT) |= msp_pin;

        HWREG16(base_address + OFS_PASEL) &= ~msp_pin;
        HWREG16(base_address + OFS_PADIR) |= msp_pin;
    #endif /* NDEBUG */
    }

    return err;
}

/** \} End of gpio group */
