spacelab-ufsc/obdh2/firmware/drivers/sl_ttc2/sl_ttc2.h

/*
 * sl_ttc2.h
 * 
 * Copyright The OBDH 2.0 Contributors.
 * 
 * This file is part of OBDH 2.0.
 * 
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
 */

/**
 * \brief SpaceLab TTC 2.0 driver definition.
 * 
 * \author Gabriel Mariano Marcelino <gabriel.mm8@gmail.com>
 * \author Carlos Augusto Porto Freitas <carlos.portof@hotmail.com>
 * 
 * \version 1.0.0
 * 
 * \date 2021/05/12
 * 
 * \defgroup sl_ttc2 SpaceLab TTC 2.0
 * \ingroup drivers
 * \{
 */

#ifndef SL_TTC2_H_
#define SL_TTC2_H_

#include <stdbool.h>
#include <stdint.h>

#include <drivers/spi/spi.h>

#define SL_TTC2_MODULE_NAME                     "SL_TTC2"

/* TTC 2.0 IDs */
#define SL_TTC2_DEVICE_ID_RADIO_0               0xCC2AU /**< TTC 2.0 device ID (radio 1). */
#define SL_TTC2_DEVICE_ID_RADIO_1               0xCC2BU /**< TTC 2.0 device ID (radio 2). */

/* TTC 2.0 Mutex wait time */
#define SL_TTC2_MUTEX_WAIT_TIME_MS              5000U   /**< TTC 2.0 mutex wait time. */

/* TTC 2.0 Protocol timing */
#define SL_TTC2_TRANSACTION_DELAY_MS            110U   /**< TTC 2.0 protocol transaction delay. */
#define SL_TTC2_EXTRA_MUTEX_DELAY_MS            100U     /**< Delay after transaction, used to give TTC 2.0 more time to process next request. */

/* TTC 2.0 Preamble byte */
#define SL_TTC2_PKT_PREAMBLE                    0x7EU   /**< Preamble byte value. */

/* TTC 2.0 Commands */
#define SL_TTC2_CMD_NOP                         0U      /**< No operation. */
#define SL_TTC2_CMD_READ_REG                    1U      /**< Read register command. */
#define SL_TTC2_CMD_WRITE_REG                   2U      /**< Write register command. */
#define SL_TTC2_CMD_TRANSMIT_PKT                3U      /**< Transmit packet command. */
#define SL_TTC2_CMD_RECEIVE_PKT                 4U      /**< Receive packet command. */

/* TTC 2.0 Registers */
#define SL_TTC2_REG_DEVICE_ID                   0U      /**< Device ID (0xCC2A or 0xCC2B). */
#define SL_TTC2_REG_HARDWARE_VERSION            1U      /**< Hardware version. */
#define SL_TTC2_REG_FIRMWARE_VERSION            2U      /**< Firmware version. */
#define SL_TTC2_REG_TIME_COUNTER                3U      /**< Time counter in millseconds. */
#define SL_TTC2_REG_RESET_COUNTER               4U      /**< Reset counter. */
#define SL_TTC2_REG_LAST_RESET_CAUSE            5U      /**< Last reset cause. */
#define SL_TTC2_REG_INPUT_VOLTAGE_MCU           6U      /**< Input voltage of the uC in mV. */
#define SL_TTC2_REG_INPUT_CURRENT_MCU           7U      /**< Input current of the uC in mA. */
#define SL_TTC2_REG_TEMPERATURE_MCU             8U      /**< Temperature of the uC in K. */
#define SL_TTC2_REG_INPUT_VOLTAGE_RADIO         9U      /**< Input voltage of the radio in mV. */
#define SL_TTC2_REG_INPUT_CURRENT_RADIO         10U     /**< Input current of the radio in mA. */
#define SL_TTC2_REG_TEMPERATURE_RADIO           11U     /**< Temperature of the radio in K. */
#define SL_TTC2_REG_LAST_VALID_TC               12U     /**< Last valid telecommand (uplink packet ID). */
#define SL_TTC2_REG_RSSI_LAST_VALID_TC          13U     /**< RSSI of the last valid telecommand. */
#define SL_TTC2_REG_TEMPERATURE_ANTENNA         14U     /**< Temperature of the antenna module in K. */
#define SL_TTC2_REG_ANTENNA_STATUS              15U     /**< Antenna module status bits. */
#define SL_TTC2_REG_ANTENNA_DEPLOYMENT_STATUS   16U     /**< Antenna deployment status (0=never executed, 1=executed). */
#define SL_TTC2_REG_ANTENNA_DEP_HIB_STATUS      17U     /**< Antenna deployment hibernation status (0=never executed, 1=executed). */
#define SL_TTC2_REG_TX_ENABLE                   18U     /**< TX enable (0=off, 1=on). */
#define SL_TTC2_REG_TX_PACKET_COUNTER           19U     /**< TX packet counter. */
#define SL_TTC2_REG_RX_PACKET_COUNTER           20U     /**< RX packet counter. */
#define SL_TTC2_REG_FIFO_TX_PACKET              21U     /**< Number of packets in the TX FIFO. */
#define SL_TTC2_REG_FIFO_RX_PACKET              22U     /**< Number of packets in the RX FIFO. */
#define SL_TTC2_REG_LEN_FIRST_RX_PACKET_IN_FIFO 23U     /**< Number of bytes of the first available packet in the RX buffer. */
#define SL_TTC2_REG_RESET_DEVICE                24U     /**< Register to reset device */
#define SL_TTC2_REG_CONSEQ_FAILED_PACKETS       25U     /**< Number of consecutive radio decoding errors */

/**
 * \brief Temperature type.
 */
typedef uint16_t sl_ttc2_temp_t;

/**
 * \brief Voltage type.
 */
typedef uint16_t sl_ttc2_voltage_t;

/**
 * \brief Current type.
 */
typedef uint16_t sl_ttc2_current_t;

/**
 * \brief RSSI type.
 */
typedef uint16_t sl_ttc2_rssi_t;

/**
 * \brief Radio ID.
 */
typedef enum
{
    SL_TTC2_RADIO_0=0,                                  /**< TTC radio 0. */
    SL_TTC2_RADIO_1                                     /**< TTC radio 1. */
} sl_ttc2_radio_e;

/**
 * \brief Voltage types.
 */
typedef enum
{
    SL_TTC2_VOLTAGE_MCU=0,                              /**< MCU input voltage. */
    SL_TTC2_VOLTAGE_RADIO                               /**< Radio input voltage. */
} sl_ttc2_voltage_e;

/**
 * \brief Current types.
 */
typedef enum
{
    SL_TTC2_CURRENT_MCU=0,                              /**< MCU input current. */
    SL_TTC2_CURRENT_RADIO                               /**< Radio input current. */
} sl_ttc2_current_e;

/**
 * \brief Temperature types.
 */
typedef enum
{
    SL_TTC2_TEMP_MCU=0,                                 /**< MCU temperature. */
    SL_TTC2_TEMP_RADIO,                                 /**< Radio temperature. */
    SL_TTC2_TEMP_ANTENNA                                /**< Antenna temperature. */
} sl_ttc2_temp_e;

/**
 * \brief Packet types.
 */
typedef enum
{
    SL_TTC2_TX_PKT=0,                                   /**< TX packet. */
    SL_TTC2_RX_PKT                                      /**< RX packet. */
} sl_ttc2_pkt_e;

/**
 * \brief Data structure.
 */
typedef struct
{
    uint32_t                time_counter;               /**< Time counter in milliseconds. */
    uint16_t                reset_counter;              /**< Reset counter. */
    uint8_t                 last_reset_cause;           /**< Last reset cause. */
    sl_ttc2_voltage_t       voltage_mcu;                /**< Input voltage of the uC in mV. */
    sl_ttc2_current_t       current_mcu;                /**< Input current of the uC in mA. */
    sl_ttc2_temp_t          temperature_mcu;            /**< Temperature of the uC in K. */
    sl_ttc2_voltage_t       voltage_radio;              /**< Input voltage of the radio in mV. */
    sl_ttc2_current_t       current_radio;              /**< Input current of the radio in mA. */
    sl_ttc2_temp_t          temperature_radio;          /**< Temperature of the radio in K. */
    uint8_t                 last_valid_tc;              /**< Last valid telecommand (uplink packet ID). */
    sl_ttc2_rssi_t          rssi_last_valid_tc;         /**< RSSI of the last valid telecommand. */
    sl_ttc2_temp_t          temperature_antenna;        /**< Temperature of the antenna module in K. */
    uint16_t                antenna_status;             /**< Antenna module status bits. */
    uint8_t                 deployment_status;          /**< Antenna deployment status (0=never executed, 1=executed). */
    uint8_t                 hibernation_status;         /**< Antenna deployment hibernation (0=never executed, 1=executed). */
    uint32_t                tx_packet_counter;          /**< TX packet counter. */
    uint32_t                rx_packet_counter;          /**< RX packet counter. */
} sl_ttc2_hk_data_t;

/**
 * \brief TTC 2.0 configuration type.
 */
typedef struct
{
    spi_port_t port;                /**< SPI port. */
    spi_cs_t cs_pin;                /**< SPI CS pin. */
    spi_config_t port_config;       /**< SPI configuration. */
    sl_ttc2_radio_e id;             /**< Device ID (radio 1 or 2). */
} sl_ttc2_config_t;

/**
 * \brief Initialization of the TTC module driver.
 *
 * \param[in] config is a structure with the configuration parameters of the driver.
 *
 * \return The status/error code.
 */
int sl_ttc2_init(sl_ttc2_config_t *config);

/**
 * \brief Verifies the TTC ID code.
 *
 * This function is useful to test the connection with the TTC module.
 *
 * \param[in] config is a structure with the configuration parameters of the driver.
 *
 * \return The status/error code.
 */
int sl_ttc2_check_device(sl_ttc2_config_t *config);

/**
 * \brief Writes a value to a register of the TTC module.
 *
 * \param[in] config is a structure with the configuration parameters of the driver.
 *
 * \param[in] adr is the register address to write.
 *
 * \param[in,out] val is the value to write to the given register.
 *
 * \return The status/error code.
 */
int sl_ttc2_write_reg(sl_ttc2_config_t *config, uint8_t adr, uint32_t val);

/**
 * \brief Reads a register from the TTC module.
 *
 * \param[in] config is a structure with the configuration parameters of the driver.
 *
 * \param[in] adr is the register address to read.
 *
 * \param[in,out] val is a pointer to store the read value from the given register.
 *
 * \return The status/error code.
 */
int sl_ttc2_read_reg(sl_ttc2_config_t *config, uint8_t adr, uint32_t *val);

/**
 * \brief Reads all the TTC variables and parameters.
 *
 * \param[in] config is a structure with the configuration parameters of the driver.
 *
 * \param[in,out] data is a pointer to store the read TTC data.
 *
 * \return The status/error code.
 */
int sl_ttc2_read_hk_data(sl_ttc2_config_t *config, sl_ttc2_hk_data_t *data);

/**
 * \brief Reads the device ID of the TTC module.
 *
 * \param[in] config is a structure with the configuration parameters of the driver.
 *
 * \param[in,out] val is a pointer to store the read device ID value.
 *
 * \return The status/error code.
 */
int sl_ttc2_read_device_id(sl_ttc2_config_t *config, uint16_t *val);

/**
 * \brief Reads the hardware version of the TTC 2.0 module.
 *
 * \param[in] config is a structure with the configuration parameters of the driver.
 *
 * \param[in,out] val is a pointer to store the read hardware version.
 *
 * \return The status/error code.
 */
int sl_ttc2_read_hardware_version(sl_ttc2_config_t *config, uint8_t *val);

/**
 * \brief Reads the firmware version of the TTC 2.0 module.
 *
 * \param[in] config is a structure with the configuration parameters of the driver.
 *
 * \param[in,out] val is a pointer to store the read firmware version.
 *
 * \return The status/error code.
 */
int sl_ttc2_read_firmware_version(sl_ttc2_config_t *config, uint32_t *val);

/**
 * \brief Reads the time counter value.
 *
 * \param[in] config is a structure with the configuration parameters of the driver.
 *
 * \param[in,out] val is a pointer to store the read time counter value.
 *
 * \return The status/error code.
 */
int sl_ttc2_read_time_counter(sl_ttc2_config_t *config, uint32_t *val);

/**
 * \brief Reads the reset counter value of the TTC module.
 *
 * \param[in] config is a structure with the configuration parameters of the driver.
 *
 * \param[in,out] val is a pointer to store the read reset counter value.
 *
 * \return The status/error code.
 */
int sl_ttc2_read_reset_counter(sl_ttc2_config_t *config, uint16_t *val);

/**
 * \brief Reads the last reset cause ID of the TTC.
 *
 * \param[in] config is a structure with the configuration parameters of the driver.
 *
 * \param[in,out] val is a pointer to store the read reset cause ID.
 *
 * \return The status/error code.
 */
int sl_ttc2_read_reset_cause(sl_ttc2_config_t *config, uint8_t *val);

/**
 * \brief Reads the input voltage of the TTC module.
 *
 * \param[in] config is a structure with the configuration parameters of the driver.
 *
 * \param[in] volt is the voltage type to read. It can be:
 * \parblock
 *      -\b SL_TTC2_VOLTAGE_MCU
 *      -\b SL_TTC2_VOLTAGE_RADIO
 *      .
 * \endparblock
 *
 * \param[in,out] val is a pointer to store the read voltage value.
 *
 * \note The unit of the read current is \b mV.
 *
 * \return The status/error code.
 */
int sl_ttc2_read_voltage(sl_ttc2_config_t *config, uint8_t volt, sl_ttc2_voltage_t *val);

/**
 * \brief Reads the input current of the TTC module.
 *
 * \param[in] config is a structure with the configuration parameters of the driver.
 *
 * \param[in] cur is current type to read. It can be:
 * \parblock
 *      -\b SL_TTC2_CURRENT_MCU
 *      -\b SL_TTC2_CURRENT_RADIO
 *      .
 * \endparblock
 *
 * \param[in,out] val is a pointer to store the read current.
 *
 * \note The unit of the read current is \b mA.
 *
 * \return The status/error code.
 */
int sl_ttc2_read_current(sl_ttc2_config_t *config, uint8_t cur, sl_ttc2_current_t *val);

/**
 * \brief Reads the temperature of  the TTC microncontroller.
 *
 * \param[in] config is a structure with the configuration parameters of the driver.
 *
 * \param[in] temp is the temperature type to read. It can be:
 * \parblock
 *      -\b SL_TTC2_TEMP_MCU
 *      -\b SL_TTC2_TEMP_RADIO
 *      -\b SL_TTC2_TEMP_ANTENNA
 *      .
 * \endparblock
 *
 * \param[in,out] val is a pointer to store the read temperature.
 *
 * \note The unit ot the read temperature is Kelvin.
 *
 * \return The status/error code.
 */
int sl_ttc2_read_temp(sl_ttc2_config_t *config, uint8_t temp, sl_ttc2_temp_t *val);

/**
 * \brief Reads the ID of the last valid telecommand received by the TTC module
 *
 * \param[in] config is a structure with the configuration parameters of the driver.
 *
 * \param[in,out] val is a pointer to store the read ID of the last valid telecommand.
 *
 * \return The status/error code.
 */
int sl_ttc2_read_last_valid_tc(sl_ttc2_config_t *config, uint8_t *val);

/**
 * \brief Reads the RSSI valur of the last valid telecommand of the TTC module.
 *
 * \param[in] config is a structure with the configuration parameters of the driver.
 *
 * \param[in,out] val is a pointer to store the read RSSI value.
 *
 * \return The status/error code.
 */
int sl_ttc2_read_rssi(sl_ttc2_config_t *config, sl_ttc2_rssi_t *val);

/**
 * \brief Reads the antenna status of the TTC module.
 *
 * \param[in] config is a structure with the configuration parameters of the driver.
 *
 * \param[in,out] val is a pointer to store the read antenna status value.
 *
 * \return The status/error code.
 */
int sl_ttc2_read_antenna_status(sl_ttc2_config_t *config, uint16_t *val);

/**
 * \brief Reads the antenna deployment status (executed or not executed).
 *
 * \param[in] config is a structure with the configuration parameters of the driver.
 *
 * \param[in,out] val is a pointer to store the read status value.
 *
 * \return The status/error code.
 */
int sl_ttc2_read_antenna_deployment_status(sl_ttc2_config_t *config, uint8_t *val);

/**
 * \brief Reads the antenna deployment hibernation status (executed or not executed).
 *
 * \param[in] config is a structure with the configuration parameters of the driver.
 *
 * \param[in,out] val is a pointer to store the read status value.
 *
 * \return The status/error code.
 */
int sl_ttc2_read_antenna_deployment_hibernation_status(sl_ttc2_config_t *config, uint8_t *val);

/**
 * \brief Reads the TX enable flag.
 *
 * \param[in] config is a structure with the configuration parameters of the driver.
 *
 * \param[in,out] val is a pointer to store the read TX enable flag.
 *
 * \return The status/error code.
 */
int sl_ttc2_read_tx_enable(sl_ttc2_config_t *config, uint8_t *val);

/**
 * \brief Sets the TX enable flag of the TTC.
 *
 * \param[in] config is a structure with the configuration parameters of the driver.
 *
 * \param[in] en is TRUE/FALSE to enable/disable the transmitter.
 *
 * \return The status/error code.
 */
int sl_ttc2_set_tx_enable(sl_ttc2_config_t *config, bool en);

/**
 * \brief Reads the packet counter value (transmitted or received).
 *
 * \param[in] config is a structure with the configuration parameters of the driver.
 *
 * \param[in] pkt is packet type counter to read. It can be:
 * \parblock
 *      -\b SL_TTC2_TX_PKT
 *      -\b SL_TTC2_RX_PKT
 *      .
 * \endparblock
 *
 * \param[in,out] val is a pointer to store the read packet counter value.
 *
 * \return The status/error code.
 */
int sl_ttc2_read_pkt_counter(sl_ttc2_config_t *config, uint8_t pkt, uint32_t *val);

/**
 * \brief Reads the number of packets available in a given FIFO (TX or RX).
 *
 * \param[in] config is a structure with the configuration parameters of the driver.
 *
 * \param[in] pkt is packet type FIFO to read. It can be:
 * \parblock
 *      -\b SL_TTC2_TX_PKT
 *      -\b SL_TTC2_RX_PKT
 *      .
 * \endparblock
 *
 * \param[in,out] val is a pointer to store the read value.
 *
 * \return The status/error code.
 */
int sl_ttc2_read_fifo_pkts(sl_ttc2_config_t *config, uint8_t pkt, uint8_t *val);

/**
 * \brief Reads the register with the number of bytes of the first available packet in the RX FIFO.
 *
 * \param[in] config is a structure with the configuration parameters of the driver.
 *
 * \param[in,out] val is a pointer to store the read value.
 *
 * \return The status/error code.
 */
int sl_ttc2_read_len_rx_pkt_in_fifo(sl_ttc2_config_t *config, uint16_t *val);

/**
 * \brief Verifies the number available RX packets to read.
 *
 * \param[in] config is a structure with the configuration parameters of the driver.
 *
 * \return The number of available packets to read (-1 on error).
 */
int sl_ttc2_check_pkt_avail(sl_ttc2_config_t *config);

/**
 * \brief Transmit packet command.
 *
 * \param[in] config is a structure with the configuration parameters of the driver.
 *
 * \param[in] data is the data to transmit.
 *
 * \param[in] len is the number of bytes to transmit.
 *
 * \return The status/error code.
 */
int sl_ttc2_transmit_packet(sl_ttc2_config_t *config, uint8_t *data, uint16_t len);

/**
 * \brief Reads a received packet.
 *
 * \param[in] config is a structure with the configuration parameters of the driver.
 *
 * \param[in,out] data is a pointer to store the read packet.
 *
 * \param[in,out] len is a pointer to store the length of the read packet (in bytes).
 *
 * \return The status/error code.
 */
int sl_ttc2_read_packet(sl_ttc2_config_t *config, uint8_t *data, uint16_t *len);

/**
 * \brief SPI interface initialization.
 *
 * \param[in] config is a structure with the configuration parameters of the driver.
 *
 * \return The status/error code.
 */
int sl_ttc2_spi_init(sl_ttc2_config_t *config);

/**
 * \brief Writes the device using the SPI interface.
 *
 * \param[in] config is a structure with the configuration parameters of the driver.
 *
 * \param[in] data is an array of bytes to write.
 *
 * \param[in] len is the number of bytes to write.
 *
 * \return The status/error code.
 */
int sl_ttc2_spi_write(sl_ttc2_config_t *config, uint8_t *data, uint16_t len);

/**
 * \brief Reads the device using the SPI interface.
 *
 * \param[in] config is a structure with the configuration parameters of the driver.
 *
 * \param[in] data is an array to store the read bytes.
 *
 * \param[in] len is the number of bytes to write.
 *
 * \return The status/error code.
 */
int sl_ttc2_spi_read(sl_ttc2_config_t *config, uint8_t *data, uint16_t len);

/**
 * \brief SPI transfer operation (write and/or read).
 *
 * \param[in] config is a structure with the configuration parameters of the driver.
 *
 * \param[in,out] wdata is a pointer to the data to be written during the SPI transfer.
 *
 * \param[in,out] rdata is a pointer to store the read data during the SPI transfer.
 *
 * \param[in] len is the number of bytes of the transfer operation.
 *
 * \return The status/error code.
 */
int sl_ttc2_spi_transfer(sl_ttc2_config_t *config, uint8_t *wdata, uint8_t *rdata, uint16_t len);

/**
 * \brief Milliseconds delay.
 *
 * \param[in] ms is the time to delay in milliseconds.
 *
 * \return None.
 */
void sl_ttc2_delay_ms(uint32_t ms);

/**
 * \brief Takes the sl_ttc2 mutex.
 *
 * \return The status/error code.
 */
int sl_ttc2_mutex_take(void);

/**
 * \brief Gives the sl_ttc2 mutex.
 *
 * \return The status/error code.
 */
int sl_ttc2_mutex_give(void);

#endif /* SL_TTC2_H_ */

/** \} End of sl_ttc2 group */
