spacelab-ufsc/obdh2/firmware/drivers/uart/uart.c

/*
 * uart.c
 * 
 * Copyright The OBDH 2.0 Contributors.
 * 
 * This file is part of OBDH 2.0.
 * 
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
 */

/**
 * \brief UART driver implementation.
 * 
 * \author Gabriel Mariano Marcelino <gabriel.mm8@gmail.com>
 * \author Miguel Boing <miguelboing13@gmail.com>
 *
 * \version 1.0.0
 * 
 * \date 2019/12/07
 * 
 * \addtogroup uart
 * \{
 */

#include <hal/usci_a_uart.h>
#include <hal/gpio.h>

#include <config/config.h>
#include <system/sys_log/sys_log.h>
#include <libs/containers/queue.h>

#include "uart.h"

static queue_t uart_port_0_rx_buffer;
static queue_t uart_port_1_rx_buffer;
static queue_t uart_port_2_rx_buffer;

/**
 * \brief Reads the MTU value of a given UART RX buffer.
 *
 * \param[in,out] uart_rx_buffer is the UART RX buffer to get the MTU size.
 *
 * \return The MTU of the given RX buffer.
 */
static uint16_t uart_read_mtu(queue_t *uart_rx_buffer);

/**
 * \brief Reads the RX ISR buffer.
 *
 * \param[in] port is the UART port to read. It can be:
 * \parblock
 *      -\b UART_PORT_0
 *      -\b UART_PORT_1
 *      -\b UART_PORT_2
 *      .
 * \endparblock
 *
 * \param[in] data is an array to store the read data.
 *
 * \param[in] len is the number of bytes to be read from the buffer.
 *
 * \return The status/error code.
 */
static int uart_read_isr_rx_buffer(uart_port_t port, uint8_t *data, uint16_t len);

int uart_init(uart_port_t port, uart_config_t config)
{
    int err = 0;

    USCI_A_UART_initParam uart_params = {0};

    switch(config.baudrate)
    {
        case 1200:
            uart_params.clockPrescalar      = 1665; /* 1200 bps @ 31.981568 MHz */
            uart_params.firstModReg         = 11;   /* 1200 bps @ 31.981568 MHz */
            uart_params.secondModReg        = 0;    /* 1200 bps @ 31.981568 MHz */
            break;
        case 2400:
            uart_params.clockPrescalar      = 832;  /* 2400 bps @ 31.981568 MHz */
            uart_params.firstModReg         = 14;   /* 2400 bps @ 31.981568 MHz */
            uart_params.secondModReg        = 0;    /* 2400 bps @ 31.981568 MHz */
            break;
        case 4800:
            uart_params.clockPrescalar      = 416;  /* 4800 bps @ 31.981568 MHz */
            uart_params.firstModReg         = 7;    /* 4800 bps @ 31.981568 MHz */
            uart_params.secondModReg        = 0;    /* 4800 bps @ 31.981568 MHz */
            break;
        case 9600:
            uart_params.clockPrescalar      = 208;  /* 9600 bps @ 31.981568 MHz */
            uart_params.firstModReg         = 3;    /* 9600 bps @ 31.981568 MHz */
            uart_params.secondModReg        = 0;    /* 9600 bps @ 31.981568 MHz */
            break;
        case 19200:
            uart_params.clockPrescalar      = 104;  /* 19200 bps @ 31.981568 MHz */
            uart_params.firstModReg         = 2;    /* 19200 bps @ 31.981568 MHz */
            uart_params.secondModReg        = 0;    /* 19200 bps @ 31.981568 MHz */
            break;
        case 38400:
            uart_params.clockPrescalar      = 52;   /* 38400 bps @ 31.981568 MHz */
            uart_params.firstModReg         = 1;    /* 38400 bps @ 31.981568 MHz */
            uart_params.secondModReg        = 0;    /* 38400 bps @ 31.981568 MHz */
            break;
        case 57600:
            uart_params.clockPrescalar      = 34;   /* 57600 bps @ 31.981568 MHz */
            uart_params.firstModReg         = 11;   /* 57600 bps @ 31.981568 MHz */
            uart_params.secondModReg        = 0;    /* 57600 bps @ 31.981568 MHz */
            break;
        case 115200:
            uart_params.clockPrescalar      = 17;   /* 115200 bps @ 31.981568 MHz */
            uart_params.firstModReg         = 6;    /* 115200 bps @ 31.981568 MHz */
            uart_params.secondModReg        = 0;    /* 115200 bps @ 31.981568 MHz */
            break;
        case 230400:
            uart_params.clockPrescalar      = 8;    /* 230400 bps @ 31.981568 MHz */
            uart_params.firstModReg         = 11;   /* 230400 bps @ 31.981568 MHz */
            uart_params.secondModReg        = 5;    /* 230400 bps @ 31.981568 MHz */
            break;
        case 460800:
            uart_params.clockPrescalar      = 4;    /* 460800 bps @ 31.981568 MHz */
            uart_params.firstModReg         = 3;    /* 460800 bps @ 31.981568 MHz */
            uart_params.secondModReg        = 5;    /* 460800 bps @ 31.981568 MHz */
            break;
        default:
        #if defined(CONFIG_DRIVERS_DEBUG_ENABLED) && (CONFIG_DRIVERS_DEBUG_ENABLED == 1)
            sys_log_print_event_from_module(SYS_LOG_ERROR, UART_MODULE_NAME, "Error during the initialization: Invalid baudrate!");
            sys_log_new_line();
        #endif /* CONFIG_DRIVERS_DEBUG_ENABLED */
            err = -1;       /* Invalid baudrate value */
            break;
    }

    uart_params.selectClockSource   = USCI_A_UART_CLOCKSOURCE_SMCLK;
    uart_params.parity              = config.parity;
    uart_params.msborLsbFirst       = USCI_A_UART_LSB_FIRST;
    uart_params.numberofStopBits    = config.stop_bits;
    uart_params.uartMode            = USCI_A_UART_MODE;
    uart_params.overSampling        = USCI_A_UART_OVERSAMPLING_BAUDRATE_GENERATION;

    uint16_t base_address;

    switch(port)
    {
        case UART_PORT_0:
            base_address = USCI_A0_BASE;

            GPIO_setAsPeripheralModuleFunctionInputPin(GPIO_PORT_P2, GPIO_PIN4 + GPIO_PIN5);

            queue_init(&uart_port_0_rx_buffer);

            break;
        case UART_PORT_1:
            base_address = USCI_A1_BASE;

            GPIO_setAsPeripheralModuleFunctionInputPin(GPIO_PORT_P8, GPIO_PIN2 + GPIO_PIN3);

            queue_init(&uart_port_1_rx_buffer);

            break;
        case UART_PORT_2:
            base_address = USCI_A2_BASE;

            GPIO_setAsPeripheralModuleFunctionInputPin(GPIO_PORT_P9, GPIO_PIN2 + GPIO_PIN3);

            queue_init(&uart_port_2_rx_buffer);

            break;
        default:
        #if defined(CONFIG_DRIVERS_DEBUG_ENABLED) && (CONFIG_DRIVERS_DEBUG_ENABLED == 1)
            sys_log_print_event_from_module(SYS_LOG_ERROR, UART_MODULE_NAME, "Error during the initialization: Invalid port!");
            sys_log_new_line();
        #endif /* CONFIG_DRIVERS_DEBUG_ENABLED */
            err = -1;       /* Invalid port */

            break;
    }

    if (USCI_A_UART_init(base_address, &uart_params) != STATUS_SUCCESS)
    {
    #if defined(CONFIG_DRIVERS_DEBUG_ENABLED) && (CONFIG_DRIVERS_DEBUG_ENABLED == 1)
        sys_log_print_event_from_module(SYS_LOG_ERROR, UART_MODULE_NAME, "Error during the initialization!");
        sys_log_new_line();
    #endif /* CONFIG_DRIVERS_DEBUG_ENABLED */
        err = -1;
    }

    USCI_A_UART_enable(base_address);

    return err;
}

int uart_write(uart_port_t port, uint8_t *data, uint16_t len)
{
    int err = 0;

    uint16_t base_address;

    switch(port)
    {
        case UART_PORT_0:   base_address = USCI_A0_BASE;    break;
        case UART_PORT_1:   base_address = USCI_A1_BASE;    break;
        case UART_PORT_2:   base_address = USCI_A2_BASE;    break;
        default:
        #if defined(CONFIG_DRIVERS_DEBUG_ENABLED) && (CONFIG_DRIVERS_DEBUG_ENABLED == 1)
            sys_log_print_event_from_module(SYS_LOG_ERROR, UART_MODULE_NAME, "Error during writing: Invalid port!");
            sys_log_new_line();
        #endif /* CONFIG_DRIVERS_DEBUG_ENABLED */
            err = -1;
            break;
    }

    if (err == 0)
    {
        uint16_t i = 0U;
        for(i = 0U; i < len; i++)
        {
            USCI_A_UART_transmitData(base_address, data[i]);
        }
    }

    return err;
}

int uart_read(uart_port_t port, uint8_t *data, uint16_t len)
{
    int err = 0;

    uint16_t base_address;

    switch(port)
    {
        case UART_PORT_0:   base_address = USCI_A0_BASE;    break;
        case UART_PORT_1:   base_address = USCI_A1_BASE;    break;
        case UART_PORT_2:   base_address = USCI_A2_BASE;    break;
        default:
        #if defined(CONFIG_DRIVERS_DEBUG_ENABLED) && (CONFIG_DRIVERS_DEBUG_ENABLED == 1)
            sys_log_print_event_from_module(SYS_LOG_ERROR, UART_MODULE_NAME, "Error during reading: Invalid port!");
            sys_log_new_line();
        #endif /* CONFIG_DRIVERS_DEBUG_ENABLED */
            err = -1;
            break;
    }

    if (err == 0)
    {
        err = uart_read_isr_rx_buffer(port, data, len);
    }

    return err;
}

int uart_rx_enable(uart_port_t port)
{
    int err = 0;

    uint16_t base_address;

    switch(port)
    {
        case UART_PORT_0:   base_address = USCI_A0_BASE;    break;
        case UART_PORT_1:   base_address = USCI_A1_BASE;    break;
        case UART_PORT_2:   base_address = USCI_A2_BASE;    break;
        default:
        #if defined(CONFIG_DRIVERS_DEBUG_ENABLED) && (CONFIG_DRIVERS_DEBUG_ENABLED == 1)
            sys_log_print_event_from_module(SYS_LOG_ERROR, UART_MODULE_NAME, "Error during enabling uart interruption: Invalid port!");
            sys_log_new_line();
        #endif /* CONFIG_DRIVERS_DEBUG_ENABLED */
            err = -1;   /*Invalid UART port */
            break;
    }

    if (err == 0)
    {
        USCI_A_UART_enableInterrupt(base_address, USCI_A_UART_RECEIVE_INTERRUPT);
    }

    return err;
}

int uart_rx_disable(uart_port_t port)
{
    int err = 0;

    uint16_t base_address;

    switch(port)
    {
        case UART_PORT_0:   base_address = USCI_A0_BASE;    break;
        case UART_PORT_1:   base_address = USCI_A1_BASE;    break;
        case UART_PORT_2:   base_address = USCI_A2_BASE;    break;
        default:
        #if defined(CONFIG_DRIVERS_DEBUG_ENABLED) && (CONFIG_DRIVERS_DEBUG_ENABLED == 1)
            sys_log_print_event_from_module(SYS_LOG_ERROR, UART_MODULE_NAME, "Error during disabling uart interruption: Invalid port!");
            sys_log_new_line();
        #endif /* CONFIG_DRIVERS_DEBUG_ENABLED */
            err = -1;   /*Invalid UART port */
            break;
    }

    if (err == 0)
    {
        USCI_A_UART_disableInterrupt(base_address, USCI_A_UART_RECEIVE_INTERRUPT);
    }

    return err;
}

int uart_read_isr_rx_buffer(uart_port_t port, uint8_t *data, uint16_t len)
{
    int err = 0;

    uint16_t num_bytes = len;

    uint16_t i = 0U;

    switch(port)
    {
        case UART_PORT_0:
            if (num_bytes > uart_read_mtu(&uart_port_0_rx_buffer))
            {
            #if defined(CONFIG_DRIVERS_DEBUG_ENABLED) && (CONFIG_DRIVERS_DEBUG_ENABLED == 1)
                sys_log_print_event_from_module(SYS_LOG_WARNING, UART_MODULE_NAME, "Port 0: Read size is bigger than RX buffer size!");
                sys_log_new_line();
            #endif /* CONFIG_DRIVERS_DEBUG_ENABLED */
                num_bytes = uart_read_mtu(&uart_port_0_rx_buffer);
            }

            for(i = 0U; i < num_bytes; i++)
            {
                data[i] = queue_pop_front(&uart_port_0_rx_buffer);
            }

            break;
        case UART_PORT_1:
            if (num_bytes > uart_read_mtu(&uart_port_1_rx_buffer))
            {
            #if defined(CONFIG_DRIVERS_DEBUG_ENABLED) && (CONFIG_DRIVERS_DEBUG_ENABLED == 1)
                sys_log_print_event_from_module(SYS_LOG_WARNING, UART_MODULE_NAME, "Port 1: Read size is bigger than RX buffer size!");
                sys_log_new_line();
            #endif /* CONFIG_DRIVERS_DEBUG_ENABLED */
                num_bytes = uart_read_mtu(&uart_port_1_rx_buffer);
            }

            for(i = 0U; i < num_bytes; i++)
            {
                data[i] = queue_pop_front(&uart_port_1_rx_buffer);
            }

            break;
        case UART_PORT_2:
            if (num_bytes > uart_read_mtu(&uart_port_2_rx_buffer))
            {
            #if defined(CONFIG_DRIVERS_DEBUG_ENABLED) && (CONFIG_DRIVERS_DEBUG_ENABLED == 1)
                sys_log_print_event_from_module(SYS_LOG_WARNING, UART_MODULE_NAME, "Port 2: Read size is bigger than RX buffer size!");
                sys_log_new_line();
            #endif /* CONFIG_DRIVERS_DEBUG_ENABLED */
                num_bytes = uart_read_mtu(&uart_port_2_rx_buffer);
            }

            for(i = 0U; i < num_bytes; i++)
            {
                data[i] = queue_pop_front(&uart_port_2_rx_buffer);
            }

            break;
        default:
        #if defined(CONFIG_DRIVERS_DEBUG_ENABLED) && (CONFIG_DRIVERS_DEBUG_ENABLED == 1)
            sys_log_print_event_from_module(SYS_LOG_ERROR, UART_MODULE_NAME, "Error during reading isr rx buffer: Invalid port!");
            sys_log_new_line();
        #endif /* CONFIG_DRIVERS_DEBUG_ENABLED */
            err = -1;
            break;
    }

    return err;
}

static uint16_t uart_read_mtu(queue_t *uart_rx_buffer)
{
    return queue_length(uart_rx_buffer);
}

uint16_t uart_read_available(uart_port_t port)
{
    uint16_t available_bytes = 0U;

    switch(port)
    {
        case UART_PORT_0:   available_bytes = queue_size(&uart_port_0_rx_buffer);  break;
        case UART_PORT_1:   available_bytes = queue_size(&uart_port_1_rx_buffer);  break;
        case UART_PORT_2:   available_bytes = queue_size(&uart_port_2_rx_buffer);  break;
        default:
        #if defined(CONFIG_DRIVERS_DEBUG_ENABLED) && (CONFIG_DRIVERS_DEBUG_ENABLED == 1)
            sys_log_print_event_from_module(SYS_LOG_ERROR, UART_MODULE_NAME, "Error during reading buffer available bytes: Invalid port!");
            sys_log_new_line();
        #endif /* CONFIG_DRIVERS_DEBUG_ENABLED */
            break;
    }

    return available_bytes;
}

int uart_flush(uart_port_t port)
{
    int err = 0;

    switch(port)
    {
        case UART_PORT_0:   queue_clear(&uart_port_0_rx_buffer);   break;
        case UART_PORT_1:   queue_clear(&uart_port_1_rx_buffer);   break;
        case UART_PORT_2:   queue_clear(&uart_port_2_rx_buffer);   break;
        default:
        #if defined(CONFIG_DRIVERS_DEBUG_ENABLED) && (CONFIG_DRIVERS_DEBUG_ENABLED == 1)
            sys_log_print_event_from_module(SYS_LOG_ERROR, UART_MODULE_NAME, "Error flushing the RX buffer: Invalid port!");
            sys_log_new_line();
        #endif /* CONFIG_DRIVERS_DEBUG_ENABLED */
            err = -1;
            break;
    }

    return err;
}

/* Interrupt Service Routines */

#pragma vector=USCI_A0_VECTOR
__interrupt void USCI_A0_ISR(void) // cppcheck-suppress misra-c2012-8.4
{
    if (USCI_A_UART_getInterruptStatus(USCI_A0_BASE, USCI_A_UART_RECEIVE_INTERRUPT_FLAG) == USCI_A_UART_RECEIVE_INTERRUPT_FLAG)
    {
        (void)queue_push_back(&uart_port_0_rx_buffer, USCI_A_UART_receiveData(USCI_A0_BASE));
        USCI_A_UART_clearInterrupt(USCI_A0_BASE, USCI_A_UART_RECEIVE_INTERRUPT_FLAG);
    }
}

#pragma vector=USCI_A1_VECTOR
__interrupt void USCI_A1_ISR(void) // cppcheck-suppress misra-c2012-8.4
{
    if (USCI_A_UART_getInterruptStatus(USCI_A1_BASE, USCI_A_UART_RECEIVE_INTERRUPT_FLAG) == USCI_A_UART_RECEIVE_INTERRUPT_FLAG)
    {
        (void)queue_push_back(&uart_port_1_rx_buffer, USCI_A_UART_receiveData(USCI_A1_BASE));
        USCI_A_UART_clearInterrupt(USCI_A1_BASE, USCI_A_UART_RECEIVE_INTERRUPT_FLAG);
    }
}

#pragma vector=USCI_A2_VECTOR
__interrupt void USCI_A2_ISR(void) // cppcheck-suppress misra-c2012-8.4
{
    if (USCI_A_UART_getInterruptStatus(USCI_A2_BASE, USCI_A_UART_RECEIVE_INTERRUPT_FLAG) == USCI_A_UART_RECEIVE_INTERRUPT_FLAG)
    {
        (void)queue_push_back(&uart_port_2_rx_buffer, USCI_A_UART_receiveData(USCI_A2_BASE));
        USCI_A_UART_clearInterrupt(USCI_A2_BASE, USCI_A_UART_RECEIVE_INTERRUPT_FLAG);
    }
}

/** \} End of uart group */
