spacelab-ufsc/obdh2/firmware/devices/payload/payload.c

/*
 * payload.c
 * 
 * Copyright The OBDH 2.0 Contributors.
 * 
 * This file is part of OBDH 2.0.
 * 
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
 */

/**
 * \brief Payload device implementation.
 * 
 * \author Gabriel Mariano Marcelino <gabriel.mm8@gmail.com>
 * \author João Cláudio Elsen Barcellos <joaoclaudiobarcellos@gmail.com>
 * \author Carlos Augusto Porto Freitas <carlos.portof@hotmail.com>
 * 
 * \version 1.0.0
 * 
 * \date 2021/08/15
 * 
 * \addtogroup payload
 * \{
 */

#include <config/config.h>
#include <system/system.h>
#include <system/sys_log/sys_log.h>

#include <drivers/gpio/gpio.h>
#include <drivers/edc/edc.h>
#include <drivers/phj/phj.h>
#include <drivers/px/px.h>

#include "payload.h"

#define PAYLOAD_UNIX_TO_J2000_EPOCH(x)      ((x) - 946684800UL)   /* Unix to J2000 epoch conversion */

static edc_config_t edc_0_conf;
static edc_config_t edc_1_conf;

static px_config_t px_conf;

int payload_init(payload_t pl)
{
    int err = -1;

    switch(pl)
    {
        case PAYLOAD_EDC_0:
        {
            edc_0_conf.interface = EDC_IF_UART;
            edc_0_conf.uart_port = UART_PORT_1;
            edc_0_conf.en_pin = GPIO_PIN_29;

            if (edc_init(edc_0_conf) == 0)
            {
                if (edc_set_rtc_time(edc_0_conf, PAYLOAD_UNIX_TO_J2000_EPOCH(system_get_time())) != 0)
                {
                    sys_log_print_event_from_module(SYS_LOG_ERROR, PAYLOAD_MODULE_NAME, "EDC 0: Error configuring the RTC time!");
                    sys_log_new_line();
                }

                edc_hk_t hk_data = {0};

                if (edc_get_hk(edc_0_conf, &hk_data) == 0)
                {
                    err = 0;

                    sys_log_print_event_from_module(SYS_LOG_INFO, PAYLOAD_MODULE_NAME, "EDC 0: Initialization done! (");
                    sys_log_print_int(hk_data.temp);
                    sys_log_print_msg(" oC, ");
                    sys_log_print_uint(hk_data.voltage_supply);
                    sys_log_print_msg(" mV, ");
                    sys_log_print_uint(hk_data.current_supply_d + hk_data.current_supply_a);
                    sys_log_print_msg(" mA)");
                    sys_log_new_line();
                }
                else
                {
                    sys_log_print_event_from_module(SYS_LOG_ERROR, PAYLOAD_MODULE_NAME, "EDC 0: Error reading the housekeeping data!");
                    sys_log_new_line();
                }

                if (edc_resume_ptt_task(edc_0_conf) != 0)
                {
                    sys_log_print_event_from_module(SYS_LOG_ERROR, PAYLOAD_MODULE_NAME, "EDC 0: Error starting PTT task!");
                    sys_log_new_line();
                }
            }
            else
            {
                sys_log_print_event_from_module(SYS_LOG_ERROR, PAYLOAD_MODULE_NAME, "EDC 0: Error during the initialization!");
                sys_log_new_line();
            }

            break;
        }
        case PAYLOAD_EDC_1:
        {
            edc_1_conf.interface = EDC_IF_UART;
            edc_1_conf.uart_port = UART_PORT_1;
            edc_1_conf.en_pin = GPIO_PIN_30;

            if (edc_init(edc_1_conf) == 0)
            {
                if (edc_set_rtc_time(edc_1_conf, PAYLOAD_UNIX_TO_J2000_EPOCH(system_get_time())) != 0)
                {
                    sys_log_print_event_from_module(SYS_LOG_ERROR, PAYLOAD_MODULE_NAME, "EDC 1: Error configuring the RTC time!");
                    sys_log_new_line();
                }

                edc_hk_t hk_data = {0};

                if (edc_get_hk(edc_1_conf, &hk_data) == 0)
                {
                    err = 0;

                    sys_log_print_event_from_module(SYS_LOG_INFO, PAYLOAD_MODULE_NAME, "EDC 1: Initialization done! (");
                    sys_log_print_int(hk_data.temp);
                    sys_log_print_msg(" oC, ");
                    sys_log_print_uint(hk_data.voltage_supply);
                    sys_log_print_msg(" mV, ");
                    sys_log_print_uint(hk_data.current_supply_d + hk_data.current_supply_a);
                    sys_log_print_msg(" mA)");
                    sys_log_new_line();
                }
                else
                {
                    sys_log_print_event_from_module(SYS_LOG_ERROR, PAYLOAD_MODULE_NAME, "EDC 1: Error reading the housekeeping data!");
                    sys_log_new_line();
                }

                if (edc_resume_ptt_task(edc_1_conf) != 0)
                {
                    sys_log_print_event_from_module(SYS_LOG_ERROR, PAYLOAD_MODULE_NAME, "EDC 1: Error starting PTT task!");
                    sys_log_new_line();
                }
            }
            else
            {
                sys_log_print_event_from_module(SYS_LOG_ERROR, PAYLOAD_MODULE_NAME, "EDC 1: Error during the initialization!");
                sys_log_new_line();
            }

            break;
        }
        case PAYLOAD_X:
        {
            px_conf.port = I2C_PORT_0;
            px_conf.bitrate = 400000UL;
            px_conf.en_pin = GPIO_PIN_37;

            if (px_init(&px_conf) == 0)
            {
                err = 0;

                sys_log_print_event_from_module(SYS_LOG_INFO, PAYLOAD_MODULE_NAME, "Payload-X: Initialization done!");
                sys_log_new_line();
            }
            else
            {
                sys_log_print_event_from_module(SYS_LOG_ERROR, PAYLOAD_MODULE_NAME, "Payload-X: Error initializing the I2C configuration!");
                sys_log_new_line();
            }

            break;
        }
        default:
            sys_log_print_event_from_module(SYS_LOG_ERROR, PAYLOAD_MODULE_NAME, "Invalid payload to initialize!");
            sys_log_new_line();

            break;
    }

    return err;
}

int payload_enable(payload_t pl)
{
    int err = -1;

    switch(pl)
    {
        case PAYLOAD_EDC_0:
            if (edc_enable(edc_0_conf) == 0)
            {
                err = 0;
            }
            else
            {
                sys_log_print_event_from_module(SYS_LOG_ERROR, PAYLOAD_MODULE_NAME, "EDC 0: Error enabling!");
                sys_log_new_line();
            }

            break;
        case PAYLOAD_EDC_1:
            if (edc_enable(edc_1_conf) == 0)
            {
                err = 0;
            }
            else
            {
                sys_log_print_event_from_module(SYS_LOG_ERROR, PAYLOAD_MODULE_NAME, "EDC 0: Error enabling!");
                sys_log_new_line();
            }

            break;
        case PAYLOAD_X:
            if (px_enable(&px_conf) == 0)
            {
                err = 0;
            }
            else
            {
                sys_log_print_event_from_module(SYS_LOG_ERROR, PAYLOAD_MODULE_NAME, "Payload X: Error enabling!");
                sys_log_new_line();
            }

            break;
        default:
            sys_log_print_event_from_module(SYS_LOG_ERROR, PAYLOAD_MODULE_NAME, "EDC: Invalid payload to enable!");
            sys_log_new_line();

            break;
    }

    return err;
}

int payload_disable(payload_t pl)
{
    int err = -1;

    switch(pl)
    {
        case PAYLOAD_EDC_0:
            if (edc_disable(edc_0_conf) == 0)
            {
                err = 0;
            }
            else
            {
                sys_log_print_event_from_module(SYS_LOG_ERROR, PAYLOAD_MODULE_NAME, "EDC 1: Error disabling!");
                sys_log_new_line();
            }

            break;
        case PAYLOAD_EDC_1:
            if (edc_disable(edc_1_conf) == 0)
            {
                err = 0;
            }
            else
            {
                sys_log_print_event_from_module(SYS_LOG_ERROR, PAYLOAD_MODULE_NAME, "EDC 1: Error disabling!");
                sys_log_new_line();
            }

            break;
        case PAYLOAD_X:
            if (px_disable(&px_conf) == 0)
            {
                err = 0;
            }
            else
            {
                sys_log_print_event_from_module(SYS_LOG_ERROR, PAYLOAD_MODULE_NAME, "Payload X: Error enabling!");
                sys_log_new_line();
            }

            break;
        default:
            sys_log_print_event_from_module(SYS_LOG_ERROR, PAYLOAD_MODULE_NAME, "Invalid payload to disable!");
            sys_log_new_line();

            break;
    }

    return err;
}

int payload_write_cmd(payload_t pl, payload_cmd_t cmd)
{
    int err = -1;

    switch(pl)
    {
        case PAYLOAD_EDC_0:
        {
            sys_log_print_event_from_module(SYS_LOG_INFO, PAYLOAD_MODULE_NAME, "EDC 0: ");
            sys_log_print_hex(cmd);
            sys_log_print_msg(" command received!");
            sys_log_new_line();

            const edc_cmd_t edc_cmd = {
                .id = cmd,
                .param = 0U,
            };

            switch (cmd) 
            {
                case EDC_CMD_PTT_RESUME:
                    if (edc_write_cmd(edc_0_conf, edc_cmd) == 0)
                    {
                        err = 0;
                    }
                    break;
                case EDC_CMD_PTT_PAUSE:
                    if (edc_write_cmd(edc_0_conf, edc_cmd) == 0)
                    {
                        err = 0;
                    }
                    break;
                case EDC_CMD_PTT_POP:
                    if (edc_write_cmd(edc_0_conf, edc_cmd) == 0)
                    {
                        err = 0;
                    }
                    break;
                default: 
                    sys_log_print_event_from_module(SYS_LOG_ERROR, PAYLOAD_MODULE_NAME, "EDC: Received command is not implemented yet!");
                    sys_log_new_line();
                    break;
            }

            break;
        }
        case PAYLOAD_EDC_1:
        {
            sys_log_print_event_from_module(SYS_LOG_INFO, PAYLOAD_MODULE_NAME, "EDC 1: ");
            sys_log_print_hex(cmd);
            sys_log_print_msg(" command received!");
            sys_log_new_line();

            const edc_cmd_t edc_cmd = {
                .id = cmd,
                .param = 0U,
            };

            switch (cmd) 
            {
                case EDC_CMD_PTT_RESUME:
                    if (edc_write_cmd(edc_1_conf, edc_cmd) == 0)
                    {
                        err = 0;
                    }
                    break;
                case EDC_CMD_PTT_PAUSE:
                    if (edc_write_cmd(edc_1_conf, edc_cmd) == 0)
                    {
                        err = 0;
                    }
                    break;
                case EDC_CMD_PTT_POP:
                    if (edc_write_cmd(edc_1_conf, edc_cmd) == 0)
                    {
                        err = 0;
                    }
                    break;
                default: 
                    sys_log_print_event_from_module(SYS_LOG_ERROR, PAYLOAD_MODULE_NAME, "EDC: Received command is not implemented yet!");
                    sys_log_new_line();
                    break;
            }

            break;
        }
        case PAYLOAD_X:
        {
            if (px_write(&px_conf, &cmd, 1U) == 0)
            {
                sys_log_print_event_from_module(SYS_LOG_INFO, PAYLOAD_MODULE_NAME, "Payload-X: ");
                sys_log_print_hex(cmd);
                sys_log_print_msg(" command send!");
                sys_log_new_line();
            }
            else
            {
                sys_log_print_event_from_module(SYS_LOG_ERROR, PAYLOAD_MODULE_NAME, "Payload-X: Error in sending through I2C bus");
                sys_log_new_line();
            }

            break;
        }
        default:
            sys_log_print_event_from_module(SYS_LOG_ERROR, PAYLOAD_MODULE_NAME, "Invalid payload to write command!");
            sys_log_new_line();

            break;
    }

    return err;
}

int payload_get_data(payload_t pl, payload_data_id_t id, uint8_t *data, int32_t *len)
{
    int err = -1;

    switch(pl)
    {
        case PAYLOAD_EDC_0:
        {
            switch(id)
            {
                case PAYLOAD_EDC_RAW_STATE:
                {
                    *len = edc_get_state_pkg(edc_0_conf, data);

                    if (*len < 0)
                    {
                        sys_log_print_event_from_module(SYS_LOG_ERROR, PAYLOAD_MODULE_NAME, "EDC 0: Error reading state!");
                        sys_log_new_line();
                    }
                    else
                    {
                        err = 0;
                    }

                    break;
                }
                case PAYLOAD_EDC_STATE:
                {
                    edc_state_t state = {0};

                    if (edc_get_state(edc_0_conf, &state) == 0)
                    {
                        uint8_t i = 0;
                        for(i = 0; i < sizeof(edc_state_t); i++)
                        {
                            data[i] = ((uint8_t*)&state)[i];
                        }

                        *len = sizeof(edc_state_t);

                        err = 0;
                    }
                    else
                    {
                        *len = 0U;

                        sys_log_print_event_from_module(SYS_LOG_ERROR, PAYLOAD_MODULE_NAME, "EDC 0: Error reading state!");
                        sys_log_new_line();
                    }

                    break;
                }
                case PAYLOAD_EDC_RAW_PTT:
                {
                    *len = edc_get_ptt_pkg(edc_0_conf, data);

                    if (*len < 0)
                    {
                        sys_log_print_event_from_module(SYS_LOG_ERROR, PAYLOAD_MODULE_NAME, "EDC 0: Error reading PTT package!");
                        sys_log_new_line();
                    }
                    else
                    {
                        if (edc_pop_ptt_pkg(edc_0_conf) != 0)
                        {
                            sys_log_print_event_from_module(SYS_LOG_ERROR, PAYLOAD_MODULE_NAME, "EDC 0: Error poping PTT package!");
                            sys_log_new_line();
                        }
                        else
                        {
                            err = 0;
                        }
                    }

                    break;
                }
                case PAYLOAD_EDC_PTT:
                {
                    edc_ptt_t ptt = {0};

                    if (edc_get_ptt(edc_0_conf, &ptt) == 0)
                    {
                        uint8_t i = 0;
                        for(i = 0; i < sizeof(edc_ptt_t); i++)
                        {
                            data[i] = ((uint8_t*)&ptt)[i];
                        }

                        *len = sizeof(edc_ptt_t);

                        if (edc_pop_ptt_pkg(edc_0_conf) != 0)
                        {
                            sys_log_print_event_from_module(SYS_LOG_ERROR, PAYLOAD_MODULE_NAME, "EDC 0: Error poping PTT package!");
                            sys_log_new_line();
                        }
                        else
                        {
                            err = 0;
                        }
                    }
                    else
                    {
                        *len = 0U;

                        sys_log_print_event_from_module(SYS_LOG_ERROR, PAYLOAD_MODULE_NAME, "EDC 0: Error reading PTT package!");
                        sys_log_new_line();
                    }

                    break;
                }
                case PAYLOAD_EDC_RAW_HK:
                {
                    *len = edc_get_hk_pkg(edc_0_conf, data);

                    if (*len < 0)
                    {
                        sys_log_print_event_from_module(SYS_LOG_ERROR, PAYLOAD_MODULE_NAME, "EDC 0: Error reading housekeeping data!");
                        sys_log_new_line();
                    }
                    else
                    {
                        err = 0;
                    }

                    break;
                }
                case PAYLOAD_EDC_HK:
                {
                    edc_hk_t hk = {0};

                    if (edc_get_hk(edc_0_conf, &hk) == 0)
                    {
                        uint8_t i = 0;
                        for(i = 0; i < sizeof(edc_hk_t); i++)
                        {
                            data[i] = ((uint8_t*)&hk)[i];
                        }

                        *len = sizeof(edc_hk_t);

                        err = 0;
                    }
                    else
                    {
                        *len = 0U;

                        sys_log_print_event_from_module(SYS_LOG_ERROR, PAYLOAD_MODULE_NAME, "EDC 0: Error reading housekeeping data!");
                        sys_log_new_line();
                    }

                    break;
                }
                default:
                    sys_log_print_event_from_module(SYS_LOG_ERROR, PAYLOAD_MODULE_NAME, "EDC 0: Invalid data ID!");
                    sys_log_new_line();

                    break;
            }

            break;
        }
        case PAYLOAD_EDC_1:
        {
            switch(id)
            {
                case PAYLOAD_EDC_RAW_STATE:
                {
                    *len = edc_get_state_pkg(edc_1_conf, data);

                    if (*len < 0)
                    {
                        sys_log_print_event_from_module(SYS_LOG_ERROR, PAYLOAD_MODULE_NAME, "EDC 1: Error reading state!");
                        sys_log_new_line();
                    }
                    else
                    {
                        err = 0;
                    }

                    break;
                }
                case PAYLOAD_EDC_STATE:
                {
                    edc_state_t state = {0};

                    if (edc_get_state(edc_1_conf, &state) == 0)
                    {
                        uint8_t i = 0;
                        for(i = 0; i < sizeof(edc_state_t); i++)
                        {
                            data[i] = ((uint8_t*)&state)[i];
                        }

                        *len = sizeof(edc_state_t);

                        err = 0;
                    }
                    else
                    {
                        *len = 0U;

                        sys_log_print_event_from_module(SYS_LOG_ERROR, PAYLOAD_MODULE_NAME, "EDC 1: Error reading state!");
                        sys_log_new_line();
                    }

                    break;
                }
                case PAYLOAD_EDC_RAW_PTT:
                {
                    *len = edc_get_ptt_pkg(edc_1_conf, data);

                    if (*len < 0)
                    {
                        sys_log_print_event_from_module(SYS_LOG_ERROR, PAYLOAD_MODULE_NAME, "EDC 1: Error reading PTT package!");
                        sys_log_new_line();
                    }
                    else
                    {
                        if (edc_pop_ptt_pkg(edc_1_conf) != 0)
                        {
                            sys_log_print_event_from_module(SYS_LOG_ERROR, PAYLOAD_MODULE_NAME, "EDC 1: Error poping PTT package!");
                            sys_log_new_line();
                        }
                        else
                        {
                            err = 0;
                        }
                    }

                    break;
                }
                case PAYLOAD_EDC_PTT:
                {
                    edc_ptt_t ptt_pkg = {0};

                    if (edc_get_ptt(edc_1_conf, &ptt_pkg) == 0)
                    {
                        uint8_t i = 0;
                        for(i = 0; i < sizeof(edc_ptt_t); i++)
                        {
                            data[i] = ((uint8_t*)&ptt_pkg)[i];
                        }

                        *len = sizeof(edc_ptt_t);

                        if (edc_pop_ptt_pkg(edc_1_conf) != 0)
                        {
                            sys_log_print_event_from_module(SYS_LOG_ERROR, PAYLOAD_MODULE_NAME, "EDC 1: Error poping PTT package!");
                            sys_log_new_line();
                        }
                        else
                        {
                            err = 0;
                        }
                    }
                    else
                    {
                        *len = 0U;

                        sys_log_print_event_from_module(SYS_LOG_ERROR, PAYLOAD_MODULE_NAME, "EDC 1: Error reading PTT package!");
                        sys_log_new_line();
                    }

                    break;
                }
                case PAYLOAD_EDC_RAW_HK:
                {
                    *len = edc_get_hk_pkg(edc_1_conf, data);

                    if (*len < 0)
                    {
                        sys_log_print_event_from_module(SYS_LOG_ERROR, PAYLOAD_MODULE_NAME, "EDC 1: Error reading housekeeping data!");
                        sys_log_new_line();
                    }
                    else
                    {
                        err = 0;
                    }

                    break;
                }
                case PAYLOAD_EDC_HK:
                {
                    edc_hk_t hk = {0};

                    if (edc_get_hk(edc_1_conf, &hk) == 0)
                    {
                        uint8_t i = 0;
                        for(i = 0; i < sizeof(edc_hk_t); i++)
                        {
                            data[i] = ((uint8_t*)&hk)[i];
                        }

                        *len = sizeof(edc_hk_t);

                        err = 0;
                    }
                    else
                    {
                        *len = 0U;

                        sys_log_print_event_from_module(SYS_LOG_ERROR, PAYLOAD_MODULE_NAME, "EDC 1: Error reading housekeeping data!");
                        sys_log_new_line();
                    }

                    break;
                }
                default:
                    sys_log_print_event_from_module(SYS_LOG_ERROR, PAYLOAD_MODULE_NAME, "EDC 1: Invalid data ID!");
                    sys_log_new_line();

                    break;
            }

            break;
        }
        case PAYLOAD_X:
            if (px_read(&px_conf, data, *len) == 0)
            {
                sys_log_print_event_from_module(SYS_LOG_INFO, PAYLOAD_MODULE_NAME, "Payload-X: ");
                /*
                uint8_t i = 0;
                for(i = 0; i < sizeof(data); i++)
                {
                    sys_log_print_msg(data[i]);
                }
                */
                sys_log_print_msg(" data received!");
                sys_log_new_line();
             }
             else
             {
                 sys_log_print_event_from_module(SYS_LOG_ERROR, PAYLOAD_MODULE_NAME, "Payload-X: Error in receiving data through I2C bus");
                 sys_log_new_line();
             }

            break;
        default:
            sys_log_print_event_from_module(SYS_LOG_ERROR, PAYLOAD_MODULE_NAME, "Invalid payload to get data!");
            sys_log_new_line();

            break;
    }

    return err;
}

int payload_init_gpio_enables(void)
{
    int err = 0;

    #if defined (CONFIG_MISSION_GOLDS_UFSC) && (CONFIG_MISSION_GOLDS_UFSC == 1)
    const gpio_config_t conf = { .mode = GPIO_MODE_OUTPUT };

    /* Initializes enable pins */
    (void)gpio_init(GPIO_PIN_29, conf); /* EDC 0 */
    (void)gpio_init(GPIO_PIN_30, conf); /* EDC 1 */
    (void)gpio_init(GPIO_PIN_37, conf); /* Payload X */

    /* Make sure payloads are disabled */
    (void)gpio_set_state(GPIO_PIN_29, false); /* EDC 0 */
    (void)gpio_set_state(GPIO_PIN_30, false); /* EDC 1 */
    (void)gpio_set_state(GPIO_PIN_37, false); /* Payload X */

    #endif

    return err;
}

int payload_set_clock(const payload_t pl, const uint32_t time)
{
    int err = 0;

    switch(pl)
    {
        case PAYLOAD_EDC_0:
            sys_log_print_event_from_module(SYS_LOG_INFO, PAYLOAD_MODULE_NAME, "EDC 0: Setting Clock/RTC time...");
            sys_log_new_line();

            if (edc_set_rtc_time(edc_0_conf, PAYLOAD_UNIX_TO_J2000_EPOCH(time)) != 0)
            {
                sys_log_print_event_from_module(SYS_LOG_ERROR, PAYLOAD_MODULE_NAME, "EDC 0: Error setting the Clock/RTC time!");
                sys_log_new_line();
                err = -1;
            }
            break;
        case PAYLOAD_EDC_1:
            sys_log_print_event_from_module(SYS_LOG_INFO, PAYLOAD_MODULE_NAME, "EDC 1: Setting Clock/RTC time...");
            sys_log_new_line();

            if (edc_set_rtc_time(edc_1_conf, PAYLOAD_UNIX_TO_J2000_EPOCH(time)) != 0)
            {
                sys_log_print_event_from_module(SYS_LOG_ERROR, PAYLOAD_MODULE_NAME, "EDC 1: Error setting the Clock/RTC time!");
                sys_log_new_line();
                err = -1;
            }
            break;
        case PAYLOAD_X:
            sys_log_print_event_from_module(SYS_LOG_ERROR, PAYLOAD_MODULE_NAME, "PX: set_clock() routine not implemented yet!");
            sys_log_new_line();
            err = -1;
            break;
        default:
            sys_log_print_event_from_module(SYS_LOG_ERROR, PAYLOAD_MODULE_NAME, "Invalid payload to set clock!");
            sys_log_new_line();
            err = -1;
            break;
    }

    return err;
}

/** \} End of payload group */
