spacelab-ufsc/obdh2/firmware/devices/ttc/ttc.c

/*
 * ttc.c
 * 
 * Copyright The OBDH 2.0 Contributors.
 * 
 * This file is part of OBDH 2.0.
 * 
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
 */

/**
 * \brief TTC device implementation.
 * 
 * \author Gabriel Mariano Marcelino <gabriel.mm8@gmail.com>
 * 
 * \version 1.0.0
 * 
 * \date 2020/02/01
 * 
 * \addtogroup ttc
 * \{
 */

#include <stdbool.h>

#include <config/config.h>
#include <system/sys_log/sys_log.h>
#include <drivers/spi/spi.h>

#include "ttc.h"

static ttc_config_t ttc_0_config;
static ttc_config_t ttc_1_config;

int ttc_init(ttc_e dev)
{
    static bool ttc_0_is_open = false;
    static bool ttc_1_is_open = false;

    int err = -2;

    ttc_config_t ttc_config = {0};

    switch(dev)
    {
        case TTC_0:
            if (ttc_0_is_open)
            {
                err = 0;    /* TTC 0 device already initialized */
            }
            else
            {
                ttc_0_config.port                   = SPI_PORT_0;
                ttc_0_config.cs_pin                 = SPI_CS_0;
                ttc_0_config.port_config.speed_hz   = CONFIG_SPI_PORT_0_SPEED_BPS;
                ttc_0_config.port_config.mode       = SPI_MODE_0;
                ttc_0_config.id                     = SL_TTC2_RADIO_0;

                ttc_config = ttc_0_config;
            }

            break;
        case TTC_1:
            if (ttc_1_is_open)
            {
                err = 0;    /* TTC 1 device already initialized */
            }
            else
            {
                ttc_1_config.port                   = SPI_PORT_0;
                ttc_1_config.cs_pin                 = SPI_CS_1;
                ttc_1_config.port_config.speed_hz   = CONFIG_SPI_PORT_0_SPEED_BPS;
                ttc_1_config.port_config.mode       = SPI_MODE_0;
                ttc_1_config.id                     = SL_TTC2_RADIO_1;

                ttc_config = ttc_1_config;
            }

            break;
        default:
            sys_log_print_event_from_module(SYS_LOG_ERROR, TTC_MODULE_NAME, "Error initializing the TTC device! Invalid device!");
            sys_log_new_line();

            err = -1;

            break;
    }

    if (err == -2)
    {
        sys_log_print_event_from_module(SYS_LOG_INFO, TTC_MODULE_NAME, "Initializing TTC device ");
        sys_log_print_uint(ttc_config.id);
        sys_log_print_msg("...");
        sys_log_new_line();

        if (sl_ttc2_init(&ttc_config) == 0)
        {
            uint8_t hw_ver = 0;

            if (sl_ttc2_read_hardware_version(&ttc_config, &hw_ver) == 0)
            {
                uint32_t fw_ver = 0;

                if (sl_ttc2_read_firmware_version(&ttc_config, &fw_ver) == 0)
                {
                    sys_log_print_event_from_module(SYS_LOG_INFO, TTC_MODULE_NAME, "SpaceLab TTC 2.0 detected! (hw=");
                    sys_log_print_uint(hw_ver);
                    sys_log_print_msg(", fw=");
                    sys_log_print_uint(fw_ver);
                    sys_log_print_msg(")");
                    sys_log_new_line();

                    switch(dev)
                    {
                        case TTC_0:     ttc_0_is_open = true;   break;
                        case TTC_1:     ttc_1_is_open = true;   break;
                        default:                                break;
                    }

                    err = 0;
                }
                else
                {
                    sys_log_print_event_from_module(SYS_LOG_ERROR, TTC_MODULE_NAME, "Error reading the firmware version of the TTC device ");
                    sys_log_print_uint(ttc_config.id);
                    sys_log_print_msg("!");
                    sys_log_new_line();

                    err = -1;
                }
            }
            else
            {
                sys_log_print_event_from_module(SYS_LOG_ERROR, TTC_MODULE_NAME, "Error reading the hardware version of the TTC device ");
                sys_log_print_uint(ttc_config.id);
                sys_log_print_msg("!");
                sys_log_new_line();

                err = -1;
            }
        }
        else
        {
            sys_log_print_event_from_module(SYS_LOG_ERROR, TTC_MODULE_NAME, "Error initializing the TTC device ");
            sys_log_print_uint(ttc_config.id);
            sys_log_print_msg("!");
            sys_log_new_line();

            err = -1;
        }
    }

    return err;
}

int ttc_set_param(ttc_e dev, ttc_param_id_t param, uint32_t val)
{
    int err = -1;

    switch(dev)
    {
        case TTC_0:     err = sl_ttc2_write_reg(&ttc_0_config, param, val);  break;
        case TTC_1:     err = sl_ttc2_write_reg(&ttc_1_config, param, val);  break;
        default:
            sys_log_print_event_from_module(SYS_LOG_ERROR, TTC_MODULE_NAME, "Error writing a parameter to the TTC device! Invalid device!");
            sys_log_new_line();

            break;
    }

    return err;
}

int ttc_get_param(ttc_e dev, ttc_param_id_t param, uint32_t *val)
{
    int err = -1;

    switch(dev)
    {
        case TTC_0:     err = sl_ttc2_read_reg(&ttc_0_config, param, val);   break;
        case TTC_1:     err = sl_ttc2_read_reg(&ttc_1_config, param, val);   break;
        default:
            sys_log_print_event_from_module(SYS_LOG_ERROR, TTC_MODULE_NAME, "Error reading a parameter from the TTC device! Invalid device!");
            sys_log_new_line();

            break;
    }

    return err;
}

int ttc_get_data(ttc_e dev, ttc_data_t *data)
{
    int err = -1;

    ttc_config_t ttc_config = {0};

    switch(dev)
    {
        case TTC_0:     ttc_config = ttc_0_config;  err = 0;    break;
        case TTC_1:     ttc_config = ttc_1_config;  err = 0;    break;
        default:
            sys_log_print_event_from_module(SYS_LOG_ERROR, TTC_MODULE_NAME, "Error initializing the TTC device! Invalid device!");
            sys_log_new_line();

            break;
    }

    if (err == 0)
    {
        if (sl_ttc2_check_device(&ttc_config) == 0)
        {
            if (sl_ttc2_read_hk_data(&ttc_config, data) != 0)
            {
                sys_log_print_event_from_module(SYS_LOG_ERROR, TTC_MODULE_NAME, "Error reading the data from the TTC device ");
                sys_log_print_uint(ttc_config.id);
                sys_log_print_msg("!");
                sys_log_new_line();

                err = -1;
            }
        }
        else
        {
            sys_log_print_event_from_module(SYS_LOG_ERROR, TTC_MODULE_NAME, "Error reading the data from the TTC device ");
            sys_log_print_uint(ttc_config.id);
            sys_log_print_msg("! No device detected!");
            sys_log_new_line();
        }
    }

    return err;
}

int ttc_send(ttc_e dev, uint8_t *data, uint16_t len)
{
    int err = -1;

    ttc_config_t ttc_config = {0};

    switch(dev)
    {
        case TTC_0:     ttc_config = ttc_0_config;  err = 0;    break;
        case TTC_1:     ttc_config = ttc_1_config;  err = 0;    break;
        default:
            sys_log_print_event_from_module(SYS_LOG_ERROR, TTC_MODULE_NAME, "Error initializing the TTC device! Invalid device!");
            sys_log_new_line();

            break;
    }

    if (err == 0)
    {
        if (sl_ttc2_check_device(&ttc_config) == 0)
        {
            if (sl_ttc2_transmit_packet(&ttc_config, data, len) != 0)
            {
                sys_log_print_event_from_module(SYS_LOG_ERROR, TTC_MODULE_NAME, "Error sending data to the TTC device ");
                sys_log_print_uint(ttc_config.id);
                sys_log_print_msg("!");
                sys_log_new_line();

                err = -1;
            }
        }
        else
        {
            sys_log_print_event_from_module(SYS_LOG_ERROR, TTC_MODULE_NAME, "Error sending data to the TTC device ");
            sys_log_print_uint(ttc_config.id);
            sys_log_print_msg("! No device detected!");
            sys_log_new_line();

            err = -1;
        }
    }

    return err;
}

int ttc_recv(ttc_e dev, uint8_t *data, uint16_t *len)
{
    int err = -1;

    ttc_config_t ttc_config = {0};

    switch(dev)
    {
        case TTC_0:     ttc_config = ttc_0_config;  err = 0;    break;
        case TTC_1:     ttc_config = ttc_1_config;  err = 0;    break;
        default:
            sys_log_print_event_from_module(SYS_LOG_ERROR, TTC_MODULE_NAME, "Error sending data! Invalid device!");
            sys_log_new_line();

            break;
    }

    if (err == 0)
    {
        if (ttc_avail(dev) > 0)
        {
            if (sl_ttc2_read_packet(&ttc_config, data, len) != 0)
            {
                err = -1;
            }
        }
        else
        {
            /* No packet to receive! */
            err = -1;
        }
    }

    return err;
}

int ttc_avail(ttc_e dev)
{
    int err = -1;

    ttc_config_t ttc_config = {0};

    switch(dev)
    {
        case TTC_0:     ttc_config = ttc_0_config;  err = 0;    break;
        case TTC_1:     ttc_config = ttc_1_config;  err = 0;    break;
        default:
            sys_log_print_event_from_module(SYS_LOG_ERROR, TTC_MODULE_NAME, "Error checking packet availability! Invalid device!");
            sys_log_new_line();

            break;
    }

    if (err == 0)
    {
        err = sl_ttc2_check_pkt_avail(&ttc_config);
    }

    return err;
}

int ttc_enter_hibernation(ttc_e dev)
{
    int err = -1;

    ttc_config_t ttc_config = {0};

    switch(dev)
    {
        case TTC_0:     ttc_config = ttc_0_config;  err = 0;    break;
        case TTC_1:     ttc_config = ttc_1_config;  err = 0;    break;
        default:
            sys_log_print_event_from_module(SYS_LOG_ERROR, TTC_MODULE_NAME, "Error enabling hibernation! Invalid device!");
            sys_log_new_line();

            break;
    }

    if (err == 0)
    {
        err = sl_ttc2_set_tx_enable(&ttc_config, false);
    }

    return err;
}

int ttc_leave_hibernation(ttc_e dev)
{
    int err = -1;

    ttc_config_t ttc_config = {0};

    switch(dev)
    {
        case TTC_0:     ttc_config = ttc_0_config;  err = 0;    break;
        case TTC_1:     ttc_config = ttc_1_config;  err = 0;    break;
        default:
            sys_log_print_event_from_module(SYS_LOG_ERROR, TTC_MODULE_NAME, "Error disabling hibernation! Invalid device!");
            sys_log_new_line();

            break;
    }

    if (err == 0)
    {
        err = sl_ttc2_set_tx_enable(&ttc_config, true);
    }

    return err;
}

int ttc_check_failed_pkts(ttc_e dev)
{
    int err = 0;

    uint32_t n_conseq_failed_packets;

    if (ttc_get_param(dev, SL_TTC2_REG_CONSEQ_FAILED_PACKETS, &n_conseq_failed_packets) == 0)
    {
        if (n_conseq_failed_packets >= TTC_MAX_FAILED_PACKETS)
        {
            /* Try to reset TTC */
            if (ttc_set_param(dev, SL_TTC2_REG_RESET_DEVICE, 0x01U) != 0)
            {
                sys_log_print_event_from_module(SYS_LOG_ERROR, TTC_MODULE_NAME, "Failed to reset TTC device after too many failed packets!");
                sys_log_new_line();
                err = -1;
            }
        }
    }
    else 
    {
        sys_log_print_event_from_module(SYS_LOG_ERROR, TTC_MODULE_NAME, "Failed to read number of failed packets from TTC device!");
        sys_log_new_line();
        err = -1;
    }

    return err;
}

/** \} End of ttc group */
