spacelab-ufsc/obdh2/firmware/drivers/i2c/i2c.c

/*
 * i2c.c
 * 
 * Copyright The OBDH 2.0 Contributors.
 * 
 * This file is part of OBDH 2.0.
 * 
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
 */

/**
 * \brief I2C driver implementation.
 * 
 * \author Gabriel Mariano Marcelino <gabriel.mm8@gmail.com>
 * 
 * \version 1.0.0
 * 
 * \date 2019/12/07
 * 
 * \addtogroup i2c
 * \{
 */

#include <hal/usci_b_i2c.h>
#include <hal/gpio.h>
#include <hal/ucs.h>

#include <config/config.h>
#include <system/sys_log/sys_log.h>

#include "i2c.h"

int i2c_init(i2c_port_t port, i2c_config_t config)
{
    int err = 0;

    switch(config.speed_hz)
    {
        case USCI_B_I2C_SET_DATA_RATE_100KBPS:      break;
        case USCI_B_I2C_SET_DATA_RATE_400KBPS:      break;
        default:
        #if defined(CONFIG_DRIVERS_DEBUG_ENABLED) && (CONFIG_DRIVERS_DEBUG_ENABLED == 1)
            sys_log_print_event_from_module(SYS_LOG_ERROR, I2C_MODULE_NAME, "Invalid transfer rate!");
            sys_log_new_line();
        #endif /* CONFIG_DRIVERS_DEBUG_ENABLED */
            err = -1;   /* Invalid transfer rate */
            break;
    }

    if (err == 0)
    {
        uint16_t base_address = UINT16_MAX;

        switch(port)
        {
            case I2C_PORT_0:
                base_address = USCI_B0_BASE;
                GPIO_setAsPeripheralModuleFunctionInputPin(GPIO_PORT_P2, GPIO_PIN1 + GPIO_PIN2);
                break;
            case I2C_PORT_1:
                base_address = USCI_B1_BASE;
                GPIO_setAsPeripheralModuleFunctionInputPin(GPIO_PORT_P8, GPIO_PIN5 + GPIO_PIN6);
                break;
            case I2C_PORT_2:
                base_address = USCI_B2_BASE;
                GPIO_setAsPeripheralModuleFunctionInputPin(GPIO_PORT_P9, GPIO_PIN5 + GPIO_PIN6);
                break;
            default:
            #if defined(CONFIG_DRIVERS_DEBUG_ENABLED) && (CONFIG_DRIVERS_DEBUG_ENABLED == 1)
                sys_log_print_event_from_module(SYS_LOG_ERROR, I2C_MODULE_NAME, "Invalid port!");
                sys_log_new_line();
            #endif /* CONFIG_DRIVERS_DEBUG_ENABLED */
                err = -1;   /* Invalid I2C port */
                break;
        }

        if (err == 0)
        {
            USCI_B_I2C_initMasterParam i2c_params;

            i2c_params.selectClockSource    = USCI_B_I2C_CLOCKSOURCE_SMCLK;
            i2c_params.i2cClk               = UCS_getSMCLK();
            i2c_params.dataRate             = config.speed_hz;

            USCI_B_I2C_initMaster(base_address, &i2c_params);

            USCI_B_I2C_disable(base_address);
        }
    }

    return err;
}

int i2c_write(i2c_port_t port, i2c_slave_adr_t adr, uint8_t *data, uint16_t len)
{
    int err = 0;

    /* Verifies if the slave address is lesser than 7-bits */
    if (adr <= 128U)
    {
        uint16_t base_address = UINT16_MAX;

        switch(port)
        {
            case I2C_PORT_0:    base_address = USCI_B0_BASE;    break;
            case I2C_PORT_1:    base_address = USCI_B1_BASE;    break;
            case I2C_PORT_2:    base_address = USCI_B2_BASE;    break;
            default:
            #if defined(CONFIG_DRIVERS_DEBUG_ENABLED) && (CONFIG_DRIVERS_DEBUG_ENABLED == 1)
                sys_log_print_event_from_module(SYS_LOG_ERROR, I2C_MODULE_NAME, "Invalid port during write!");
                sys_log_new_line();
            #endif /* CONFIG_DRIVERS_DEBUG_ENABLED */
                err = -1;   /* Invalid I2C port */
                break;
        }

        if (err == 0)
        {
            USCI_B_I2C_setSlaveAddress(base_address, adr);

            USCI_B_I2C_setMode(base_address, USCI_B_I2C_TRANSMIT_MODE);

            USCI_B_I2C_enable(base_address);

            if (len == 1U)  /* Single byte */
            {
                if (USCI_B_I2C_masterSendSingleByteWithTimeout(base_address, data[0], I2C_SLAVE_TIMEOUT) == STATUS_SUCCESS)
                {
                    /* Delay until transmission completes */
                    while(USCI_B_I2C_isBusBusy(base_address) > 0U)
                    {
                        ;
                    }
                }
                else
                {
                #if defined(CONFIG_DRIVERS_DEBUG_ENABLED) && (CONFIG_DRIVERS_DEBUG_ENABLED == 1)
                    sys_log_print_event_from_module(SYS_LOG_WARNING, I2C_MODULE_NAME, "Timeout reached during write!");
                    sys_log_new_line();
                #endif /* CONFIG_DRIVERS_DEBUG_ENABLED */
                    err = -1;   /* Timeout reached! */
                }
            }
            else            /* Multiple bytes */
            {
                /* Initiate start and send first character */
                if (USCI_B_I2C_masterSendMultiByteStartWithTimeout(base_address, data[0], I2C_SLAVE_TIMEOUT) == STATUS_SUCCESS)
                {
                    uint16_t i = 0;
                    for(i = 1; i < len; i++)
                    {
                        if (USCI_B_I2C_masterSendMultiByteNextWithTimeout(base_address, data[i], I2C_SLAVE_TIMEOUT) != STATUS_SUCCESS)
                        {
                        #if defined(CONFIG_DRIVERS_DEBUG_ENABLED) && (CONFIG_DRIVERS_DEBUG_ENABLED == 1)
                            sys_log_print_event_from_module(SYS_LOG_WARNING, I2C_MODULE_NAME, "Timeout reached during write!");
                            sys_log_new_line();
                        #endif /* CONFIG_DRIVERS_DEBUG_ENABLED */
                            err = -1;   /* Timeout reached! */
                            break;
                        }
                    }

                    if (err == 0)
                    {
                        /* Initiate stop only */
                        if (USCI_B_I2C_masterSendMultiByteStopWithTimeout(base_address, I2C_SLAVE_TIMEOUT) == STATUS_SUCCESS)
                        {
                            /* Delay until transmission completes */
                            while(USCI_B_I2C_isBusBusy(base_address) > 0U)
                            {
                                ;
                            }
                        }
                        else
                        {
                        #if defined(CONFIG_DRIVERS_DEBUG_ENABLED) && (CONFIG_DRIVERS_DEBUG_ENABLED == 1)
                            sys_log_print_event_from_module(SYS_LOG_WARNING, I2C_MODULE_NAME, "Timeout reached during write!");
                            sys_log_new_line();
                        #endif /* CONFIG_DRIVERS_DEBUG_ENABLED */
                            err = -1;   /* Timeout reached! */
                        }
                    }
                }
                else
                {
                #if defined(CONFIG_DRIVERS_DEBUG_ENABLED) && (CONFIG_DRIVERS_DEBUG_ENABLED == 1)
                    sys_log_print_event_from_module(SYS_LOG_WARNING, I2C_MODULE_NAME, "Timeout reached during write!");
                    sys_log_new_line();
                #endif /* CONFIG_DRIVERS_DEBUG_ENABLED */
                    err = -1;   /* Timeout reached! */
                }
            }

            USCI_B_I2C_disable(base_address);
        }
    }
    else
    {
    #if defined(CONFIG_DRIVERS_DEBUG_ENABLED) && (CONFIG_DRIVERS_DEBUG_ENABLED == 1)
        sys_log_print_event_from_module(SYS_LOG_ERROR, I2C_MODULE_NAME, "Invalid slave address during write (");
        sys_log_print_hex(adr);
        sys_log_print_msg(")!");
        sys_log_new_line();
    #endif /* CONFIG_DRIVERS_DEBUG_ENABLED */
        err = -1;   /* Invalid slave address */
    }

    return err;
}

int i2c_read(i2c_port_t port, i2c_slave_adr_t adr, uint8_t *data, uint16_t len)
{
    int err = 0;

    /* Verifies if the slave address is lesser than 7-bits */
    if (adr <= 128U)
    {
        uint16_t base_address = UINT16_MAX;

        switch(port)
        {
            case I2C_PORT_0:    base_address = USCI_B0_BASE;    break;
            case I2C_PORT_1:    base_address = USCI_B1_BASE;    break;
            case I2C_PORT_2:    base_address = USCI_B2_BASE;    break;
            default:
            #if defined(CONFIG_DRIVERS_DEBUG_ENABLED) && (CONFIG_DRIVERS_DEBUG_ENABLED == 1)
                sys_log_print_event_from_module(SYS_LOG_ERROR, I2C_MODULE_NAME, "Invalid port during read!");
                sys_log_new_line();
            #endif /* CONFIG_DRIVERS_DEBUG_ENABLED */
                err = -1;   /* Invalid I2C port */
                break;
        }

        if (err == 0)
        {
            USCI_B_I2C_setSlaveAddress(base_address, adr);

            USCI_B_I2C_setMode(base_address, USCI_B_I2C_RECEIVE_MODE);

            USCI_B_I2C_enable(base_address);

            uint16_t timeout = 0;

            /* Starts the transmission */
            HWREG8(base_address + OFS_UCBxCTL1) |= UCTXSTT;

            /* Wait Slave Address ACK */
            while((HWREG8(base_address + OFS_UCBxCTL1) & UCTXSTT) && (timeout < I2C_SLAVE_TIMEOUT))
            {
                timeout++;
            }

            uint16_t i = 0;
            for(i = 0; i < (len - 1U); i++)
            {
                /* Wait to receive data and shift data on buffer */
                while((!(HWREG8(base_address + OFS_UCBxIFG) & UCRXIFG)) && (timeout < I2C_SLAVE_TIMEOUT))
                {
                    timeout++;
                }

                /* Receive a byte and increment the pointer */
                data[i] = HWREG8(base_address + OFS_UCBxRXBUF);
            }

            /* Prepares to stop the transmission */
            HWREG8(base_address + OFS_UCBxCTL1) |= UCTXSTP;

            /* Wait to receive data and shift data on buffer */
            while((!(HWREG8(base_address + OFS_UCBxIFG) & UCRXIFG)) && (timeout < I2C_SLAVE_TIMEOUT))
            {
                timeout++;
            }

            /* Receive a byte and increment the pointer */
            data[i] = HWREG8(base_address + OFS_UCBxRXBUF);

            if (timeout > I2C_SLAVE_TIMEOUT)
            {
            #if defined(CONFIG_DRIVERS_DEBUG_ENABLED) && (CONFIG_DRIVERS_DEBUG_ENABLED == 1)
                sys_log_print_event_from_module(SYS_LOG_WARNING, I2C_MODULE_NAME, "Timeout reached during read!");
                sys_log_new_line();
            #endif /* CONFIG_DRIVERS_DEBUG_ENABLED */
                err = -1;   /* Timeout reached! */
            }
        }
    }
    else
    {
    #if defined(CONFIG_DRIVERS_DEBUG_ENABLED) && (CONFIG_DRIVERS_DEBUG_ENABLED == 1)
        sys_log_print_event_from_module(SYS_LOG_ERROR, I2C_MODULE_NAME, "Invalid slave address during read (");
        sys_log_print_hex(adr);
        sys_log_print_msg(")!");
        sys_log_new_line();
    #endif /* CONFIG_DRIVERS_DEBUG_ENABLED */
        err = -1;   /* Invalid slave address */
    }

    return err;
}

/** \} End of i2c group */
