spacelab-ufsc/obdh2/(commit log)

2019-10-26 firmware: Adding the DriverLib source files. closes #6
2019-10-27 firmware: Adding the directories "config", "drivers", "devices" and "app" #2
2019-10-30 hardware: Adding the Altium project files of the OBDH 1.0. closes #7
    [0_Architecture.SchDoc, 1_Interface.SchDoc, 2_Topology.SchDoc, 3_MCU_Main.SchDoc, 4_IMU.SchDoc, 5_Non_Volatile_Memory.SchDoc, 6_Magnetorquer_Drivers.SchDoc, 7_Current_Sensing.SchDoc]
2019-11-02 hardware: Adding the bill of materials from the OBDH 1.0 project #5
    [obdh_bill_of_materials.ods]
2019-11-02 hardware: Adding the schematics of the OBDH 1.0 project
2019-11-08 hardware: Initial OBDH 2.0 bill of materials list. closes #5
    [obdh2_bill_of_materials.csv, obdh_bill_of_materials.ods]
2019-11-13 doc: hardware: Adding the PC-104 connector initial pinout
2019-11-15 firmware: drivers: Importing the SI4463 driver from the OBDH 1.0 firmware. closes #16
2019-11-15 hardware: bill of materials: Adding the MT25QL01GBBB8ESF-0AAT flash memory IC
    [obdh2_bill_of_materials.csv]
2019-11-15 firmware: drivers: Initial structure of the MT25QL01GBBB driver #24
2019-11-24 firmware: drivers: si446x: Renaming the driver from "rf4463" to "si446x"
2019-11-24 firmware: drivers: Initial structure of the EDC driver #23
2019-12-01 hardware: Removing old Altium project and unnecessary files
    [0_Architecture.SchDoc, 1_Interface.SchDoc, 2_Topology.SchDoc, 3_MCU_Main.SchDoc, 4_IMU.SchDoc, 5_Non_Volatile_Memory.SchDoc, 6_Magnetorquer_Drivers.SchDoc, 7_Current_Sensing.SchDoc]
2019-12-01 hardware: Adding preliminary topology and renaming project. closes #13
    [OBDH_Eng_Model_2_ALT.PrjPcb]
2019-12-01 hardware: Adding folder structure, preliminary source files and libraries. #14
    [0_Architecture.SchDoc, 1_Interface.SchDoc, 2_Topology.SchDoc, 3_MCU_Main.SchDoc, 4_Current_Sensing.SchDoc, 5_Non_Volatile_Memory.SchDoc]
2019-12-01 hardware: Fix Microcontroller debug pins and components library assignments
    [1_Interface.SchDoc, 2_Topology.SchDoc, 3_MCU_Main.SchDoc, 4_Current_Sensing.SchDoc, 5_Non_Volatile_Memory.SchDoc]
2019-12-01 hardware: Update the schematics footer info
    [0_Architecture.SchDoc, 1_Interface.SchDoc, 2_Topology.SchDoc, 3_MCU_Main.SchDoc, 4_Current_Sensing.SchDoc, 5_Non_Volatile_Memory.SchDoc]
2019-12-01 hardware: Removing PCB components and tracks
2019-12-02 hardware: Fixing debug capacitor value and updating internal schematics organization. #14
    [1_Interface.SchDoc, 2_Topology.SchDoc, 3_MCU_Main.SchDoc, 4_Current_Sensing.SchDoc, 5_Non_Volatile_Memory.SchDoc, OBDH_Eng_Model_2_ALT.PrjPcb]
2019-12-03 firmware: devices: Importing the log routines from the OBDH 1.0. closes #15
2019-12-07 hardware: Adapting the microcontroller communication channels to the new interfaces
    [0_Architecture.SchDoc, 1_Interface.SchDoc, 2_Topology.SchDoc, 3_MCU_Main.SchDoc, 5_Non_Volatile_Memory.SchDoc, OBDH_Eng_Model_2_ALT.PrjPcb]
2019-12-07 doc: hardware: Adding the RS-485 interface to the PC104 connector
2019-12-07 doc: hardware: Defining the daughterboad interface connector and pinout #34 #35
2019-12-08 hardware: Updating topology and adding communication buffers preliminary structure
    [1_Interface.SchDoc, 2_Topology.SchDoc, 3_MCU_Main.SchDoc, 5_Non_Volatile_Memory.SchDoc, 6_Communication_Buffers.SchDoc, OBDH_Eng_Model_2_ALT.PrjPcb]
2019-12-09 hardware: Updating external interfaces. closes #14
    [1_Interface.SchDoc, 2_Topology.SchDoc, 3_MCU_Main.SchDoc, 4_Current_Sensing.SchDoc, 5_Non_Volatile_Memory.SchDoc, 6_Communication_Buffers.SchDoc]
2019-12-09 hardware: Adding the preliminary communication buffers design #31 #32
    [1_Interface.SchDoc, 3_MCU_Main.SchDoc, 6_Communication_Buffers.SchDoc]
2019-12-11 hardware: Updating communication buffers design. closes #31 #32
    [1_Interface.SchDoc, 3_MCU_Main.SchDoc, 4_Current_Sensing.SchDoc, 6_Communication_Buffers.SchDoc]
2019-12-11 hardware: Adding memory schematic symbol and footprint #30
2019-12-11 hardware: Adding preliminary non-volatile memory design
    [1_Interface.SchDoc, 3_MCU_Main.SchDoc, 5_Non_Volatile_Memory.SchDoc, 6_Communication_Buffers.SchDoc]
2019-12-12 firmware: drivers: Adding the initial structure of the SPI driver #41
2019-12-12 firmware: drivers: Adding the initial structure of the UART driver #43
2019-12-12 firmware: Adding the current dependencies to the main README file
2019-12-13 firmware: drivers: Adding the initial structure of the I2C driver #42
2019-12-14 hardware: Fix current sensing circuit and update power supply scheme. closes #45 #47
    [1_Interface.SchDoc, 2_Topology.SchDoc, 4_Current_Sensing.SchDoc, OBDH_Eng_Model_2_ALT.PrjPcb]
2019-12-14 hardware: Adding schematic sheet
2019-12-14 firmware: devices: logger: Fixing the "FIRMWARE_AUTHOR" variable name
2019-12-14 firmware: drivers: Updating the main header file of the drivers directory
2019-12-14 firmware: drivers: edc: Adding the implementation of the "write_cmd" function #23
2019-12-14 hardware: Adding the daughter board connector and signals #35
    [1_Interface.SchDoc, 2_Topology.SchDoc, 3_MCU_Main.SchDoc, 4_Current_Sensing.SchDoc, 5_Non_Volatile_Memory.SchDoc, OBDH_Eng_Model_2_ALT.PrjPcb]
2019-12-18 firmware: drivers: Fixing typedefs
    [i2c.h, spi.h, uart.h]
2019-12-18 firmware: drivers: si446x: Moving the configuration header file to the "config" folder #55
2019-12-20 firmware: devices: Initial structure of the radio device #56
2019-12-27 hardware: Preliminary labels and files structure improvement #48
    [1_Interface.SchDoc, 2_Topology.SchDoc, 3_MCU_Main.SchDoc, 4_Analog_Circuits.SchDoc, 4_Current_Sensing.SchDoc, 5_Non_Volatile_Memory.SchDoc, 6_Communication_Buffers.SchDoc, OBDH_Eng_Model_2_ALT.PrjPcb]
2019-12-28 hardware: Improving the schematic labels and adding preliminary frame documentation #48
    [1_Interface.SchDoc, 2_Topology.SchDoc, 3_MCU_Main.SchDoc, 4_Analog_Circuits.SchDoc, 5_Non_Volatile_Memory.SchDoc, 6_Communication_Buffers.SchDoc]
2019-12-28 hardware: Updating the frame documentation and adding test points #48 #49
    [1_Interface.SchDoc, 2_Topology.SchDoc, 3_MCU_Main.SchDoc, 4_Analog_Circuits.SchDoc, 5_Non_Volatile_Memory.SchDoc, 6_Communication_Buffers.SchDoc]
2019-12-28 hardware: Updating the schematic sheets
2019-12-29 hardware: Updating label names and defining test points #49. closes #35 #46 #48
    [1_Interface.SchDoc, 2_Topology.SchDoc, 3_MCU_Main.SchDoc, 4_Analog_Circuits.SchDoc, 5_Non_Volatile_Memory.SchDoc, 6_Communication_Buffers.SchDoc, OBDH_Eng_Model_2_ALT.PrjPcb]
2019-12-29 hardware: Adding additional interfaces to PC104. closes #34
    [1_Interface.SchDoc, 2_Topology.SchDoc, 3_MCU_Main.SchDoc]
2019-12-29 hardware: Updating test points and fixing memory signals #24. closes #49
    [1_Interface.SchDoc, 2_Topology.SchDoc, 3_MCU_Main.SchDoc, 4_Analog_Circuits.SchDoc, 5_Non_Volatile_Memory.SchDoc, 6_Communication_Buffers.SchDoc]
2019-12-30 hardware: Including more info to the schematic frames documentation #58
    [1_Interface.SchDoc, 2_Topology.SchDoc, 3_MCU_Main.SchDoc, 4_Analog_Circuits.SchDoc, 5_Non_Volatile_Memory.SchDoc, 6_Communication_Buffers.SchDoc]
2019-12-30 hardware: Fixing library footprint linking problems
    [0_Architecture.SchDoc, 1_Interface.SchDoc, 2_Topology.SchDoc, 3_MCU_Main.SchDoc, 4_Analog_Circuits.SchDoc, 5_Non_Volatile_Memory.SchDoc, 6_Communication_Buffers.SchDoc, OBDH_Eng_Model_2_ALT.PrjPcb]
2019-12-31 hardware: Fixing RS485 unconnected resistors and current sensor decoupling capacitors
    [1_Interface.SchDoc, 4_Analog_Circuits.SchDoc, 6_Communication_Buffers.SchDoc]
2019-12-31 hardware: Updating the schematics sheets
2020-01-06 hardware: Adding preliminary layout version
    [1_Interface.SchDoc, 3_MCU_Main.SchDoc, OBDH_Eng_Model_2_ALT.PrjPcb]
2020-01-07 hardware: Adding ESD protection and improving labels placement
    [1_Interface.SchDoc]
2020-01-07 hardware: layout: Improving power connections
2020-01-07 hardware: layout: Improving external connectors and PC104 labels. closes #60 #61
    [1_Interface.SchDoc]
2020-01-08 hardware: Improving GND connection in the JTAG Debug header
    [OBDH_Eng_Model_2_ALT.PrjPcb]
2020-01-10 firmware: drivers: uart: Initial implementation #43
2020-01-10 hardware: layout: Adding GND polygon pour over the board bottom and top layers #65
    [3_MCU_Main.SchDoc, OBDH_Eng_Model_2_ALT.PrjPcb]
2020-01-10 hardware: layout: Adding fiducials and changing the antenna debug header. closes #62
    [1_Interface.SchDoc]
2020-01-10 hardware: layout: Changing the antenna debug header position. closes #65
2020-01-11 firmware: drivers: si446x: Defining the part info value #55
2020-01-11 firmware: drivers: si446x: Updating the SPI interface implementation #55
2020-01-11 hardware: schematics: Adding credit for the hardware project contributors
    [0_Architecture.SchDoc, 1_Interface.SchDoc, OBDH_Eng_Model_2_ALT.PrjPcb]
2020-01-11 hardware: Adding preliminary output and fabrication files
    [0_Architecture.SchDoc, 1_Interface.SchDoc, 2_Topology.SchDoc, 3_MCU_Main.SchDoc, 4_Analog_Circuits.SchDoc, 5_Non_Volatile_Memory.SchDoc, 6_Communication_Buffers.SchDoc, OBDH_Eng_Model_2_ALT.PrjPcb]
2020-01-11 hardware: Adding preliminary daughter board size and shape
2020-01-11 hardware: Adding daughter board size and shape guidelines
2020-01-11 firmware: app: tasks: Adding the initial structure of the watchdog reset task #71
    [watchdog_reset.c, watchdog_reset.h]
2020-01-12 firmware: drivers: uart: Fixing typos in the initialization routine #43
    [uart.c]
2020-01-12 firmware: app: tasks: Adding the initial structure of the periodic system reset task #72
    [system_reset.c, system_reset.h]
2020-01-14 firmware: drivers: Adding the initial structure of the GPIO driver #73
2020-01-15 firmware: drivers: gpio: Adding the implementation #73
2020-01-15 firmware: drivers: gpio: Adding a function to toggle the GPIO state #73
2020-01-15 firmware: devices: Adding the initial implementation of the watchdog device #74
2020-01-16 firmware: drivers: Adding the initial structure of the TPS382x driver #75
2020-01-16 firmware: drivers: tps382x: Adding the implementation #75
2020-01-16 firmware: drivers: tps382x: Adding a brief description of the driver to the README file #75
2020-01-17 doc: hardware: Adding a description about the external watchdog timer
2020-01-17 doc: hardware: Adding figures of the 3D model of the PCB
2020-01-18 firmware: drivers: Adding a driver for the internal watchdog timer #76
2020-01-18 firmware: drivers: Including the WDT driver in the main header file #76
2020-01-18 firmware: devices: watchdog: Moving the internal watchdog control to a dedicated driver and controlling the TPS3823 IC from the device #74
2020-01-18 Adding an image of the PCB 3D model to the README file
2020-01-19 firmware: app: tasks: watchdog_reset: Adding the implementation of the watchdog reset task #71
    [watchdog_reset.c]
2020-01-19 firmware: app: tasks: Adding the watchdog reset task to the scheculer #71
    [tasks.c]
2020-01-19 firmware: app: tasks: startup: Adding the watchdog device initialization #33
2020-01-19 firmware: drivers: uart: Adding support for more baudrate values #43
2020-01-19 firmware: devices: logger: Using the UART driver to transmit the log messages
2020-01-19 firmware: app: tasks: startup: Adding the logger device initialization #33
2020-01-21 firmware: Temporarily excluding NGHam lib and si446x driver from build
2020-01-21 firmware: drivers: wdt: Fixing the definition of the WDT configuration parameters #76 #74
2020-01-21 firmware: Adding some missing includes #33 #71 #73
    [gpio.h, startup.c, tasks.c, watchdog_reset.c]
2020-01-23 firmware: app: tasks: heartbeat: Fixing the task function name #81
    [heartbeat.c, heartbeat.h]
2020-01-23 firmware: drivers: tps382x: Fixing the trigger function name #75
    [tps382x.c, tps382x.h]
2020-01-23 firmware: devices: watchdog: Passing the WDI pin to the trigger function of the tps382x driver #74
2020-01-23 firmware: app: Adding the implementation of the FreeRTOS hooks and the timer interrupt #8
2020-01-24 firmware: devices: Adding a device to control the system LEDs #83
2020-01-24 firmware: app: tasks: startup: Adding the LEDs device initialization #33
2020-01-25 firmware: devices: watchdog: Using ACLK as clock reference of the internal watchdog #74
2020-01-25 firmware: Moving the watchdog device initialization to the main function #33
2020-01-26 firmware: drivers: uart: Updating the SMCLK frequency to 32 MHz #43
2020-01-26 firmware: Moving the FreeRTOS hooks and timer setup to the "system" directory #2
2020-01-27 doc: system_overview: Adding a description about the system LEDs
2020-01-27 firmware: devices: logger: Minor fixes and updates
    [logger.h, logger_config.h, logger_mutex.c, logger_uart.c, main.c]
2020-01-28 firmware: drivers: uart: Initializing the UART port pins as peripheral pins #43
2020-01-28 firmware: devices: logger: Updating the splash screen
2020-01-29 firmware: Adding log messages to the leds device and startup task #33 #89 closes #97
2020-01-29 firmware: system: Adding the function "system_reset()" to force a system reset by software #72
    [system.c]
2020-01-29 firmware: app: tasks: Adding the implementation of the "System Reset" task #72
    [config.h, system_reset.c, system_reset.h, tasks.c, version.h]
2020-01-29 hardware: Enabling net colors cross reference
    [OBDH_Eng_Model_2_ALT.PrjPcb]
2020-01-29 hardware: schematics: Adding power diagram
    [0_Architecture.SchDoc, 2_Topology.SchDoc, 4_Analog_Circuits.SchDoc, 5_Non_Volatile_Memory.SchDoc, 6_Communication_Buffers.SchDoc]
2020-01-30 hardware: schematics: Updating architecture diagram
    [0_Architecture.SchDoc]
2020-01-30 firmware: app: tasks: Adding the "radio reset" task to the tasks creation routine #17 #99
    [config.h, tasks.c, version.h]
2020-01-30 firmware: devices: logger: Fixing the function "print_system_time"
    [version.h]
2020-01-30 hardware: Adding a filter to the Voltage Buffer Circuit
    [4_Analog_Circuits.SchDoc, OBDH_Eng_Model_2_ALT.PrjPcb]
2020-01-30 hardware: layout: Improving ground plane and elements clearance
2020-01-31 firmware: drivers: i2c: Adding the implementation of the initialization routine #42
2020-01-31 firmware: drivers: i2c: Adding the implementation of the transmission routine #42
2020-01-31 firmware: drivers: i2c: Using an UCS routine to get the SMCLK frequency #42
2020-01-31 firmware: drivers: i2c: Adding the implementation of the reception routine #42
2020-01-31 hardware: schematics: Fixing power and architecture diagrams directory path
    [0_Architecture.SchDoc, 2_Topology.SchDoc, OBDH_Eng_Model_2_ALT.PrjPcb]
2020-01-31 hardware: Updating schematic sheets
2020-01-31 hardware: Updating all fabrication outputs
    [OBDH_Eng_Model_2_ALT.PrjPcb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]
2020-02-01 firmware: drivers: spi: Adding the implementation of the initialization routine #41
2020-02-01 doc: hardware: Adding pictures of some interfaces of the board
2020-02-02 firmware: drivers: Initial structure of the TCA4311A driver #105
2020-02-02 firmware: drivers: tca4311a: Adding the implementation #105
2020-02-02 firmware: drivers: uart: Adding functions to verify and flush the RX buffer #43
2020-02-04 firmware: drivers: spi: Initializing the CS pins state as high #41
2020-02-04 firmware: drivers: spi: Adding the implementation of the transfer functions #41
2020-02-05 firmware: Fixing the source files license text
    [app.h, clocks.c, clocks.h, config.h, gpio.c, gpio.h, heartbeat.c, heartbeat.h]
2020-02-05 firmware: drivers: spi: Updating the implementation of the SPI access routines #55
2020-02-06 firmware: drivers: Initial structure of the EPS 2.0 driver #107
2020-02-07 firmware: drivers: sl_eps2: Adding the implementation of the communication functions #107
2020-02-07 firmware: drivers: sl_eps2: Adding functions to read the battery and solar panels voltages and currents #107
2020-02-08 firmware: devices: Initial structure of the EPS device #110
2020-02-08 firmware: devices: eps: Adding the implementation of the functions "init", "get_bat_voltage" and "get_bat_charge" #110
2020-02-08 firmware: app: tasks: startup: Adding the EPS device initialization to the startup sequence #33
2020-02-11 firmware: drivers: i2c: Using write/read functions with timeout #42
2020-02-11 firmware: devices: Adding the initial structure of the TTC device #111
2020-02-12 firmware: drivers: si446x: Disabling the log message routines and adding the definition of the SPI functions #55
2020-02-12 firmware: drivers: si446x: Updating the GPIO access routines #55
2020-02-12 firmware: drivers: si446x: Adding a delay function #55
2020-02-12 firmware: drivers: si446x: Fixing warnings during compilation and including the driver to the build process #55
    [version.h]
2020-02-12 firmware: drivers: si446x: Removing the "si446x_config.h" file #55
2020-02-13 firmware: devices: Adding the initial structure of the antenna device #114
2020-02-14 firmware: app tasks: startup: Adding the radio device initialization to the boot sequence #33
2020-02-15 firmware: Moving the SL EPS 2.0 driver configuration definition to the EPS device #107 #110
2020-02-15 firmware: app: tasks: startup: Using the fault LED in case of a critical error during the boot sequence #33
    [startup.c, version.h]
2020-02-16 firmware: drivers: edc: Adding the structure of the control and access routines #23
2020-02-17 firmware: drivers: edc: Adding the implementation of the commands #23
2020-02-18 firmware: drivers: i2c: Changing the communication interface to I2C #23
2020-02-18 firmware: drivers: edc: Adding the function "check_device" to test the connection #23
2020-02-18 firmware: devices: radio: Adding the implementation of the initialization function #56
2020-03-02 firmware: devices: Adding the initial structure of the payload EDC device #116
2020-03-02 firmware: app: tasks: startup: Adding the "payload_edc" device initialization to the startup sequence #33
2020-03-02 firmware: devices: payload_edc: Adding the implementation of the initialization routine #116
2020-03-03 doc: firmware: Adding the task "Read temperature"
2020-03-04 firmware: drivers: Initial structure of the ADC driver #120
2020-03-05 firmware: drivers: si446x: Adding a delay to the configuration loading routine #55
2020-03-06 firmware: drivers: i2c: Using the implementation of the OBDHv1 in the reception routine #42
2020-03-06 firmware: drivers: edc: Adding a delay between sequential I2C commands #23
2020-03-06 firmware: devices: payload_edc: Priting hk data during initialization and changing the I2C clock speed to 400 kHz #116
2020-03-06 hardware: Added new parameter to P3 connector FSI-110-03-X-D-AD to make the multi board assembly project with daughterboard (Name: "System" and Value: "Connector")
    [1_Interface.SchDoc]
2020-03-07 firmware: drivers: edc: Adding functions to get the board parameters #23
2020-03-07 firmware: devices: payload_edc: Adding the implementation of the main functions #116
2020-03-07 firmware: Temporally excluding the "isis_antenna" driver from building
2020-03-07 firmware: drivers: Importing the "isis_antenna" driver from the TTCv1 firmware. closes #22
2020-03-11 doc: Adding a exception to the output pdf file on .gitignore and adding the current pdf file output
2020-03-17 firmware: drivers: adc: Importing the implementation from the OBDHv1 firmware #120
2020-03-24 firmware: devices: Adding the initial structure of the "Temperature Sensor" device #126
2020-03-24 firmware: drivers: mt25ql01gbbb: Adding a initial list of the registers #24
2020-03-30 Adding the first version of the PHJ driver #128
2020-03-30 Adding the first version of the PHJ device #129
2020-03-31 firmware: drivers: Importing the internal memory driver from the TTC firmware. closes #130
2020-04-01 firmware: drivers: Initial structure of the Payload X driver #131
2020-04-05 firmware: devices: logger: Adding a function to print strings
2020-04-05 firmware: app: libs: libcsp-1.5.16: Replacing "printf" by the log messages routines #136
2020-04-07 firmware: app: libs: libcsp: interfaces: Adding the initial structure of the SPI interface #138
2020-04-09 firmware: drivers: i2c: Adding debug/log messages #139
2020-04-09 firmware: drivers: wdt: Adding debug/log messages #139
2020-04-09 firmware: drivers: uart: Adding debug/log messages #139
2020-04-10 hardware: layout: Adding the "open hardware" logo to the PCB. Closes #108
2020-04-10 firmware: drivers: spi: Adding debug/log messages #41 #139
2020-04-10 firmware: drivers: gpio: Adding debug/log messages #73 #139
2020-04-11 firmware: drivers: tca4311a: Adding debug/log messages #139
2020-04-12 firmware: drivers: si446x: Enabling the debug/log messages #139
2020-04-12 firmware: drivers: Changing the comments to the MISRA C:2004 style #115
2020-04-12 firmware: Moving the "logger" device to the "system" layer and renaming to "sys_log" #94
2020-04-12 firmware: Using "sys_log" routines to print debug/log messages. closes #94
2020-04-16 firmware: drivers: mt25ql01gbbb: fix typo in README
2020-04-17 firmware: devices: leds: Fixing the LEDs list
    [leds.h]
2020-04-17 firmware: drivers: edc: Adding debug/log messages #23 #139
2020-04-19 firmware: devices: radio: Adding the implementation #56
2020-04-19 firmware: drivers: si446x: Fixing the name of the function "wait_nirq" #55
2020-04-21 firmware: devices: Initial structure of the media device #149
2020-04-27 firmware: devices: media: Adding log messages #149
2020-04-27 firmware: devices: radio: Fixing the "send" function #56
    [version.h]
2020-04-28 hardware: schematics: Adding UART debug header
    [1_Interface.SchDoc]
2020-04-28 hardware: schematics: Fixing compilation error
    [0_Architecture.SchDoc]
2020-04-28 hardware: layout: Adding UART debug header
2020-04-29 hardware: schematics: Adding RS485 header and EDC UART to PC104
    [1_Interface.SchDoc, 2_Topology.SchDoc, 6_Communication_Buffers.SchDoc]
2020-04-29 hardware: layout: Updating EDC interfaces
    [OBDH_Eng_Model_2_ALT.PrjPcb]
2020-04-29 hardware: schematics: Updating EDC communication interface
    [1_Interface.SchDoc]
2020-04-30 hardware: schematics: Updating components parameters
    [1_Interface.SchDoc, 5_Non_Volatile_Memory.SchDoc, OBDH_Eng_Model_2_ALT.PrjPcb]
2020-04-30 hardware: version: Updating revision labels
    [0_Architecture.SchDoc, 1_Interface.SchDoc, 2_Topology.SchDoc, 3_MCU_Main.SchDoc, 4_Analog_Circuits.SchDoc, 5_Non_Volatile_Memory.SchDoc, 6_Communication_Buffers.SchDoc, OBDH_Eng_Model_2_ALT.PrjPcb]
2020-04-30 hardware: output_files: Updating all fabrication files and schematic sheets
    [OBDH_Eng_Model_2_ALT.PrjPcb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]
2020-04-30 doc: Updating the 3D images of the PCB. closes #153
2020-05-02 firmware: drivers: si446x: Moving the registers addresses and commands to the main header file and other minor improvements #55
2020-05-03 firmware: drivers: si446x: Adding a function to read the chip temperature #55
2020-05-03 firmware: system: sys_log: Adding functions to print signed integers and float numbers
2020-05-03 firmware: app: tasks: startup: Printing the last reset cause during the system boot #33
    [startup.c, system.c, system.h, version.h]
2020-05-05 firmware: drivers: si446x: Adding the functions "si446x_part_ingo" and "si446x_func_info" #55
2020-05-06 firmware: drivers: si446x: Adding a function to execute the command "get_adc_reading" #55
2020-05-07 firmware: drivers: mt25ql01gbbb: Adding registers masks #24
2020-05-08 firmware: drivers: si446x: Fixing the SPI routines #55
    [version.h]
2020-05-11 firmware: drivers: si446x: Refactoring #55
2020-05-12 firmware: devices: radio: Updating the initialization and send routines #56
2020-05-13 firmware: devices: radio: Updating the routines "radio_recv", "radio_available" and "radio_sleep" #56
2020-05-13 doc: Adding a chapter for the assembly instructions
2020-05-14 firmware: devices: radio: Verifying the radio ID during the initialization #56
2020-05-14 firmware: drivers: si446x: Adding functions to handle the GPIO pins #55
2020-07-09 firmware: devices: media: Adding the implementation to access the internal flash memory #149
2020-07-11 firmware: devices: Initial structure of the current sensor device #162
2020-07-11 firmware: devices: Initial structure of the voltage sensor device #163
2020-07-12 firmware: drivers: adc: Adding a flag to verify if the ADC driver is already initialized, and adding the daughterboard channels to the initialization routine #120
2020-07-12 firmware: devices: current_sensor: Current sensor device implementation #162
2020-07-12 firmware: app: tasks: startup: Adding the current sensor initialization #33
2020-07-13 firmware: devices: voltage_sensor: Adding the implementation #163
2020-07-13 firmware: app: tasks: startup: Adding the voltage sensor initialization #33
2020-07-13 firmware: devices: temp_sensor: Adding the implementation. closes #126
2020-07-13 firmware: app: tasks: startup: Adding the temperature sensor initialization #33
2020-07-13 firmware: app: tasks: Renaming the task "Read Temperature" to "Read Sensors" #167. closes #119
2020-07-14 bancada_obdh: firmware: app: tasks: read_sensors: Reading the uC temperature, current and voltages sensors #167
2020-07-20 firmware: drivers: Adding the initial structure of the SpaceLab EPS driver #168
2020-07-25 firmware: devices: antenna: Adding the data structure #114
2020-07-26 firmware: devices: antenna: Adding the ISIS antenna driver initialization to the initialization routine #114
2020-07-26 firmware: drivers: isis_antenna: Adapting the driver structure and the implementation #169
2020-07-26 firmware: Enabling the ISIS antenna driver building #169
2020-07-30 firmware: app: tasks: Adding the antenna device initialization to the startup task #33
2020-08-01 firmware: devices: media: Fixing the internal flash memory access #149
    [version.h]
2020-08-02 firmware: devices: antenna: Adding the implementation of the ISIS antenna initialization #114
2020-08-13 firmware: devices: antenna: Fixing the antenna status type #114
2020-08-16 firmware: app: tasks: Waiting N milliseconds to try again when a error occurs in the radio reception #147
    [version.h]
2020-08-16 firmware: devices: radio: Fixing compilation warnings #56
2020-08-16 firmware: drivers: si446x: Fixing compilation warnings #55
2020-08-19 hardware: layout: Updating PC104 parameters. closes #159
    [1_Interface.SchDoc]
2020-08-19 hardware: schematics: Adding new GPIO pins to PC104 #173
    [1_Interface.SchDoc, 3_MCU_Main.SchDoc]
2020-08-19 hardware: schematics: Updating the UART1 EDC payload interface #174
    [1_Interface.SchDoc]
2020-08-19 hardware: layout: Updating the UART1 interface routing and labels. closes #174
2020-08-19 hardware: schematics: Updating ADD_I2C1 interface position in the PC104
    [1_Interface.SchDoc]
2020-08-19 hardware: schematics: Adding pull-up resistor for the manual reset of the watchdog timer
    [4_Analog_Circuits.SchDoc]
2020-08-19 hardware: layout: Adding pull-up resistor for the watchdog timer
2020-08-20 hardware: layout: Adding thermal relief thermal relief in the ground connections. closes #59
    [OBDH_Eng_Model_2_ALT.PrjPcb]
2020-08-20 hardware: output_files: Updating the schematic sheets and fabrication files
    [PCB_OBDH_ALT.GBL, PCB_OBDH_ALT.GBO, PCB_OBDH_ALT.GBP, PCB_OBDH_ALT.GBS, PCB_OBDH_ALT.GKO, PCB_OBDH_ALT.GM1, PCB_OBDH_ALT.GTL, PCB_OBDH_ALT.GTO]
2020-08-22 doc: figures: Updating board 3d renders
2020-08-26 hardware: layout: Changing 3D render material colors
2020-08-26 hardware: Updating folder structure and file names #178
    [0_Architecture.SchDoc, 0_architecture.schdoc, 1_Interface.SchDoc, 1_interface.schdoc, 2_Topology.SchDoc, 2_topology.schdoc, 3_mcu_main.schdoc, 4_analog_circuits.schdoc]
2020-08-26 hardware: schematics: Updating template and adding layout elements in the sheets #178
    [0_architecture.schdoc, 1_interface.schdoc, 2_topology.schdoc, 3_mcu_main.schdoc, 4_analog_circuits.schdoc, 5_non_volatile_memory.schdoc, 6_communication_buffers.schdoc]
2020-08-26 hardware: libraries: Adding M3 holes and fiducials
2020-08-26 hardware: schematics: architecture: Adding M3 holes and updating fiducials
    [0_architecture.schdoc]
2020-08-26 hardware: layout: Updating M3 holes expansion size and improving fiducials footprint
2020-08-26 hardware: schematics: mcu: Adding versioning resistors and GPIOs
    [3_mcu_main.schdoc]
2020-08-26 hardware: layout: Adding versioning resistors and fixing labels
2020-08-26 hardware: layout: Adding board edge layer
2020-08-26 hardware: sources: Adding an output job file for the project
    [obdh2_project.prjpcb]
2020-08-26 hardware: outputs: Removing old output files
    [PCB_OBDH_ALT.GBL, PCB_OBDH_ALT.GBO, PCB_OBDH_ALT.GBP, PCB_OBDH_ALT.GBS, PCB_OBDH_ALT.GKO, PCB_OBDH_ALT.GM1, PCB_OBDH_ALT.GTL, PCB_OBDH_ALT.GTO]
2020-08-26 hardware: schematics: Updating hardware architecture diagram
    [0_architecture.schdoc]
2020-08-26 hardware: sources: Updating output job file configuration
    [obdh2_project.prjpcb]
2020-08-26 hardware: outputs: Adding all fabrication and documentation output files
    [board_bom.csv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]
2020-08-26 doc: figures: Updating the 3D images of the PCB
2020-08-26 hardware: sources: Updating outjob file for using the right BOM template
2020-08-27 hardware: Adding "ProducCode" parameter to project options
    [obdh2_project.prjpcb]
2020-08-27 hardware: outputs: board_bom: Adding right BOM excel spreadsheet and deleting csv file
    [board_bom.csv, board_bom.xlsx]
2020-08-27 hardware: outputs: board_schematics: Updating board full PDF file with the BOM
2020-08-29 firmware: app: tasks: startup: Printing the hardware version during the boot process #33 closes #184
2020-10-30 doc: figures: Updating PCB images size and adding PC-104 info
2020-10-30 doc: hardware: Adding antenna and programmer connectors description #190
2020-10-30 doc: figures: Updating connectors and daughterboard figures
2020-10-30 doc: hardware: Adding daughterboard connector description #190
2020-10-31 doc: figures: Adding devices circuit #190
2020-10-31 doc: hardware: Adding subsystem circuits and operation description #190
2020-10-31 doc: hardware: Adding the voltage and current measure circuits description #190
2020-11-02 doc: hardware: Adding the references of the FSI connector and the TPS3823 IC #194
2020-11-10 hardware: Updating project file general parameters
    [obdh2_project.prjpcb]
2020-11-10 hardware: outputs: board_draftsman: Adding first version of the draftsman document for the project
2020-11-21 doc: assembly: Adding small introduction, some information regarding DNP components on the Development Model section and extra interfaces on the Custom Configuration section #189
2020-11-22 hardware: outputs: board_bom: Manually fixing PC104 component quantity and adding missing partnumbers on pin headers close #186
    [board_bom.xlsx]
2020-11-22 hardware: sources: outjob: Fixing the BOM generation close #187
2020-11-22 hardware: sources/libraries: Manually adding missing partnumbers parameters for 4H, 6H and 7x2H pin headers
    [1_interface.schdoc]
2021-01-11 hardware: fabrication: Copying latest BOM
    [bom.xlsx]
2021-01-28 firmware: drivers: phj: Adding the license text, fixing the doxygen tags and adding a README file #128
    [phj.c, phj.h]
2021-02-13 devices: current_sensor: Adding a function to convert a raw reading to a real current #162
2021-02-13 firmware: tests: mockups: Adding the mockups of the ADC driver and the system log routines #208 #209
2021-02-13 firmware: tests: devices: Adding the unit test of the current sensor #208 closes #207
2021-02-13 firmware: devices: current_sensor: Changing the output of the read current function to integer and minor fixes according the unit tests. closes #162
    [current_sensor.c, current_sensor.h, version.h]
2021-02-13 firmware: tests: devices: Adding the unit test of the voltage sensor device. closes #210
2021-02-13 fimrware: devices: voltage_sensor: Adding a function to convert a raw reading to a real voltage and minor fixes according to the unit tests. closes #163
    [version.h, voltage_sensor.c, voltage_sensor.h]
2021-02-14 firmware: devices: temp_sensor: Adding a function to convert a raw reading to the real temperature and other minor improvements
2021-02-14 firmware: tests: mockups: Adding the wrap funcitons of the GPIO driver #209
2021-02-15 firmware: test: devices: Adding the unit test of the temperature sensor device. closes #212
2021-02-17 firmware: tests: devices: Adding the unit test of the leds device. closes #213
2021-02-17 firmware: devices: leds: Fixing warnings according to the unit test
    [gpio.h, leds.c, leds.h]
2021-02-20 firmware: tests: mockups: Adding the mockups of the tps382x and the wdt drivers #209
2021-02-20 firmware: tests: devices: Adding the unit test of the watchdog. closes #211
2021-02-20 firmware: drivers: wdt: Improving the wdt driver according to the unit test
2021-02-20 firmware: devices: watchdog: Improving the watchdog device according to the unit test
2021-02-20 firmware: drivers: isis_antenna: Adding a function to convert a raw to a real temperature and other minor improvements #169
2021-02-20 firmware: drivers: isis_antenna: Functions returning an status/error code #169
    [isis_antenna.c, isis_antenna.h, version.h]
2021-02-21 firmware: drivers: isis_antenna: Adding log messages. closes #169
2021-02-23 firmware: tests: devices: Initial structure of the unit test of the radio device #214
2021-03-16 firmware: tests: devices: Fixing the target "all" of the Makefile #208
2021-04-08 firmware: app: tasks: startup: Counting the number of errors during the boot proccess #33
    [startup.c, version.h]
2021-04-10 firmware: drivers: Adding a driver of the internal RTC (not working yet) #231
    [version.h]
2021-04-17 firmware: drivers: i2c: Fixing the pins initialization of the I2C port 1
    [i2c.c, version.h]
2021-04-18 firmware: devices: current_sensor: Fixing the conversion equation
    [adc.h, current_sensor.c, current_sensor.h, version.h, voltage_sensor.c]
2021-04-18 firmware: devices: leds: Defining the GPIO pins using macros
2021-04-18 firmware: drivers: mt25ql01gbbb: Adding the implementation of the SPI and GPIO access routines #24
2021-04-18 firmware: drivers: Renaming the mt25ql01gbbb driver to just "mt25q" #24
2021-04-19 firmware: drivers: spi: Fixing the initialization of port 0 and checking if the ports are initialized before trying to use them #41
    [spi.c, version.h]
2021-04-19 firmware: drivers: mt25q: Adding a function to read the device ID #24
2021-04-19 firmware: devices: voltage_sensor: Improving the implementation of the raw to mV conversion
2021-04-19 firmware: devices: media: Adding the NOR memory initialization #149
2021-04-19 firmware: app: tasks: read_sensors: Reading the converted current and voltage instead of raw values #167
2021-04-20 doc: Adding pictures of the test report of v0.5 board #239
2021-04-21 firmware: drivers: spi: Changing the default endianness to MSB #41
2021-04-21 firmware: drivers: mt25q: Fixing the initialization of the HOLD pin and the "read ID" function #24
    [mt25q.c, mt25q_gpio.c, version.h]
2021-04-21 firmware: drivers: spi: Fixing the SPI modes. closes #41
    [spi.c, version.h]
2021-04-21 firmware: drivers: spi: Fixing the SPI modes
    [spi.c, version.h]
2021-04-21 firmware: drivers: mt25q: Adding all registers and commands #24
2021-04-21 firmware: Minimal functions of the MT25Q driver, README file fixes and v0.6 release #24
    [mt25q.c, mt25q.h, version.h]
2021-04-22 doc: Adding a description of the tests to the test report of the v0.5 board #239
2021-04-23 doc: Adding an initial conclusion to the test report of the v0.5 board #239
2021-04-24 firmware: drivers: adc: Improving the implementation using DriverLib
2021-04-25 firmware: drivers: adc: Using the calibration data to read the internal temperature
2021-04-25 firmware: devices: temp_sensor: Adding functions to read the temperature in Kelvin and ADC driver updates
2021-04-25 firmware: tests: devices: Updating the tests
2021-04-27 firmware: tests: Updating the unit test of the temperature sensor device #209
2021-04-27 firmware: devices: temp_sensor: Fixing the range of the function to read the temperature in Celsius
    [temp_sensor.c, temp_sensor.h]
2021-04-28 firmware: tests: devices: Adding the radio test compilation to the Makefile #214
2021-04-29 firmware: tests: Minimum working version of the unit test of the radio device #209 #214
2021-04-29 firmware: drivers: spi: Adding the option to not use the CS pin during an operation
2021-04-29 firmware: drivers: mt25q: Adding SPI access functions without using the CS pin #24
2021-05-06 firmware: drivers: sl_eps2: Updating the varibles list #107
2021-05-06 firmware: drivers: sl_eps2: Adding a checksum (CRC8-CCITT) to the read/write operations #107
2021-05-07 firmware: drivers: sl_eps2: Adding the implementation of functions to access some parameters #107
2021-05-08 app: libs: libcsp-1.5.16: Fixing incompatible names in the I2C driver
2021-05-08 firmware: drivers: sl_eps2: Adding functions to read some EPS variables #107
2021-05-11 firmware: drivers: sl_eps2: Adding functions to read some EPS variables. closes #107
2021-05-12 firmware: drivers: Initial structure of the TTC 2.0 driver #249
2021-05-13 firmware: drivers: sl_ttc2: Initial structure of the TTC 2.0 driver #249
2021-05-13 firmware: drivers: sl_ttc2: Implementation of the functions to read the variables and parameters #249
2021-05-13 firmware: drivers: sl_ttc2: Changing the checksum algorithm to CRC16-CCITT #249
2021-05-14 firmware: drivers: sl_ttc2: Adding the commands to transmit/receive packets #249
2021-05-14 firmware: devices: ttc: Initial structure of the device #111
2021-05-15 firmware: drivers: sl_ttc2: Updating the implementation of the "check device" function #249
2021-05-15 firmware: devices: ttc: Implementation of the device #111
2021-05-15 firmware: drivers: sl_ttc2: Fixing the function "check device" and adding delays in the "read HK data" #249
    [sl_ttc2.c, version.h]
2021-05-15 firmware: devices: ttc: Adding the capability of handling multiple devices #111
2021-05-15 firmware: drivers: sl_eps2: Adding delays in the "read data" function
2021-05-15 firmware: devices: radio: Detecting timeout in function "send" and fixing GCC warnings #56
    [version.h]
2021-05-16 firmware: drivers: mt25q: Writing and reading operations working #24
2021-05-16 firmware: devices: media: Adding the implementation of the functions to access the NOR memory #149
2021-05-16 firmware: drivers: spi: Defining the function to select the slaves as "public"
2021-05-17 firmware: drivers: edc: Fixing debug messages #23
    [edc.c]
2021-05-17 firmware: sys_log: Printing the datetime compilation during the boot. closes #254
2021-05-18 firmware: drivers: mt25q: Fixing the function "get_flash_description" and "erase" #24
    [mt25q.c, mt25q.h, version.h]
2021-05-18 firmware: devices: media: Fixing the function "get_info" #149
2021-05-18 firmware: Increase the speed of the SPI port 0 to 1MHz #24 #55
2021-05-19 firmware: drivers: mt25q: Adding the implementation of all erase commands #24
2021-05-19 firmware: devices: media: Updating the implementation of the erase operation #149
2021-05-24 firmware: drivers: mt25q: Fixing the program operation in 4-byte address mode. closes #24
    [mt25q.c, version.h]
2021-05-26 firmware: Adding flags to enable/disable the initialization of the devices. closes #257
2021-05-29 doc: Updating the clock of the SPI interface
2021-06-03 hardware: schematics: Updating template and missing partnumbers #223 #224 #229
    [0_architecture.schdoc, 1_interface.schdoc, 2_topology.schdoc, 3_mcu_main.schdoc, 4_analog_circuits.schdoc, 5_non_volatile_memory.schdoc, 6_communication_buffers.schdoc, obdh2_project.prjpcb]
2021-06-03 hardware: schematics: Improving LEDs brightness and partnumbers #233 #237 #238
    [3_mcu_main.schdoc, 4_analog_circuits.schdoc]
2021-06-03 hardware: schematics: Adding FRAM memory #259
    [2_topology.schdoc, 3_mcu_main.schdoc, 5_non_volatile_memory.schdoc]
2021-06-03 hardware: layout: Adding FRAM memory and minor improvements #259
    [5_non_volatile_memory.schdoc]
2021-06-04 hardware: outputs: Updating fabrication files
    [board_gerber.GBL, board_gerber.GBO, board_gerber.GBP, board_gerber.GBS, board_gerber.GKO, board_gerber.GM1, board_gerber.GTL, board_gerber.GTO]
2021-06-04 hardware: sources: Adding details of v0.7 to revision history table on architecture sheet and updating project information and template on draftsman document #228
    [0_architecture.schdoc]
2021-06-04 hardware: sources: Fixing board silkcreen version, adding test point to RTCCLK pin #258 close #228
    [3_mcu_main.schdoc]
2021-06-04 hardware: sources: Updating PC104 label (previously was U16), minor fix to RTCCLK test point label and repositioning stack up table now in metric dimensions #258
    [1_interface.schdoc]
2021-06-04 hardware: libraries: Fixing some component IDs, descriptions and footprints #258
2021-06-04 hardware: sources: Updating components with new parameters in schematics and layout #258
    [1_interface.schdoc, 3_mcu_main.schdoc, 4_analog_circuits.schdoc, 5_non_volatile_memory.schdoc, 6_communication_buffers.schdoc]
2021-06-04 hardware: sources: Updating solder mask color to green, updating draftsman source and outjob file #258
2021-06-04 hardware: prjpcb: Disabling rooms during ECO generation and updating revision parameter to 0.7 #258
    [obdh2_project.prjpcb]
2021-06-08 hardware: outputs: board_schematics: Updating schematics of v0.7 release
2021-06-08 hardware: outputs: board_bom: Updating BOM of v0.7 release
    [board_bom.xlsx]
2021-06-08 hardware: prjpcb: Updating project file without camstatic v0.5
    [obdh2_project.prjpcb]
2021-06-08 hardware: fabrication: Updating gerber and nc drills zip and pick place file, adding BOM #258
    [board_bom.xlsx]
2021-06-08 hardware: outputs: Updating all output files for release v0.7 #258
    [board_bom.xlsx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]
2021-06-09 doc: Updating the main 3D image of the PCB and release v0.7 #258 #263
2021-06-09 doc: Updating the top and bottom pictures of the PCB #263
2021-06-10 firmware: devices: media: Adding the minimal structure to access the FRAM memory #149
2021-06-10 firmware: drivers: Initial structure of the CY15x102QN driver #260
2021-06-13 firmware: drivers: cy15x102qn: Implementation of the driver #260
2021-06-14 firmware: drivers: cy15x102qn: Adding a configuration structure as function parameter. closes #260
2021-06-14 firmware: devices: media: Adding the initialization routine of the FRAM memory #149
2021-06-30 firmware: devices: media: Adding the implementation of the write/read routines to access the FRAM memory #149
2021-08-06 firmware: tests: Adding the inital structure of the unit test of the ttc device #269
2021-08-06 firmware: tests: Adding the initial structure of the unit test of the eps device #270
2021-08-08 firmware: tests: Adding the initial structure of the unit test of the antenna device #215
2021-08-08 firmware: tests: Adding the initial structure of the unit test of the media device #209 #271
2021-08-09 firmware: tests: mockups: Adding the implementation of the ISIS antenna mockup #209
2021-08-09 firmware: tests: devices: Adding the implementation of the antenna device initialization test #215
2021-08-09 firmware: tests: devices: antenna: Improving the initialization test #215
2021-08-14 firmware: tests: Improving the ADC mockup
2021-08-14 firmware: tests: devices: Improving the Makefile
2021-08-15 firmware: mockups: Adding mockups of the current, voltage and temperature sensor devices #209
2021-08-15 firmware: mockups: Adding mockups of the EPS, TTC and LEDs devices #209
2021-08-15 firmware: tests: mockups: Adding mockups of the Watchdog, radio and media devices #209
2021-08-16 firmware: devices: Initial structure of the generic payload device #272
2021-08-16 firmware: devices: payload: Moving the dedicated EDC device to the generic payload device #116 #272
2021-08-16 firmware: tests: mockups: Adding a mockup of the antenna device #209
2021-08-16 firmware: tests: mockups: Adding a mockup of the payload device #209 #273
2021-08-17 firmware: Minor fixes #23 #56
    [edc.c, edc.h]
2021-08-17 firmware: tests: mockups: Adding a mockup of the EDC driver #209
2021-08-17 firmware: tests: devices: Initial unit test of the payload device #273
2021-08-18 firmware: devices: Fixing the payload device implementation and removing the EDC device #272 closes #116
    [payload.c, startup.c, version.h]
2021-08-18 firmware: devices: Moving the payload PHJ device to the generic payload device #272 closes #129
2021-08-18 firmware: drivers: phj: Fixing the implementation #128
    [phj.c, phj.h]
2021-08-18 firmware: tests: mockups: Initial mockup of the PHJ driver #209
2021-08-18 firmware: tests: devices: Adding the payload PHJ initialization to the test routine #273
2021-08-20 firmware: tests: mockups: Fixing the implementation of the MT25Q mockup #209
    [mt25q_wrap.c]
2021-08-20 firmware: tests: devices: media: Adding the implementation of the NOR memory test #271
2021-08-22 firmware: tests: devices: Implementation of the EPS unit test #270
2021-08-22 firmware: tests: mockups: Adding the implementation of the CY15x102QN driver mockup #209
2021-08-22 firmware: tests: devices: Adding the implementation of the FRAM memory test #271
2021-08-22 firmware: devices: media: Fixing the routines to access the FRAM memory #149
    [version.h]
2021-08-25 firmware: tests: mockups: Improving the mockup of the ADC driver #209
2021-08-25 firmware: tests: mockups: Adding a mockup of the I2C driver #209
2021-08-25 firmware: tests: mockups: Adding a mockup of the SPI driver #209
2021-08-25 firmware: tests: mockups: Adding a mockup of the UART driver #209
2021-08-28 firmware: tests: Improving the WDT driver mockup #209
2021-08-29 firmware: tests: mockups: drivers: Adding the implementation of the si446x mockup #209
2021-08-29 firmware: tests: mockups: Improving the implementation of the ISIS Antenna, TPS382x and System Log mockups #209
2021-08-29 firmware: tests: devices: Adding a script to execute all tests
2021-08-29 firmware: tests: devices: Updating the test of the radio device. closes #214
2021-08-29 firmware: devices: radio: Fixing the initialization routine #56
    [version.h]
2021-08-29 firmware: tests: Initial structure of the unit test of the CY15x102QN driver #276
2021-08-30 firmware: tests: drivers: Implementation of the unit test of the CY15x102QN driver #276
2021-08-30 firmware: drivers: cy15x102qn: Fixing the implementation according to the unit tests #260
    [cy15x102qn.c, version.h]
2021-08-31 firmware: tests: drivers: cy15x102qn: Simplifying the implementation #276
2021-09-01 Adding a workflow to execute the unit tests of the drivers
2021-09-01 firmware: tests: drivers: Adding an unit test for the TPS382x driver. closes #277
2021-09-01 firmware: tests: drivers: Initial structure of the unit test of TCA4311A #278
2021-09-01 firmware: tests: drivers: Implementation of the unit test of the CY15x102QN driver. closes #276
2021-09-02 firmware: tests: drivers: Initial structure of the unit test of the EDC driver #279
2021-09-02 firmware: drivers: edc: Fixing the implementation according to the unit test #23
    [edc.h, version.h]
2021-09-02 firmware: tests: drivers: Initial structure of the ISIS Antenna driver #280
2021-09-03 firmware: tests: drivers: tca4311a: Implementation of the test. closes #278
2021-09-03 firmware: tests: drivers: Initial structure of the unit test of the SpaceLab EPS 2.0 driver #284
2021-09-04 firmware: tests: drivers: edc: Implementation of the unit test #279
2021-09-04 firmware: tests: drivers: edc: Implementation of the unit test. closes #279
2021-09-04 firmware: tests: drivers: Initial structure of the unit test of the Si446x driver #285
2021-09-05 firmware: tests: drivers: Implementation of the unit test of the ISIS Antenna driver #280
2021-09-05 firmware: tests: drivers: Initial structure of the unit test of the MT25Q driver #286
2021-09-06 firmware: tests: drivers: Fixing the EDC unit test
    [edc_test.c]
2021-09-08 firmware: tests: drivers: Initial structure of the unit test of the SpaceLab TTC 2.0 driver #287
2021-09-10 firmware: tests: drivers: Implementation of the unit test of the ISIS Antenna driver. closes #280
2021-09-10 firmware: drivers: isis_antenna: Fixing and improving the implementation according to the unit tests
    [isis_antenna.c, version.h]
2021-09-10 firmware: tests: drivers: Improving the EDC driver unit test
2021-09-10 firmware: drivers: edc: Minor fixes
    [edc.c, version.h]
2021-09-11 firmware: tests: drivers: Implementation of the unit test of the SI446x driver #285
2021-09-11 firmware: drivers: si446x: Minor fixes according to the unit tests #55
    [version.h]
2021-09-12 firmware: tests: drivers: Implementation of the unit test of the SI446x driver. closes #285
2021-09-12 firmware: tests: drivers: si446x: Minor fix
2021-09-18 firmware: tests: drivers: Implementation of the unit test of the SpaceLab TTC 2.0 driver #287
2021-09-18 firmware: drivers: sl_ttc2: Fixing the driver according to the unit tests
    [sl_ttc2.c, version.h]
2021-09-19 firmware: tests: drivers: Fixing the unit test of the si446x driver
2021-09-19 firmware: drivers: sl_ttc2: Fixing the implementation according to the unit tests
    [sl_ttc2.c, version.h]
2021-09-23 firmware: tests: drivers: Implementation of the unit test of the SpaceLab EPS 2.0 driver #284
2021-09-23 firmware: tests: drivers: Fixing the unit test of the SpaceLab TTC 2.0 driver #287
    [sl_ttc2.c, sl_ttc2_test.c, version.h]
2021-09-23 firmware: tests: drivers: Implementation of the unit test of the SpaceLab TTC 2.0 driver. closes #287
2021-09-24 firmware: tests: drivers: Implementation of the unit test of the SpaceLab EPS 2.0 driver. closes #284
2021-09-24 firmware: drivers: sl_eps2: General fixes according to the unit tests
    [sl_eps2.c, version.h]
2021-09-26 firmware: tests: drivers: Adding the implementation of the unit test of the MT25Q driver #286
2021-09-26 firmware: drivers: mt25q: Fixing the name of the flash description variable
    [mt25q.c, version.h]
2021-09-27 firmware: tests: devices: Improving the unit test of the media device #271
2021-09-27 firmware: tests: devices: Implementation of the unit test of the EPS device #270
2021-09-27 firmware: devices: eps: Implementation of the device #110
2021-09-28 firmware: tests: mockups: Implmentation of the mockup of the SpaceLab EPS 2.0 driver #209
2021-09-28 firmware: tests: mockups: Implmentation of the mockup of the SpaceLab TTC 2.0 driver #209
2021-09-28 firmware: tests: devices: Implementation of the unit test of the TTC device. closes #269
2021-09-28 firmware: devices: ttc: Fixing the device according to the unit tests
    [ttc.c, version.h]
2021-09-29 firmware: Fixing the code standard of the main files according to the MISRAC-C:2012 rules
    [clocks.c, clocks.h, main.c, version.h]
2021-09-30 Enabling MISRA-C check in the static analysis of the devices source files #274
2021-09-30 firmware: devices: Making the source files compliant with the MISRAC-C:2012 standard
2021-10-01 firmware: tests: devices: Fixing the unit test of the media device #271
    [media_test.c]
2021-10-01 firmware: tests: devices: Fixing the unit test of the radio device
2021-10-01 firmware: devices: radio: Fixing the recv function #56
    [version.h]
2021-10-01 firmware: devices: media: Minor fix #149
2021-10-01 firmware: drivers adc: Making the source files compliant with the MISRAC-C:2012 standard #209
2021-10-01 firmware: drivers: cy15x102qn: Making the source files compliant with the MISRAC-C:2012 standard
2021-10-01 firmware: drivers: wdt: Making the source files compliant with the MISRAC-C:2012 standard
2021-10-01 firmware: drivers: uart: Making the source files compliant with the MISRAC-C:2012 standard
2021-10-02 firmware: drivers: tca4311a: Making the source files compliant with the MISRAC-C:2012 standard
2021-10-02 firmware: drivers: spi: Making the source files compliant with the MISRA-C:2012 standard
2021-10-02 firmware: drivers: sl_ttc2: Making the source files compliant with the MISRA-C:2012 standard
2021-10-03 firmware: drivers: sl_eps2: Making the source files compliant with the MISRA-C:2012 standard
2021-10-03 firmware: drivers: si446x: Making the source files compliant with the MISRA-C:2012 standard #55
2021-10-03 firmware: drivers: rtc: Making the source files compliant with the MISRA-C:2012 standard #231
2021-10-03 firmware: drivers: edc: Making the source files compliant with the MISRA-C:2012 standard
2021-10-03 firmware: drivers: flash: Making the source files compliant with the MISRA-C:2012 standard
2021-10-03 firmware: drivers: gpio: Making the source files compliant with the MISRA-C:2012 standard
2021-10-03 firmware: tests: drivers: Updating the unit test of the si446x driver
2021-10-03 firmware: drivers: i2c: Making the source files compliant with the MISRA-C:2012 standard
2021-10-05 firmware: drivers: mt25q: Making the source files compliant with the MISRA-C:2012 standard
2021-10-05 firmware: drivers: mt25q: Fixing the calculation of the total memory size from the fdo data
    [mt25q.c, version.h]
2021-10-05 firmware: drivers: Initial implementation of the Payload-X driver #131
2021-10-05 firmware: drivers: isis_antenna: Making the source files compliant with the MISRA-C:2012 standard
2021-10-05 firmware: drivers: sl_eps: Making the source files compliant with the MISRA-C:2012 standard #168
2021-10-05 Enabling MISRA-C check in the static analysis of the drivers source files #274
2021-10-09 firmware: config: Disabling the radio reset task
    [config.h]
2021-10-11 firmware: tests: mockups: drivers: Adding a mockup of the TCA4311A driver #209 #289
2021-10-11 firmware: tests: drivers: Updating the unit test of the ISIS Antenna driver #289
2021-10-11 firmware: drivers: isis_antenna: Isolating the I2C access functions and using the TCA4311A buffer to access the I2C bus. closes #289
2021-10-12 firmware: tests: mockups: Updating the implementation of the ISISpace Antenna driver mockup #209
2021-10-12 firmware: tests: devices: Implementation of the unit test of the antenna device. closes #215
2021-10-12 firmware: devices: Implementation of the antenna device. closes #114
2021-10-14 firmware: tests: drivers: Updating the unit test of the ISIS Antenna driver
2021-10-14 firmware: drivers: isis_antenna: Adding a function to read all data and a function to read the temperature in Kelvin
2021-10-15 firmware: tests: devices: Updating the unit test of the antenna device. closes #209
2021-10-15 firmware: devices: antenna: Updating the device implementation according to the updates of the ISIS Antenna driver, and adding a flag to indicate if the device is open or not
2021-10-15 firmware: app: tasks: Adding a task to periodically read the antenna data. closes #296
2021-10-15 firmware: drivers: Making the source files fully compliant with MISRA-C:2012 standard #297
2021-10-15 firmware: app: tasks: Decreasing the priority of the "read antenna" task
2021-10-16 firmware: devices: Making the source files fully compliant with MISRA-C:2012 standard #297
2021-10-16 firmware: tests: drivers: Updating the unit test of the SpaceLab EPS 2.0 driver
2021-10-16 firmware: drivers: sl_eps2: Moving the I2C access functions to a separate module
2021-10-16 firmware: drivers: sl_ttc2: Moving the SPI access functions to a separate module
2021-10-18 firmware: tests: drivers: Updating the unit test of the EDC driver #279
2021-10-18 firmware: drivers: edc: Moving the I2C access functions to a separate module
2021-10-18 firmware: tests: Updating the unit test of the payload device and the mockup of the EDC driver #273
2021-10-18 firmware: devices: payload: Updating the access functions of the EDC driver #272
2021-10-19 firmware: drivers: edc: Adding "enable" and "disable" functions
2021-10-19 firmware: tests: devices: Updating the unit test of the payload device #273
2021-10-19 firmware: devices: payload: Adding a second EDC to the payload device #272
2021-10-20 firmware: devices: payload: Removing the disabling routine in the EDC initialization #272 #273
2021-10-26 firmware: tests: Updating the unit test of the tps382x driver
2021-10-26 firmware: drivers: tps382x: Adding a function to perform a manual reset
    [tps382x.c, tps382x.h, version.h]
2021-10-31 firmware: app: tasks: process_tc: Adding the implementation of the TC "Force reset" #275
    [process_tc.c, version.h]
2021-11-16 firmware: devices: eps: Adding the functions "set parameter" and "get parameter" #110
2021-11-16 firmware: tests: devices: eps: Adding an unit test for the function "set parameter" and "get parameter" #270
2021-11-16 firmware: devices: ttc: Adding the functions "set parameter" and "get parameter"
2021-11-16 firmware: tests: devices: ttc: Adding an unit test for the function "set parameter" and "get parameter"
2021-11-18 firmware: app: tasks: Initial structure of the task "Antenna Deployment" #301
2021-11-19 firmware: app: tasks: antenna_deployment: Implementation of the initial hibernation and antenna deployment routines. closes #301
2021-12-01 firmware: drivers: tca4311a: Removing the "READY" pin reading during I2C operations
2021-12-01 firmware: tests: drivers: Updating the unit test of the TCA4311A driver
2021-12-01 firmware: drivers: sl_eps2: Keeping the I2C buffer always enabled
2021-12-09 firmware: drivers: sl_eps2: Increasing the delay between writing and reading operations
2022-03-14 firmware: tests: devices: Updating the unit test of the EDC payload device with the driver routine "edc_set_rtc_time" during the initialization #273
2022-03-14 firmware: devices: payload: Configuring the RTC time of the EDC during the initialization
2022-03-15 firmware: drivers: edc: edc_uart.c created #310
2022-03-15 firmware: drivers: edc: Implementing UART mode to EDC #310
2022-03-15 firmware: drivers: edc: Minor improvements #310
2022-04-07 firmware: drivers: edc: fixing small erros #310
    [edc.c, edc.h, edc_i2c.c]
2022-04-07 firmware: devices: payload: fixing small errors
    [payload.c]
2022-04-11 firmware: tests: drivers: Updating edc_init() unit test #310
2022-04-12 firmware: tests: drivers: Fixing the compilation of the EDC driver test in the Makefile #310
2022-04-12 firmware: tests: drivers: Updating edc_write_cmd_test() #310
2022-04-13 firmware: tests: drivers: Updating edc_read_test() #310
2022-04-19 firmware:drivers:Fixing the crc calculation
    [i2c.c, sl_eps2.c]
2022-04-22 doc: Initial structure of the v0.7 board test report #313
2022-04-23 doc: appendices: Adding the results of the visual inspection test of the v0.7 board #313
2022-04-24 firmware: drivers: uart: Importing the UART driver from the TTC 2.0 repo #310
2022-04-24 firmware: drivers: uart: Adapting the imported driver #310
2022-04-24 firmware: drivers: edc: Implementation of the UART interface functions #310
2022-04-24 firmware: tests: mockups: drivers: Updating the mockup of the UART driver #310
2022-04-24 firmware: tests: drivers: Updating the UART mockup functions of the EDC driver #310
2022-04-24 firmware: drivers: edc: Enabling the UART RX during the UART interface initialization #310
2022-05-02 doc: appendices: Adding the results of the communication busses test of the v0.7 board #313
2022-05-02 firmware: tests: drivers: updating edc unit test #310
2022-05-03 firmware: tests: drivers: adding edc_uart_rx_available_test #310
2022-05-03 firmware: tests: mockups: drivers: updating uart_wrap.c #310
2022-05-03 firmware: tests: drivers: Code style fixes in the unit test of the EDC driver #310
    [edc_test.c]
2022-05-03 firmware: tests: devices: updatind payload_test.c #310
2022-05-03 firmware: tests: mockups: drivers: updating edc_wrap.c #310
2022-05-05 firmware: tests: mockups: drivers: Updating the mockup of the EDC driver #310
2022-05-05 firmware: tests: devices: Updating the unit test of the payload device #310
2022-05-05 firmware: devices: payload: Changing the EDC interface to UART #310
2022-05-10 firmware: drivers: Removing unused variable
2022-05-10 firmware: drivers: cy15x102qn: including missing files
    [cy15x102qn.c]
2022-05-12 firmware: drivers: edc: Updating EDC driver
2022-05-13 firmware: drivers: edc: Updating the HK package
2022-05-13 firmware: devices: payload: Updating the telemetry messages during the EDC initialization #272
2022-05-13 firmware: tests: drivers: Updating the unit test of the EDC driver
2022-05-13 firmware: tests: mockups: drivers: Updating the mockup of the EDC driver
2022-05-14 firmware: drivers: Making some adjustments
2022-05-14 firmware: drivers: i2c: Fixing MISRA-C rule
    [i2c.c]
2022-05-14 firmware: drivers: sl_eps2: Updating the version number
2022-05-15 firmware: devices: payload: Adding the command "get PTT pkg" of the EDC payload #272
2022-05-15 firmware: tests: mockups: drivers: Adding the implementation of the function "edc_get_ptt" to the mockup of the EDC driver
2022-05-15 firmware: devices: payload: Adding the commands "get state", "get hk" and "get PTT" of the EDC payload #272
2022-05-15 firmware: devices: payload: Enabling the PTT task during the EDC initialization #272
2022-05-15 firmware: devices: payload: Executing the command "pop" after reading a PTT package of the EDC payload #272
2022-05-27 firmware: tests: drivers: Updating the unit test of the EDC driver (adding a "UART flush" before all write operations)
2022-05-27 firmware: drivers: edc: Adding a "UART flush" before all "UART write" operations
2022-05-27 firmware: tests: drivers: Updating the unit test of the "echo" command of the EDC driver
2022-05-27 firmware: drivers: edc: Updating the implementation of the "ECHO" command
2022-06-02 firmware: app: tasks: Fixing the period of the "read_edc" task #175
    [read_edc.h, version.h]
2022-06-05 firmware: drivers: spi: Adding the CS pin 5
2022-06-27 firmware: drivers: spi: Fixing the initialization of the CS 5 pin
    [spi.c, version.h]
2022-08-09 firmware: devices: Removing the radio device. closes #56
2022-08-09 firmware: tests: Removing the radio device related tests
2022-08-09 firmware: drivers: Removing the si446x driver. closes #55
