spacelab-ufsc/obdh2/(notices)

Notices in the files:
firmware/drivers/isis_antenna/isis_antenna.c:
OBDH 2.0 is free software: you can redistribute it and/or modify
it under the terms of the GNU General Public License as published by
the Free Software Foundation, either version 3 of the License, or
(at your option) any later version.
hardware/README.md:
License: cern ohl 2
firmware/README.md:
License: GPL3
